SpaceTeam/STS1_EPS/(threads)

Thread 7 (2023-05-27):

Try to use other connector to the side PCBs

McBrez, 2023-05-27:
The main goal is to place the connectors on the side of the side PCB it has to connect to. The connector most likely will have to be changed, as currently there is not enough space to place them where they should be. Harwin Gecko connectors or flat flex cables could be used.

Closed 2024-09-05.

Thread 13 (2023-06-18):

Check if there is a better solution for the inter-EPS connectors

McBrez, 2023-06-18:
Currently, SAMTEC connectors are used for the connection between the two EPS boards. They have to be stacked, as there is no standard connector with the appropriate height. This is not feasible for the flight model. An alternative has to be found, that is still compatible to the CSBI specification.

Thread 15 (2024-09-04):

D12,14,15,16,17 missing value

XDjackieXD, 2024-09-04:
These diodes have no value set.

McBrez, 2024-09-05:
Fixed in commit ff7a148.

Closed 2024-10-12.

Thread 16 (2024-09-04):

Label naming confusing

XDjackieXD, 2024-09-04:
For example the Label "Bat+" and "Bat+_UCI" in the Solar Cell Connectors sheet are very confusing as Bat+ is the input from the UCI. Not Bat+_UCI.

Please define a naming schema and then stick to it.

asmolyanyuk, 2024-09-07:
On the board 1 there is a mismatch between the panel connector labels and the labels for their pin-outs . For example, Panel Z- has pin-outs marked as Panel_X+.

McBrez, 2024-09-14:
Original issue is fixed in  a812255. Created issue #28 for @asmolyanyuk  's comment.

Thread 17 (2024-09-04):

TPS259472ARPW for UART?

XDjackieXD, 2024-09-04:
Has someone tested that it works with an UART connection? The stray capacitance and turn on delay is extremely high so I suspect that it wont work (this UART has to work up to 115200 baud).

The usual solution for UART protection is a Zener/TVS Diode and a 100Ohm series resistor.

McBrez, 2024-09-14:
Removed TSP259472ARPW. Added TVS diodes to the UART lines. Didn't place 100Ohm resistor, as there is already on the COBC.
3b45b82

Thread 18 (2024-09-04):

Define tolerance for current limiting resistors on TPS259472ARPW

XDjackieXD, 2024-09-04:
As these resistors are also used as a shunt for the current measurement, please defined a required tolerance

McBrez, 2024-09-14:
Fixed in 0330bb5.

Closed 2024-10-12.

Thread 19 (2024-09-04):

Define tolerances for all critical resistors

XDjackieXD, 2024-09-04:
- Shunts
- Feedback-Networks (for example battery voltage measurement)
- Setpoint resistors for current sources

McBrez, 2024-09-14:
Fixed in e92d536.

Closed 2024-10-12.

Thread 20 (2024-09-04):

LTC4451AV ~{SHDN} on U28

XDjackieXD, 2024-09-04:
The way it is currently wired, the cubesat will be dead if the battery charger is dead, even if MPPT_BUS would still deliver enough power for some operation, because U28 is held in shutdown if VOUT is below 0.4V.

Closed 2024-10-12.

Thread 21 (2024-09-04):

Board2 D2 missing value

XDjackieXD, 2024-09-04:

McBrez, 2024-09-14:
Fixed in eb479fc2ec7f47cb72f877a4045a140e3c46f35d

Closed 2024-10-12.

Thread 22 (2024-09-04):

Mark all "bypass" resistors DNP

XDjackieXD, 2024-09-04:
KiCAD allows marking components as "Do not Populate". Use this feature to signify how it should be assembled on the flight model!

McBrez, 2024-09-14:
Fixed in 4a6f72a.

Closed 2024-10-12.

Thread 23 (2024-09-04):

Board2 Capacitor Bank Values missing

XDjackieXD, 2024-09-04:

McBrez, 2024-09-16:
Added capacitor values in d15ebe5.

Closed 2024-10-12.

Thread 24 (2024-09-04):

Board2 logic supply same issue as #20

XDjackieXD, 2024-09-04:
https://github.com/SpaceTeam/STS1_EPS/issues/20

McBrez, 2024-09-17:
Fixed in e0c62bc.

Closed 2024-10-12.

Thread 26 (2024-09-04):

Board2 Fuse F1 missing value

XDjackieXD, 2024-09-04:

McBrez, 2024-09-16:
Added part number in 04b165d.

Closed 2024-10-12.

Thread 27 (2024-09-04):

Board2 TPS2420RSAT max IO port input voltage

XDjackieXD, 2024-09-04:
Max input voltage of any logic input of the TPS2420RSAT is 5V.
The gate that inputs into it is supplied by V_LOGIC which - as far as I can tell - can be significantly above 5V.

McBrez, 2024-09-17:
Fixed in e0c62bc.

McBrez, 2024-09-18:
Added a linear regulator in b77aafa.

Closed 2024-10-12.

Thread 28 (2024-09-14):

Labels of panel connector are incorrect

McBrez, 2024-09-14:
The names of the labels on the panel connectors in STS_EPS_SC_Connectors.kicad_sch do not fit to the connector name. E.g.:  Connector J5 (Panel Z-) has labels called Panel_X+_*.

McBrez, 2024-10-12:
Fixed in [2f7f0c2](https://github.com/SpaceTeam/STS1_EPS/pull/29/commits/2f7f0c2d60b10a83120f11ea3d8951cb98012708).

Closed 2024-10-12.
