SpaceTeam/STS1_EPS/sim/battery_charge_controller.asc

C1: cap; 2µ2
C2: cap; 1µ
C3: cap; 1µ
C4: cap; 1µ
C5: cap; 100n
C6: cap; 680µ
C7: cap; 680p
C8: cap; 680p
C9: cap; 100p
C11: cap; 220n
C12: cap; 330n
C13: cap; 10
D1: schottky; RB218NS-30
D2: schottky; RBQ20NS100A
L1: ind; 680n
M1: nmos
M2: nmos
M3: nmos
M4: nmos
M5: pmos4
R1: res; 28k
R2: res; 100k
R3: res; 25k
R4: res; 25k
R5: res; 17k8
R6: res; 30k9
R7: res; 100k
R8: res; 100k
R9: res; 499k
R10: res; 200k
R11: res; 200k
R12: res; 400k
R13: res; 200k
R14: res; 50k
R15: res; 50k
R16: res; 10m
R17: res; 10m
R18: res; 10m
R19: res; 100
R20: res; 100
U1: LTC4020
V1: voltage; 5; Rser=20m
Named nets: 0, IntVcc, SW1, SW2, BST1, BST2, BAT, VFB, VFBG, PVIN, RNGSS, ILIMIT, CSP, VFBMIN, VFBMAX, VINREG, VIN, SHDN, ITH, VC, TG1, BG1, TG2, BG2, SENSBOT, SENSVIN, SENSTOP, SENSGND, CSN, BGATE
.tran 100 uic
