SpaceTeam/STS1_EPS/pcbs/STS1_EPS_1.kicad_pcb

## KiCad design pcbs/STS1_EPS_1.kicad_pcb (2025-09-17)

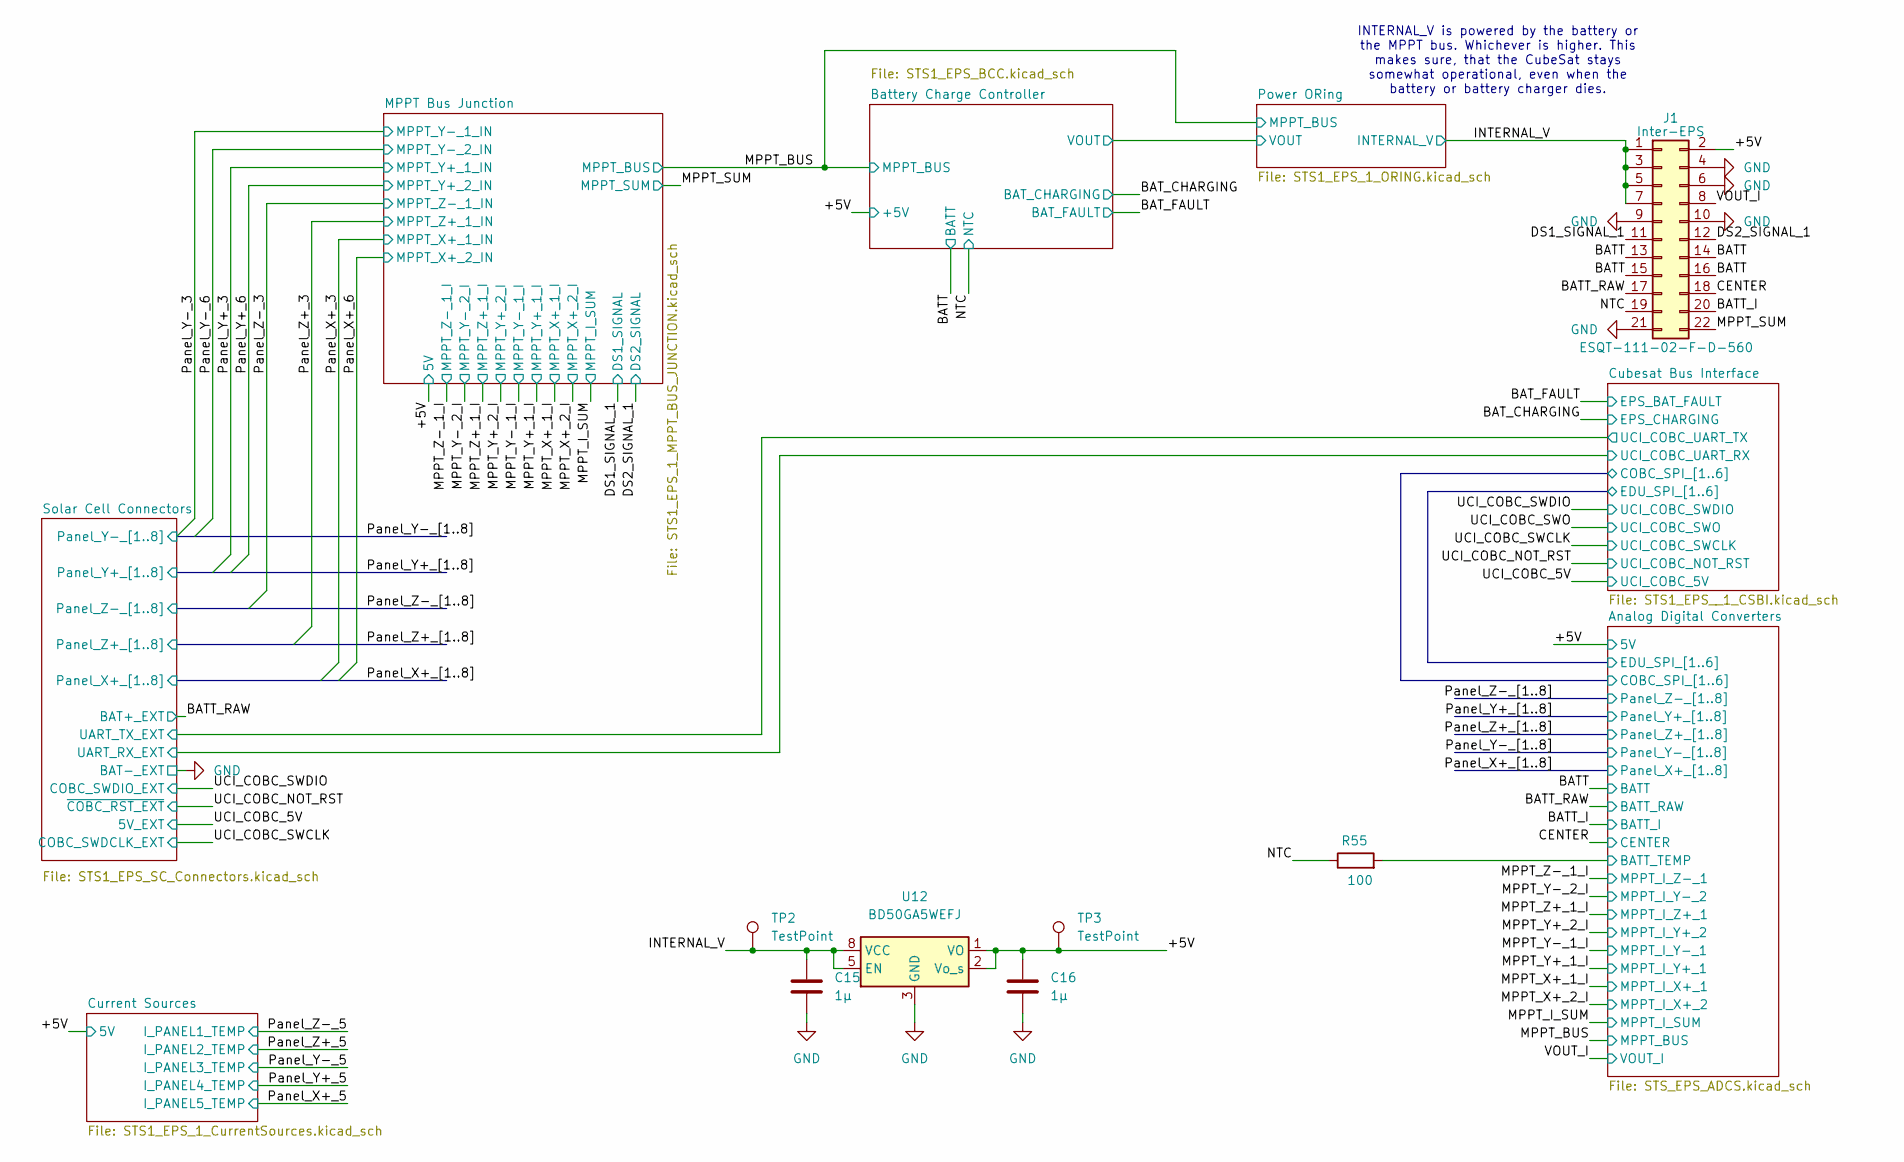
[picture p1: schematic STS1_EPS_1.kicad_sch]

Parts:
C15, C16: 1µ; C_0805_2012Metric; Part Nr. C0805T105K4RALTU
J1: Inter-EPS; PinHeader_2x11_P2.00mm_Vertical; Part# ESQT-111-02-F-D-560
R55: 100; R_0805_2012Metric; Part Nr. TNPW0805100KFEEA
TP2, TP3: TestPoint; TestPoint_THTPad_D1.0mm_Drill0.5mm
U12: BD50GA5WEFJ; HTSOP-8-1EP_3.9x4.9mm_P1.27mm_EP2.4x3.2mm

Connections:
/+5V: C16.1, J1.2, TP3.1, U12.1 (VO), U12.2 (Vo_s); also elsewhere on the board
/Analog Digital Converters/BATT_TEMP: R55.2; also elsewhere on the board
/BATT: J1.13, J1.14, J1.15, J1.16; also elsewhere on the board
/BATT_I: J1.20; also elsewhere on the board
/BATT_RAW: J1.17; also elsewhere on the board
/CENTER: J1.18; also elsewhere on the board
/DS1_SIGNAL_1: J1.11; also elsewhere on the board
/DS2_SIGNAL_1: J1.12; also elsewhere on the board
/INTERNAL_V: C15.1, J1.1, J1.3, J1.5, J1.7, TP2.1, U12.5 (EN), U12.8 (VCC); also elsewhere on the board
/MPPT_SUM: J1.22; also elsewhere on the board
/NTC: J1.19, R55.1; also elsewhere on the board
/VOUT_I: J1.8; also elsewhere on the board
GND: C15.2, C16.2, J1.4, J1.6, J1.9, J1.10, J1.21, U12.3 (GND), U12.4 (GND), U12.6 (GND), U12.7 (GND), U12.9 (GND); also elsewhere on the board

Notes on the sheet:
INTERNAL_V is powered by the battery or the MPPT bus. Whichever is higher. This makes sure, that the CubeSat stays somewhat operational, even when the battery or battery charger dies.

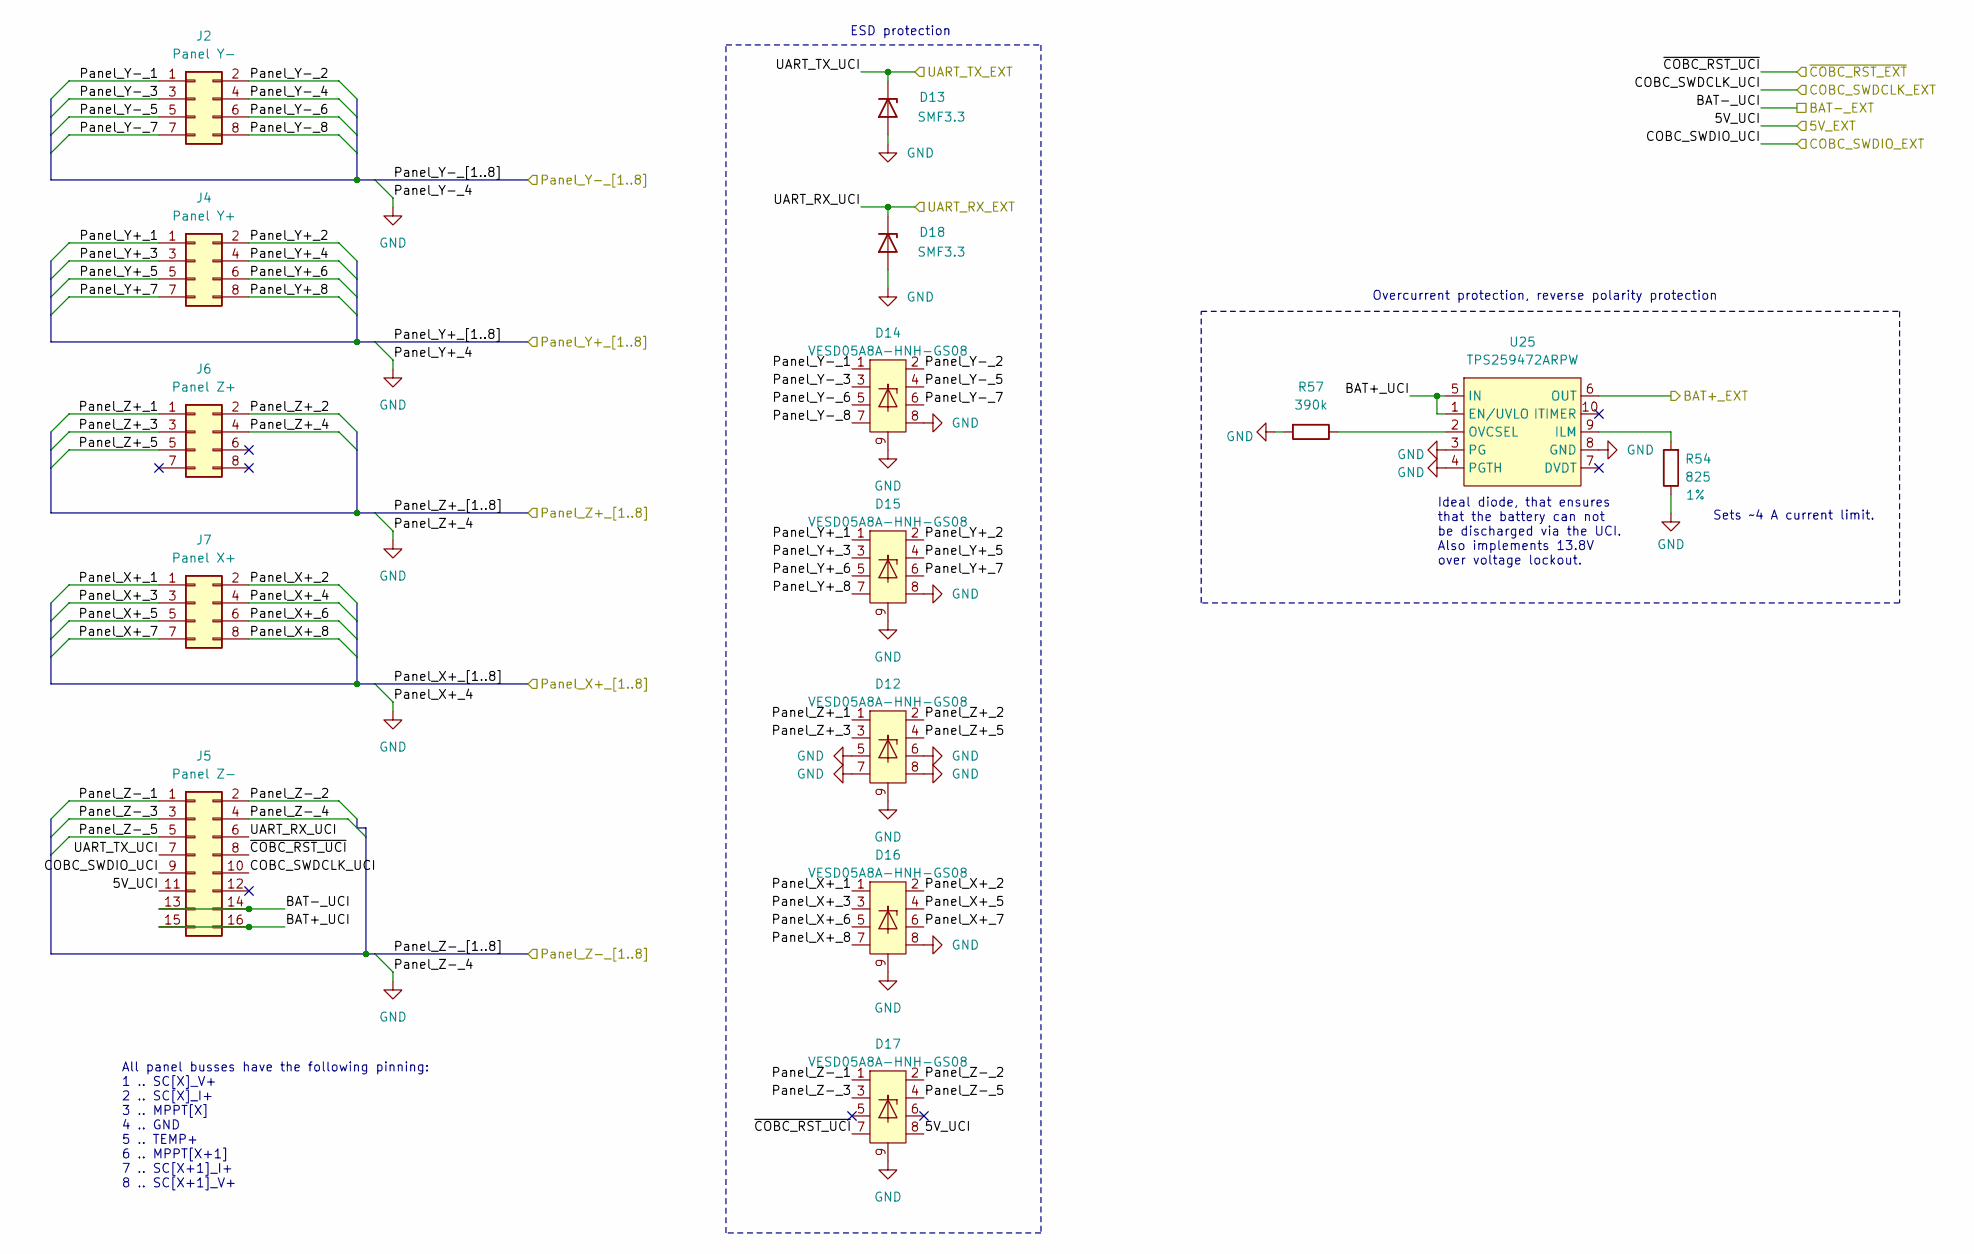
[picture p2: schematic STS1_EPS_SC_Connectors.kicad_sch]

Parts:
D12, D14, D15, D16, D17: VESD05A8A-HNH-GS08; LLP1713-9L
D13, D18: SMF3.3; D_SOD-123; Part Nr. SMF3.3
J2: Panel Y-; SAMTEC_ZF5S-08-03-T-WT; Part Nr. SAMTEC_ZF5S-08-03-T-WT
J4: Panel Y+; SAMTEC_ZF5S-08-03-T-WT; Part Nr. SAMTEC_ZF5S-08-03-T-WT
J5: Panel Z-; SAMTEC_ZF5S-16-03-T-WT; Part Nr. SAMTEC_ZF5S-08-03-T-WT
J6: Panel Z+; SAMTEC_ZF5S-08-03-T-WT; Part Nr. SAMTEC_ZF5S-08-03-T-WT
J7: Panel X+; SAMTEC_ZF5S-08-03-T-WT; Part Nr. SAMTEC_ZF5S-08-03-T-WT
R54: 825; R_0805_2012Metric; Tolerance 1%; Part Nr. RT0805FRE07825RL
R57: 390k; R_0805_2012Metric; Part Nr. RN73R2ATTD3903F25
U25: TPS259472ARPW; TPS259472ARPWR

Connections:
/BATT_RAW: U25.6 (OUT); also elsewhere on the board
/Panel_X+_1: D16.1, J7.1; also elsewhere on the board
/Panel_X+_2: D16.2, J7.2; also elsewhere on the board
/Panel_X+_3: D16.3, J7.3; also elsewhere on the board
/Panel_X+_5: D16.4, J7.5; also elsewhere on the board
/Panel_X+_6: D16.5, J7.6; also elsewhere on the board
/Panel_X+_7: D16.6, J7.7; also elsewhere on the board
/Panel_X+_8: D16.7, J7.8; also elsewhere on the board
/Panel_Y+_1: D15.1, J4.1; also elsewhere on the board
/Panel_Y+_2: D15.2, J4.2; also elsewhere on the board
/Panel_Y+_3: D15.3, J4.3; also elsewhere on the board
/Panel_Y+_5: D15.4, J4.5; also elsewhere on the board
/Panel_Y+_6: D15.5, J4.6; also elsewhere on the board
/Panel_Y+_7: D15.6, J4.7; also elsewhere on the board
/Panel_Y+_8: D15.7, J4.8; also elsewhere on the board
/Panel_Y-_1: D14.1, J2.1; also elsewhere on the board
/Panel_Y-_2: D14.2, J2.2; also elsewhere on the board
/Panel_Y-_3: D14.3, J2.3; also elsewhere on the board
/Panel_Y-_5: D14.4, J2.5; also elsewhere on the board
/Panel_Y-_6: D14.5, J2.6; also elsewhere on the board
/Panel_Y-_7: D14.6, J2.7; also elsewhere on the board
/Panel_Y-_8: D14.7, J2.8; also elsewhere on the board
/Panel_Z+_1: D12.1, J6.1; also elsewhere on the board
/Panel_Z+_2: D12.2, J6.2; also elsewhere on the board
/Panel_Z+_3: D12.3, J6.3; also elsewhere on the board
/Panel_Z+_5: D12.4, J6.5; also elsewhere on the board
/Panel_Z-_1: D17.1, J5.1; also elsewhere on the board
/Panel_Z-_2: D17.2, J5.2; also elsewhere on the board
/Panel_Z-_3: D17.3, J5.3; also elsewhere on the board
/Panel_Z-_5: D17.4, J5.5; also elsewhere on the board
/Solar Cell Connectors/BAT+_UCI: J5.15, J5.16, U25.1 (EN/UVLO), U25.5 (IN)
/Solar Cell Connectors/UART_RX_UCI: D18.1 (K), J5.6; also elsewhere on the board
/Solar Cell Connectors/UART_TX_UCI: D13.1 (K), J5.7; also elsewhere on the board
/UCI_COBC_5V: D17.8, J5.11; also elsewhere on the board
/UCI_COBC_NOT_RST: D17.7, J5.8; also elsewhere on the board
/UCI_COBC_SWCLK: J5.10; also elsewhere on the board
/UCI_COBC_SWDIO: J5.9; also elsewhere on the board
GND: D12.5, D12.6, D12.7, D12.8, D12.9, D13.2 (A), D14.8, D14.9, D15.8, D15.9, D16.8, D16.9, D17.9, D18.2 (A), J2.4, J4.4, J5.4, J5.13, J5.14, J6.4, J7.4, R54.1, R57.2, U25.3 (PG), U25.4 (PGTH), U25.8 (GND); also elsewhere on the board
unnamed: R54.2, U25.9 (ILM)
unnamed: R57.1, U25.2 (OVCSEL)

Notes on the sheet:
ESD protection
Overcurrent protection, reverse polarity protection
Sets ~4 A current limit.
Ideal diode, that ensures that the battery can not be discharged via the UCI. Also implements 13.8V over voltage lockout.
All panel busses have the following pinning: 1 .. SC[X]_V+ 2 .. SC[X]_I+ 3 .. MPPT[X] 4 .. GND 5 .. TEMP+ 6 .. MPPT[X+1] 7 .. SC[X+1]_I+ 8 .. SC[X+1]_V+

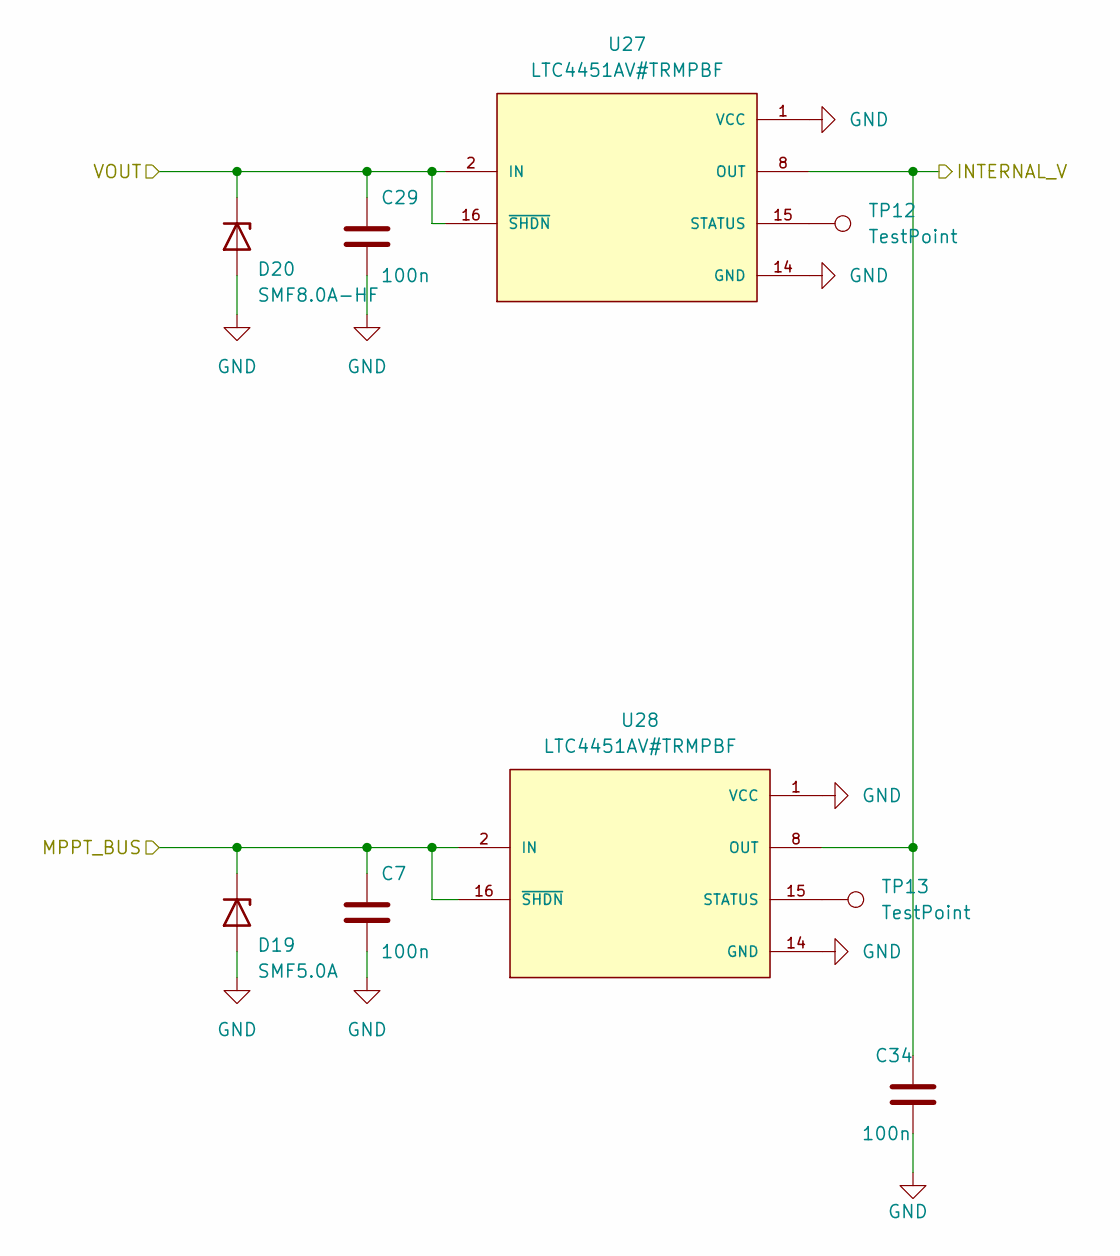
[picture p3: schematic STS1_EPS_1_ORING.kicad_sch]

Parts:
C7, C29, C34: 100n; C_0805_2012Metric; Part Nr. C0805T104K1RCLTU
D19: SMF5.0A; D_SMF; Part Nr. SMF5.0A
D20: SMF8.0A-HF; D_SOD-123F; Part Nr. SMF8.0A-HF
TP12, TP13: TestPoint; TestPoint_THTPad_D1.0mm_Drill0.5mm
U27, U28: LTC4451AV#TRMPBF; AD_LQFN-16; PARTREV 0

Connections:
/Battery Charge Controller/VOUT: C29.1, D20.1 (K), U27.2 (IN), U27.16 (~SHDN); also elsewhere on the board
/INTERNAL_V: C34.1, U27.8 (OUT), U28.8 (OUT); also elsewhere on the board
/MPPT_BUS: C7.1, D19.1 (K), U28.2 (IN), U28.16 (~SHDN); also elsewhere on the board
GND: C7.2, C29.2, C34.2, D19.2 (A), D20.2 (A), U27.1 (VCC), U27.14 (GND), U28.1 (VCC), U28.14 (GND); also elsewhere on the board
unnamed: TP12.1, U27.15 (STATUS)
unnamed: TP13.1, U28.15 (STATUS)

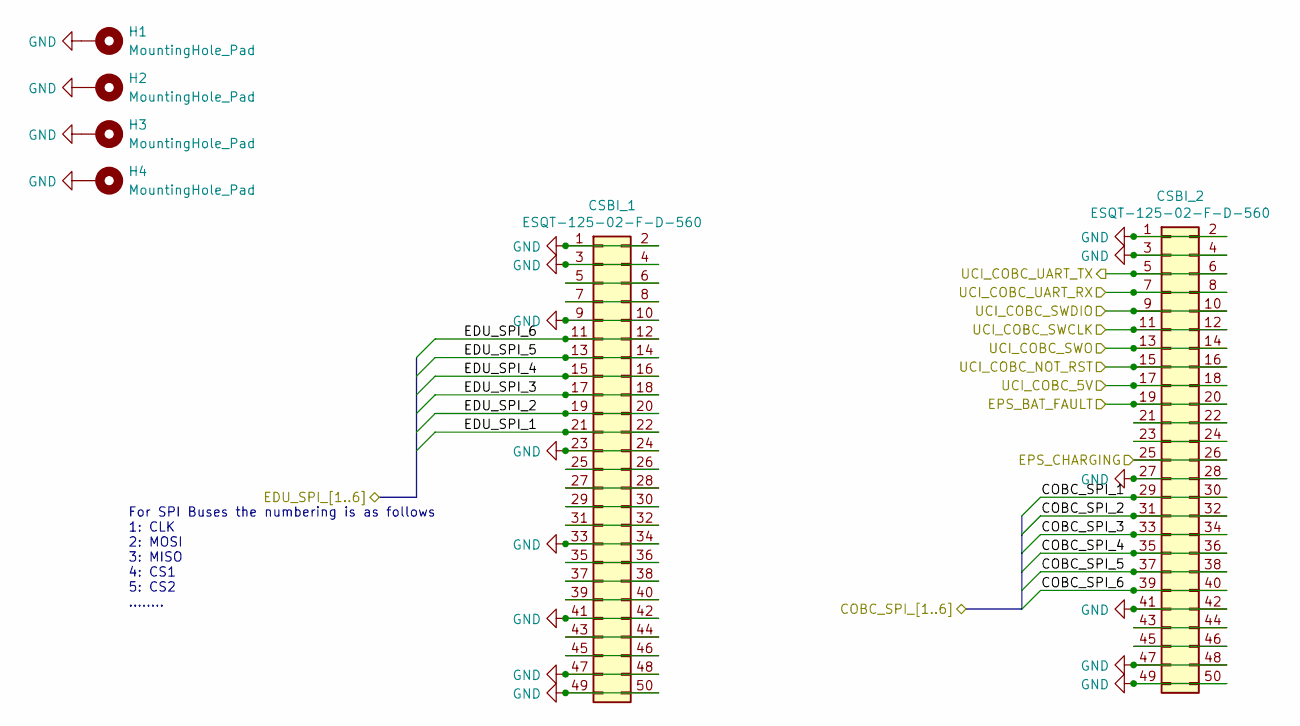
[picture p4: schematic STS1_EPS__1_CSBI.kicad_sch, STS1_connectors]

Parts:
CSBI_1, CSBI_2: ESQT-125-02-F-D-560; PinHeader_2x25_P2.00mm_Vertical; Part# ESQT-125-02-F-D-800
H1, H2, H3, H4: MountingHole_Pad; MountingHole_4.3mm_M4_Pad_Via

Connections:
/Analog Digital Converters/COBC_SPI_1: CSBI_2.29, CSBI_2.30; also elsewhere on the board
/Analog Digital Converters/COBC_SPI_2: CSBI_2.31, CSBI_2.32; also elsewhere on the board
/Analog Digital Converters/COBC_SPI_3: CSBI_2.33, CSBI_2.34; also elsewhere on the board
/Analog Digital Converters/COBC_SPI_4: CSBI_2.35, CSBI_2.36; also elsewhere on the board
/Analog Digital Converters/COBC_SPI_5: CSBI_2.37, CSBI_2.38; also elsewhere on the board
/Analog Digital Converters/COBC_SPI_6: CSBI_2.39, CSBI_2.40; also elsewhere on the board
/Analog Digital Converters/EDU_SPI_1: CSBI_1.21, CSBI_1.22; also elsewhere on the board
/Analog Digital Converters/EDU_SPI_2: CSBI_1.19, CSBI_1.20; also elsewhere on the board
/Analog Digital Converters/EDU_SPI_3: CSBI_1.17, CSBI_1.18; also elsewhere on the board
/Analog Digital Converters/EDU_SPI_4: CSBI_1.15, CSBI_1.16; also elsewhere on the board
/Analog Digital Converters/EDU_SPI_5: CSBI_1.13, CSBI_1.14; also elsewhere on the board
/Analog Digital Converters/EDU_SPI_6: CSBI_1.11, CSBI_1.12; also elsewhere on the board
/BAT_CHARGING: CSBI_2.25, CSBI_2.26; also elsewhere on the board
/BAT_FAULT: CSBI_2.19, CSBI_2.20; also elsewhere on the board
/Solar Cell Connectors/UART_RX_UCI: CSBI_2.7, CSBI_2.8; also elsewhere on the board
/Solar Cell Connectors/UART_TX_UCI: CSBI_2.5, CSBI_2.6; also elsewhere on the board
/UCI_COBC_5V: CSBI_2.17, CSBI_2.18; also elsewhere on the board
/UCI_COBC_NOT_RST: CSBI_2.15, CSBI_2.16; also elsewhere on the board
/UCI_COBC_SWCLK: CSBI_2.11, CSBI_2.12; also elsewhere on the board
/UCI_COBC_SWDIO: CSBI_2.9, CSBI_2.10; also elsewhere on the board
/UCI_COBC_SWO: CSBI_2.13, CSBI_2.14
GND: CSBI_1.1, CSBI_1.2, CSBI_1.3, CSBI_1.4, CSBI_1.9, CSBI_1.10, CSBI_1.23, CSBI_1.24, CSBI_1.33, CSBI_1.34, CSBI_1.41, CSBI_1.42, CSBI_1.47, CSBI_1.48, CSBI_1.49, CSBI_1.50, CSBI_2.1, CSBI_2.2, CSBI_2.3, CSBI_2.4, CSBI_2.27, CSBI_2.28, CSBI_2.41, CSBI_2.42, CSBI_2.47, CSBI_2.48, CSBI_2.49, CSBI_2.50, H1.1, H2.1, H3.1, H4.1; also elsewhere on the board
unnamed: CSBI_1.5, CSBI_1.6
unnamed: CSBI_1.7, CSBI_1.8
unnamed: CSBI_1.25, CSBI_1.26
unnamed: CSBI_1.27, CSBI_1.28
unnamed: CSBI_1.29, CSBI_1.30
unnamed: CSBI_1.31, CSBI_1.32
unnamed: CSBI_1.35, CSBI_1.36
unnamed: CSBI_1.37, CSBI_1.38
unnamed: CSBI_1.39, CSBI_1.40
unnamed: CSBI_1.43, CSBI_1.44
unnamed: CSBI_1.45, CSBI_1.46
unnamed: CSBI_2.21, CSBI_2.22
unnamed: CSBI_2.23, CSBI_2.24
unnamed: CSBI_2.43, CSBI_2.44
unnamed: CSBI_2.45, CSBI_2.46

Notes on the sheet:
For SPI Buses the numbering is as follows 1: CLK 2: MOSI 3: MISO 4: CS1 5: CS2 ........

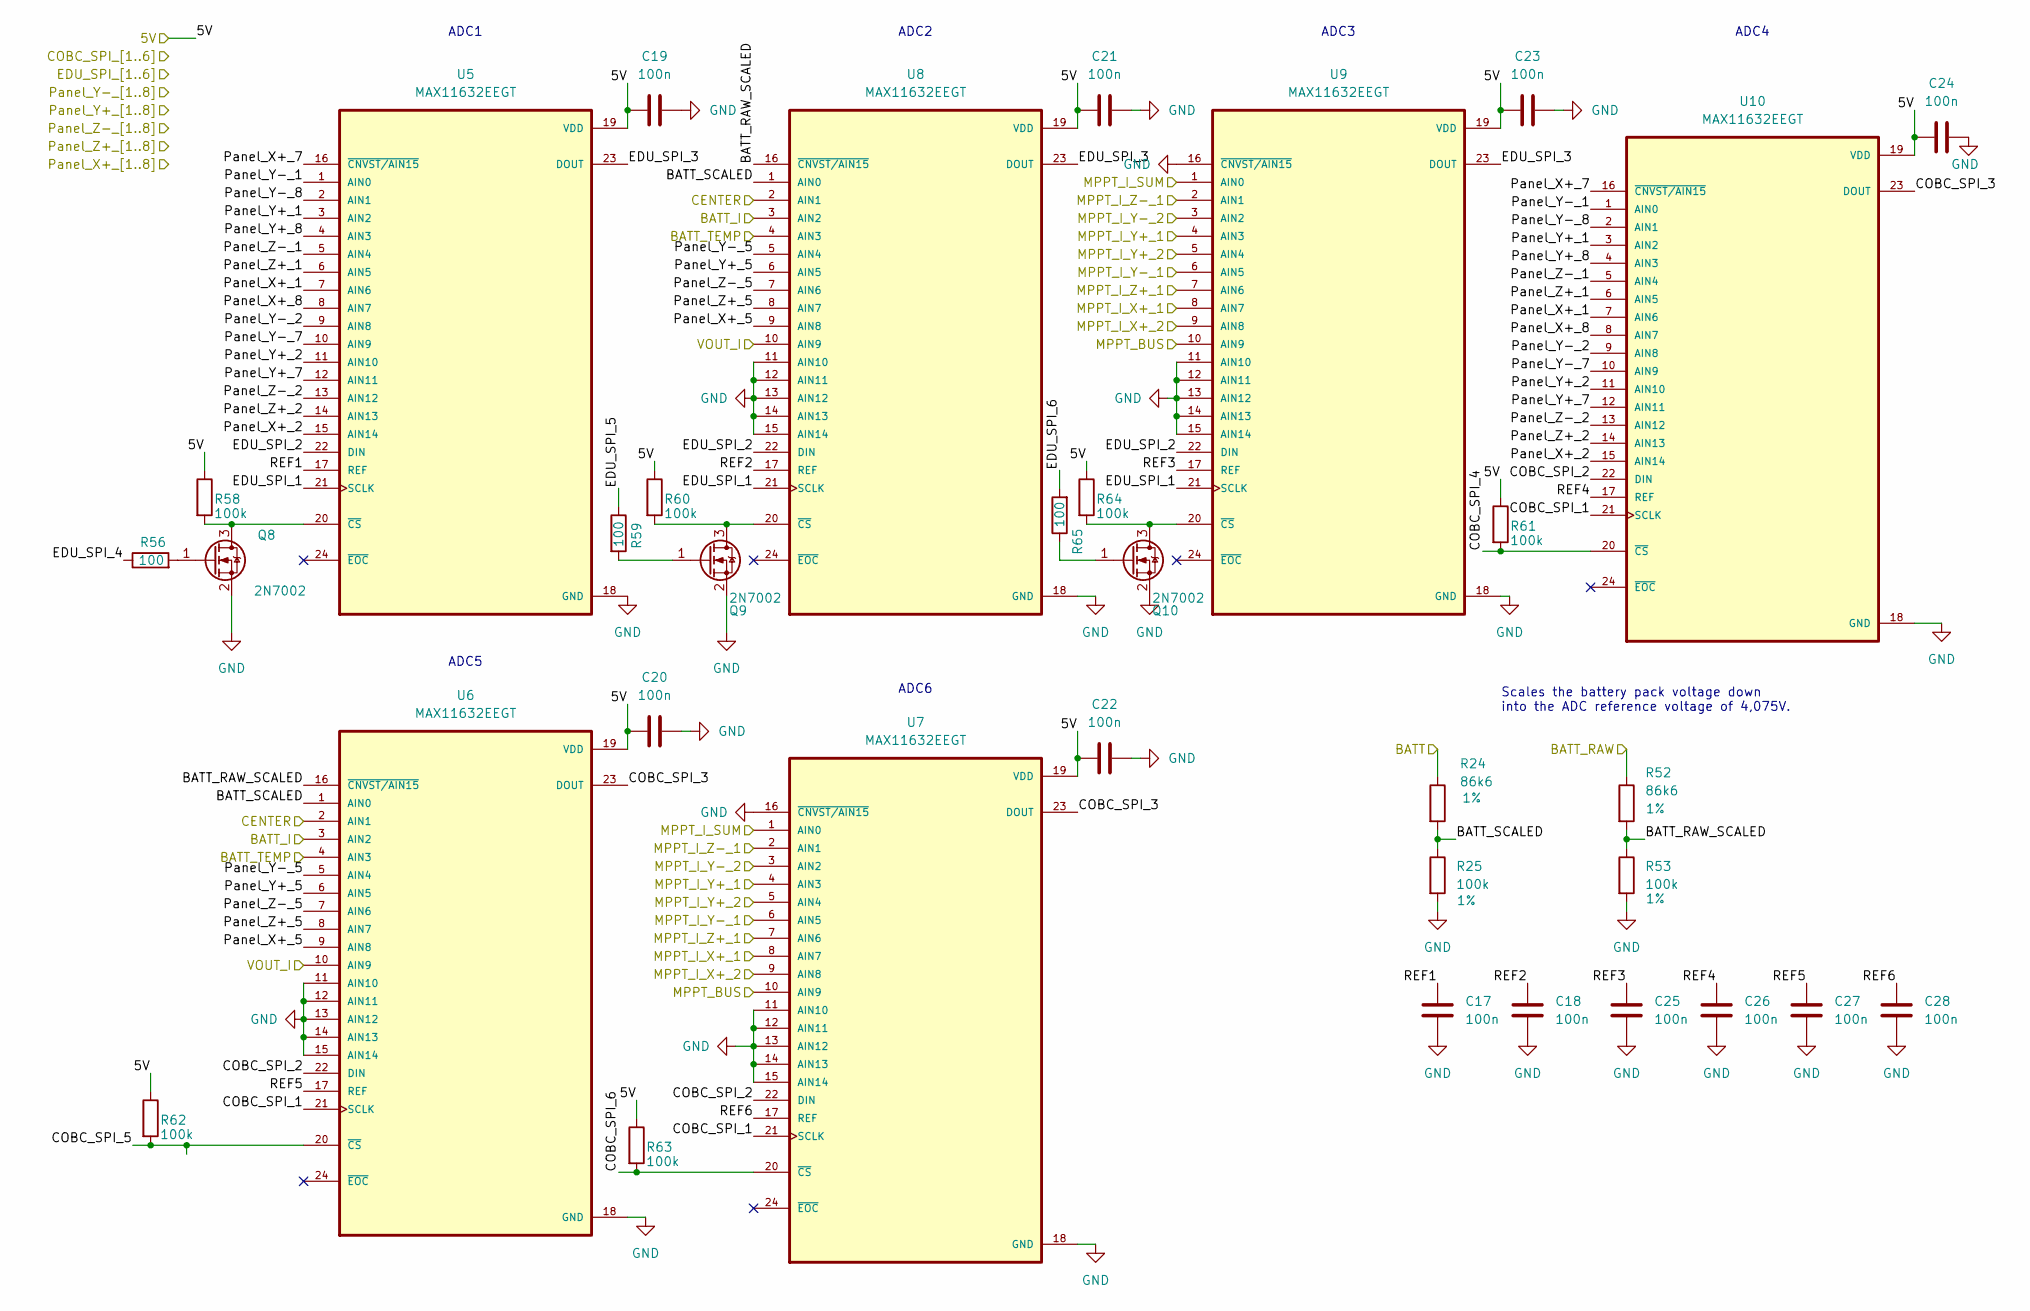
[picture p5: schematic STS_EPS_ADCS.kicad_sch]

Parts:
C17, C18, C19, C20, C21, C22, C23, C24, C25, C26, C27, C28: 100n; C_0805_2012Metric; Part Nr. C0805T104K1RCLTU
Q8, Q9, Q10: 2N7002; SOT-23; Part Nr. 2N7002
R24, R52: 86k6; R_0805_2012Metric; Tolerance 1%; Part Nr. RCA080586K6FKEA
R25, R53: 100k; R_0805_2012Metric; Tolerance 1%; Part Nr. TNPW0805100KFEEA
R56, R59, R65: 100; R_0805_2012Metric; Part Nr. TNPW0805100KFEEA
R58, R60, R61, R62, R63, R64: 100k; R_0805_2012Metric; Part Nr. TNPW0805100KFEEA
U5, U6, U7, U8, U9, U10: MAX11632EEGT; MAX_QSOP24

Connections:
/+5V: C19.1, C20.1, C21.1, C22.1, C23.1, C24.1, R58.1, R60.1, R61.1, R62.1, R63.1, R64.1, U5.19 (VDD), U6.19 (VDD), U7.19 (VDD), U8.19 (VDD), U9.19 (VDD), U10.19 (VDD); also elsewhere on the board
/Analog Digital Converters/BATT_RAW_SCALED: R52.2, R53.1, U6.16 (~CNVST/AIN15), U8.16 (~CNVST/AIN15)
/Analog Digital Converters/BATT_SCALED: R24.2, R25.1, U6.1 (AIN0), U8.1 (AIN0)
/Analog Digital Converters/BATT_TEMP: U6.4 (AIN3), U8.4 (AIN3); also elsewhere on the board
/Analog Digital Converters/COBC_SPI_1: U6.21 (SCLK), U7.21 (SCLK), U10.21 (SCLK); also elsewhere on the board
/Analog Digital Converters/COBC_SPI_2: U6.22 (DIN), U7.22 (DIN), U10.22 (DIN); also elsewhere on the board
/Analog Digital Converters/COBC_SPI_3: U6.23 (DOUT), U7.23 (DOUT), U10.23 (DOUT); also elsewhere on the board
/Analog Digital Converters/COBC_SPI_4: R61.2, U10.20 (~CS); also elsewhere on the board
/Analog Digital Converters/COBC_SPI_5: R62.2, U6.20 (~CS); also elsewhere on the board
/Analog Digital Converters/COBC_SPI_6: R63.2, U7.20 (~CS); also elsewhere on the board
/Analog Digital Converters/EDU_SPI_1: U5.21 (SCLK), U8.21 (SCLK), U9.21 (SCLK); also elsewhere on the board
/Analog Digital Converters/EDU_SPI_2: U5.22 (DIN), U8.22 (DIN), U9.22 (DIN); also elsewhere on the board
/Analog Digital Converters/EDU_SPI_3: U5.23 (DOUT), U8.23 (DOUT), U9.23 (DOUT); also elsewhere on the board
/Analog Digital Converters/EDU_SPI_4: R56.1; also elsewhere on the board
/Analog Digital Converters/EDU_SPI_5: R59.1; also elsewhere on the board
/Analog Digital Converters/EDU_SPI_6: R65.2; also elsewhere on the board
/Analog Digital Converters/REF1: C17.2, U5.17 (REF)
/Analog Digital Converters/REF2: C18.2, U8.17 (REF)
/Analog Digital Converters/REF3: C25.2, U9.17 (REF)
/Analog Digital Converters/REF4: C26.2, U10.17 (REF)
/Analog Digital Converters/REF5: C27.2, U6.17 (REF)
/Analog Digital Converters/REF6: C28.2, U7.17 (REF)
/BATT: R24.1; also elsewhere on the board
/BATT_I: U6.3 (AIN2), U8.3 (AIN2); also elsewhere on the board
/BATT_RAW: R52.1; also elsewhere on the board
/CENTER: U6.2 (AIN1), U8.2 (AIN1); also elsewhere on the board
/MPPT_BUS: U7.10 (AIN9), U9.10 (AIN9); also elsewhere on the board
/MPPT_I_SUM: U7.1 (AIN0), U9.1 (AIN0); also elsewhere on the board
/MPPT_X+_1_I: U7.8 (AIN7), U9.8 (AIN7); also elsewhere on the board
/MPPT_X+_2_I: U7.9 (AIN8), U9.9 (AIN8); also elsewhere on the board
/MPPT_Y+_1_I: U7.4 (AIN3), U9.4 (AIN3); also elsewhere on the board
/MPPT_Y+_2_I: U7.5 (AIN4), U9.5 (AIN4); also elsewhere on the board
/MPPT_Y-_1_I: U7.6 (AIN5), U9.6 (AIN5); also elsewhere on the board
/MPPT_Y-_2_I: U7.3 (AIN2), U9.3 (AIN2); also elsewhere on the board
/MPPT_Z+_1_I: U7.7 (AIN6), U9.7 (AIN6); also elsewhere on the board
/MPPT_Z-_1_I: U7.2 (AIN1), U9.2 (AIN1); also elsewhere on the board
/Panel_X+_1: U5.7 (AIN6), U10.7 (AIN6); also elsewhere on the board
/Panel_X+_2: U5.15 (AIN14), U10.15 (AIN14); also elsewhere on the board
/Panel_X+_5: U6.9 (AIN8), U8.9 (AIN8); also elsewhere on the board
/Panel_X+_7: U5.16 (~CNVST/AIN15), U10.16 (~CNVST/AIN15); also elsewhere on the board
/Panel_X+_8: U5.8 (AIN7), U10.8 (AIN7); also elsewhere on the board
/Panel_Y+_1: U5.3 (AIN2), U10.3 (AIN2); also elsewhere on the board
/Panel_Y+_2: U5.11 (AIN10), U10.11 (AIN10); also elsewhere on the board
/Panel_Y+_5: U6.6 (AIN5), U8.6 (AIN5); also elsewhere on the board
/Panel_Y+_7: U5.12 (AIN11), U10.12 (AIN11); also elsewhere on the board
/Panel_Y+_8: U5.4 (AIN3), U10.4 (AIN3); also elsewhere on the board
/Panel_Y-_1: U5.1 (AIN0), U10.1 (AIN0); also elsewhere on the board
/Panel_Y-_2: U5.9 (AIN8), U10.9 (AIN8); also elsewhere on the board
/Panel_Y-_5: U6.5 (AIN4), U8.5 (AIN4); also elsewhere on the board
/Panel_Y-_7: U5.10 (AIN9), U10.10 (AIN9); also elsewhere on the board
/Panel_Y-_8: U5.2 (AIN1), U10.2 (AIN1); also elsewhere on the board
/Panel_Z+_1: U5.6 (AIN5), U10.6 (AIN5); also elsewhere on the board
/Panel_Z+_2: U5.14 (AIN13), U10.14 (AIN13); also elsewhere on the board
/Panel_Z+_5: U6.8 (AIN7), U8.8 (AIN7); also elsewhere on the board
/Panel_Z-_1: U5.5 (AIN4), U10.5 (AIN4); also elsewhere on the board
/Panel_Z-_2: U5.13 (AIN12), U10.13 (AIN12); also elsewhere on the board
/Panel_Z-_5: U6.7 (AIN6), U8.7 (AIN6); also elsewhere on the board
/VOUT_I: U6.10 (AIN9), U8.10 (AIN9); also elsewhere on the board
GND: C17.1, C18.1, C19.2, C20.2, C21.2, C22.2, C23.2, C24.2, C25.1, C26.1, C27.1, C28.1, Q8.2 (S), Q9.2 (S), Q10.2 (S), R25.2, R53.2, U5.18 (GND), U6.11 (AIN10), U6.12 (AIN11), U6.13 (AIN12), U6.14 (AIN13), U6.15 (AIN14), U6.18 (GND), U7.11 (AIN10), U7.12 (AIN11), U7.13 (AIN12), U7.14 (AIN13), U7.15 (AIN14), U7.16 (~CNVST/AIN15), U7.18 (GND), U8.11 (AIN10), U8.12 (AIN11), U8.13 (AIN12), U8.14 (AIN13), U8.15 (AIN14), U8.18 (GND), U9.11 (AIN10), U9.12 (AIN11), U9.13 (AIN12), U9.14 (AIN13), U9.15 (AIN14), U9.16 (~CNVST/AIN15), U9.18 (GND), U10.18 (GND); also elsewhere on the board
unnamed: Q8.3 (D), R58.2, U5.20 (~CS)
unnamed: Q8.1 (G), R56.2
unnamed: Q9.3 (D), R60.2, U8.20 (~CS)
unnamed: Q9.1 (G), R59.2
unnamed: Q10.3 (D), R64.2, U9.20 (~CS)
unnamed: Q10.1 (G), R65.1

Notes on the sheet:
ADC5
ADC4
ADC6
ADC2
Scales the battery pack voltage down into the ADC reference voltage of 4,075V.
ADC3
ADC1

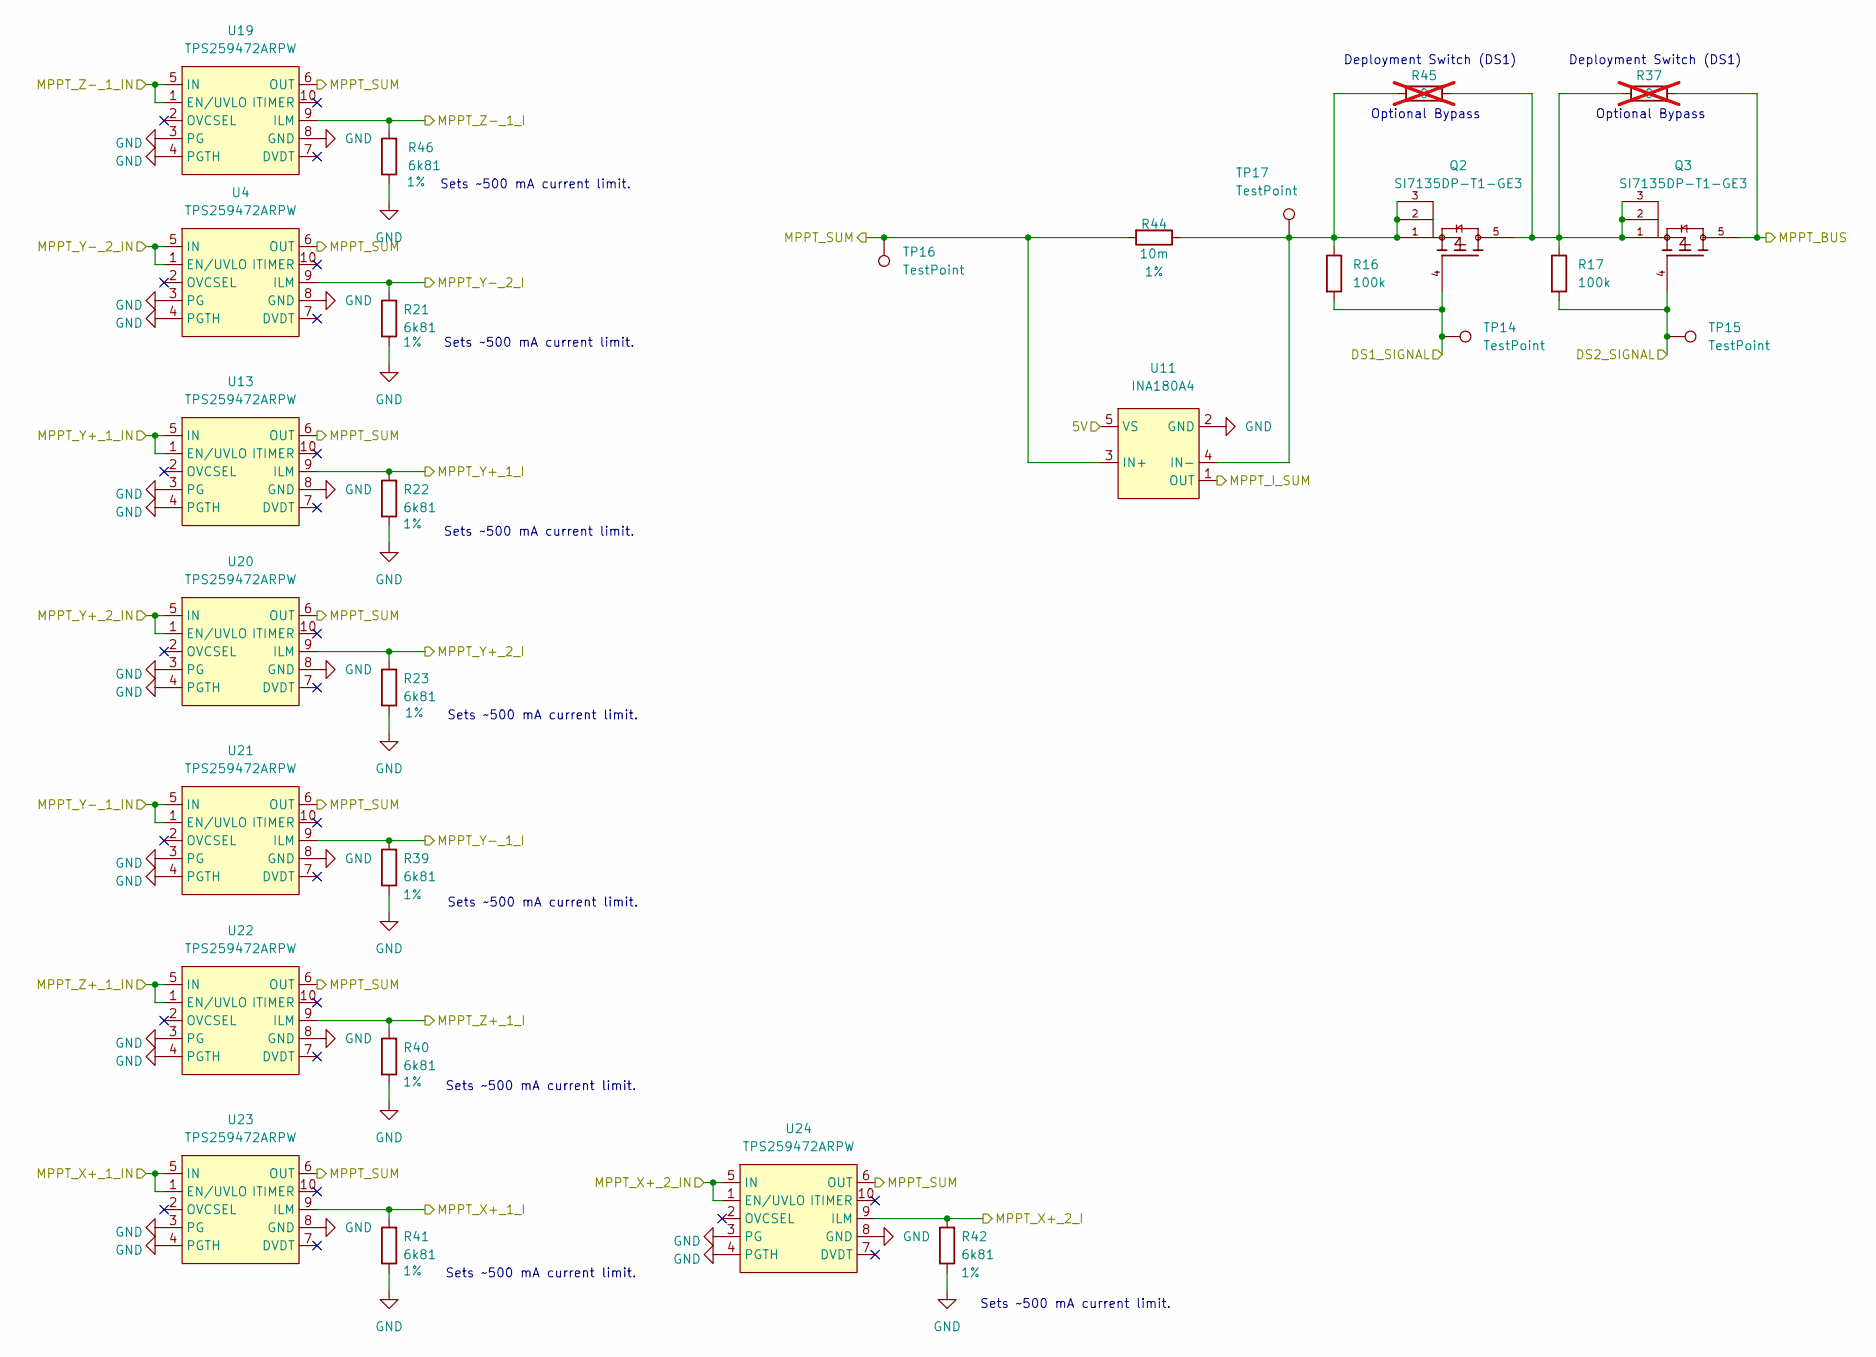
[picture p6: schematic STS1_EPS_1_MPPT_BUS_JUNCTION.kicad_sch]

Parts:
Q2, Q3: SI7135DP-T1-GE3; POWERPAK_SO8_single; PARTREV A
R16, R17: 100k; R_0805_2012Metric; Part Nr. TNPW0805100KFEEA
R21, R22, R23, R39, R40, R41, R42, R46: 6k81; R_0805_2012Metric; Tolerance 1%; Part Nr. MCU08050C6811FP500
R37, R45: 0; R_0805_2012Metric; not fitted
R44: 10m; R_0805_2012Metric; Tolerance 1%; Part Nr. WFC0805R0100FE66
TP14, TP15, TP16, TP17: TestPoint; TestPoint_THTPad_D1.0mm_Drill0.5mm
U4, U13, U19, U20, U21, U22, U23, U24: TPS259472ARPW; TPS259472ARPWR
U11: INA180A4; SOT-23-5

Connections:
/+5V: U11.5 (VS); also elsewhere on the board
/DS1_SIGNAL_1: Q2.4, R16.2, TP14.1; also elsewhere on the board
/DS2_SIGNAL_1: Q3.4, R17.2, TP15.1; also elsewhere on the board
/MPPT_BUS: Q3.5, R37.2; also elsewhere on the board
/MPPT_I_SUM: U11.1 (OUT); also elsewhere on the board
/MPPT_SUM: R44.2, TP16.1, U4.6 (OUT), U11.3 (IN+), U13.6 (OUT), U19.6 (OUT), U20.6 (OUT), U21.6 (OUT), U22.6 (OUT), U23.6 (OUT), U24.6 (OUT); also elsewhere on the board
/MPPT_X+_1_I: R41.2, U23.9 (ILM); also elsewhere on the board
/MPPT_X+_2_I: R42.2, U24.9 (ILM); also elsewhere on the board
/MPPT_Y+_1_I: R22.2, U13.9 (ILM); also elsewhere on the board
/MPPT_Y+_2_I: R23.2, U20.9 (ILM); also elsewhere on the board
/MPPT_Y-_1_I: R39.2, U21.9 (ILM); also elsewhere on the board
/MPPT_Y-_2_I: R21.2, U4.9 (ILM); also elsewhere on the board
/MPPT_Z+_1_I: R40.2, U22.9 (ILM); also elsewhere on the board
/MPPT_Z-_1_I: R46.2, U19.9 (ILM); also elsewhere on the board
/Panel_X+_3: U23.1 (EN/UVLO), U23.5 (IN); also elsewhere on the board
/Panel_X+_6: U24.1 (EN/UVLO), U24.5 (IN); also elsewhere on the board
/Panel_Y+_3: U13.1 (EN/UVLO), U13.5 (IN); also elsewhere on the board
/Panel_Y+_6: U20.1 (EN/UVLO), U20.5 (IN); also elsewhere on the board
/Panel_Y-_3: U21.1 (EN/UVLO), U21.5 (IN); also elsewhere on the board
/Panel_Y-_6: U4.1 (EN/UVLO), U4.5 (IN); also elsewhere on the board
/Panel_Z+_3: U22.1 (EN/UVLO), U22.5 (IN); also elsewhere on the board
/Panel_Z-_3: U19.1 (EN/UVLO), U19.5 (IN); also elsewhere on the board
GND: R21.1, R22.1, R23.1, R39.1, R40.1, R41.1, R42.1, R46.1, U4.3 (PG), U4.4 (PGTH), U4.8 (GND), U11.2 (GND), U13.3 (PG), U13.4 (PGTH), U13.8 (GND), U19.3 (PG), U19.4 (PGTH), U19.8 (GND), U20.3 (PG), U20.4 (PGTH), U20.8 (GND), U21.3 (PG), U21.4 (PGTH), U21.8 (GND), U22.3 (PG), U22.4 (PGTH), U22.8 (GND), U23.3 (PG), U23.4 (PGTH), U23.8 (GND), U24.3 (PG), U24.4 (PGTH), U24.8 (GND); also elsewhere on the board
unnamed: Q2.5, Q3.1, Q3.2, Q3.3, R17.1, R37.1, R45.2
unnamed: Q2.1, Q2.2, Q2.3, R16.1, R44.1, R45.1, TP17.1, U11.4 (IN-)

Notes on the sheet:
Sets ~500 mA current limit.
Deployment Switch (DS1)
Optional Bypass
