SpaceTeam/STS1_EPS/pcbs/STS1_EPS_1.kicad_pcb

## KiCad design pcbs/STS1_EPS_1.kicad_pcb (continued)

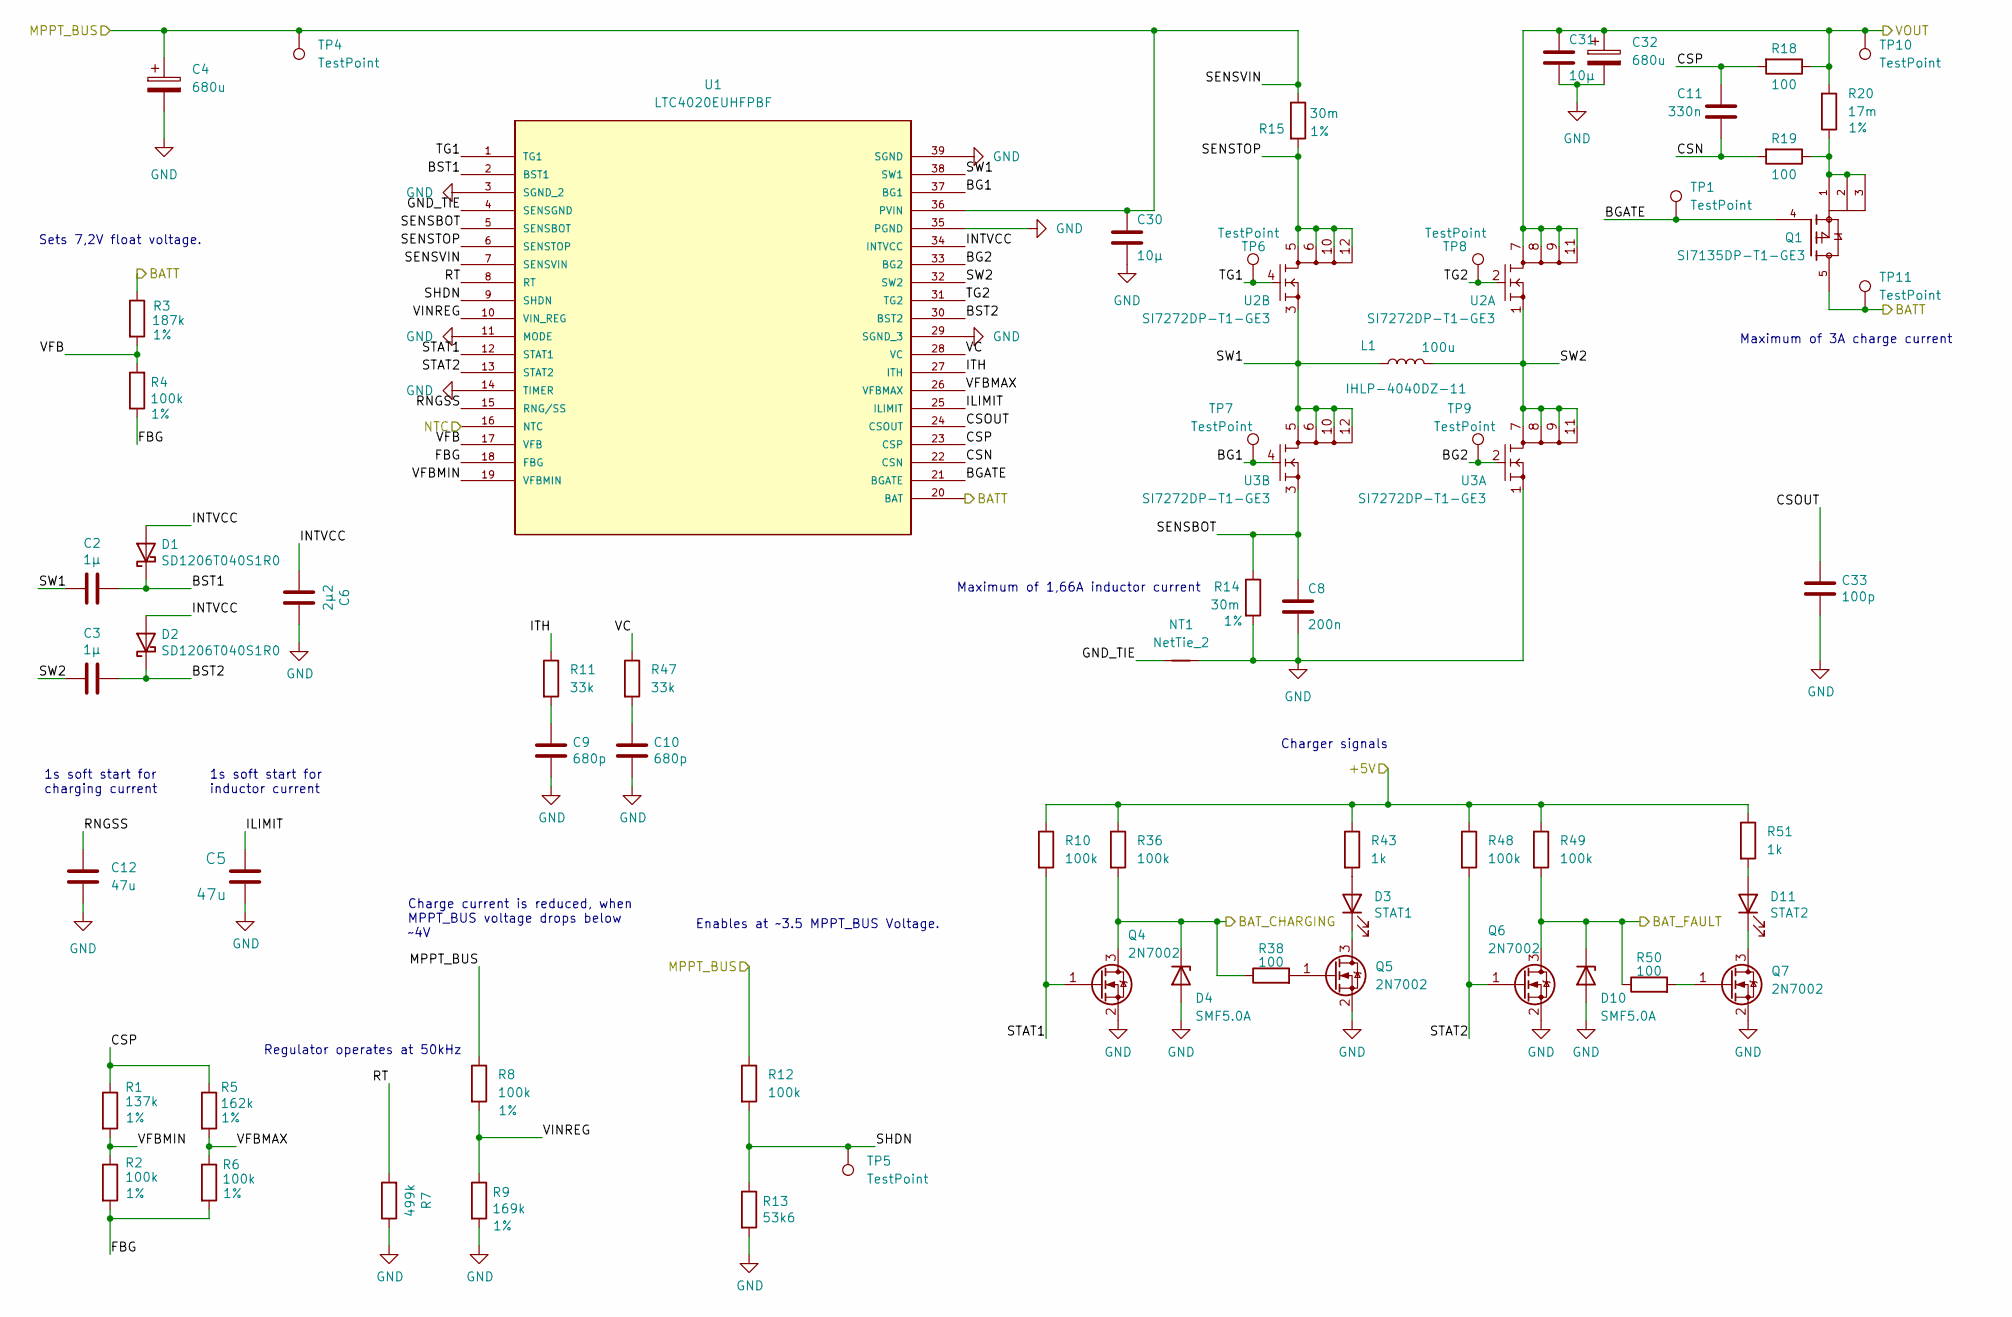
[picture p7: schematic STS1_EPS_BCC.kicad_sch]

Parts:
C2, C3: 1µ; C_0805_2012Metric; Part Nr. C0805T105K4RALTU
C4, C32: 680u; CP_EIA-7343-43_Kemet-X; Part Nr. TPSE687M010R0150V
C5, C12: 47u; CP_EIA-3528-12_Kemet-T; Part Nr. TP3B476K010C1800AS
C6: 2µ2; C_0805_2012Metric; Part Nr. C0805T225K4RACTU
C8: 200n; C_0805_2012Metric; Part Nr. GCM219R71C204JA37J
C9, C10: 680p; C_0805_2012Metric; Part Nr. 08051C681JAT2A
C11: 330n; C_0805_2012Metric; Part Nr. C0805T334K3RCLTM
C30, C31: 10µ; C_0805_2012Metric; Part Nr. CM21X7R106K06AT
C33: 100p; C_0805_2012Metric; Part Nr. C0805T104J5RALTU
D1, D2: SD1206T040S1R0; D_1206_3216Metric; Part Nr. SD1206T040S1R0
D3: STAT1; LED_0805_2012Metric
D4, D10: SMF5.0A; D_SMF; Part Nr. SMF5.0A
D11: STAT2; LED_0805_2012Metric
L1: 100u; L_Vishay_IHLP-4040; Part IHLP-4040DZ-11
NT1: NetTie_2; NetTie-2_SMD_Pad0.5mm
Q1: SI7135DP-T1-GE3; POWERPAK_SO8_single; PARTREV A
Q4, Q5, Q6, Q7: 2N7002; SOT-23; Part Nr. 2N7002
R1: 137k; R_0805_2012Metric; Tolerance 1%; Part Nr. CR0805-FX-1373ELF
R2, R4, R6, R8: 100k; R_0805_2012Metric; Tolerance 1%; Part Nr. TNPW0805100KFEEA
R3: 187k; R_0805_2012Metric; Tolerance 1%; Part Nr. AA0805FR-07187KL
R5: 162k; R_0805_2012Metric; Tolerance 1%; Part Nr. CR0805-FX-1623ELF
R7: 499k; R_0805_2012Metric; Part Nr. CR0805-FX-4993ELF
R9: 169k; R_0805_2012Metric; Tolerance 1%; Part Nr. RE0805FRE07169KL
R10, R12, R36, R48, R49: 100k; R_0805_2012Metric; Part Nr. TNPW0805100KFEEA
R11, R47: 33k; R_0805_2012Metric; Part Nr. KTR10EZPF3302
R13: 53k6; R_0805_2012Metric; Part Nr. CR0805-FX-5362ELF
R14, R15: 30m; R_0805_2012Metric; Tolerance 1%; Part Nr. WSL0805R0300FEA
R18, R19, R38, R50: 100; R_0805_2012Metric; Part Nr. TNPW0805100RFETA
R20: 17m; R_1206_3216Metric; Tolerance 1%; Part Nr. PE1206FRF7W0R017L
R43, R51: 1k; R_0805_2012Metric; Part Nr. CRT0805AFY-1001ELF
TP1, TP4, TP5, TP6, TP7, TP8, TP9, TP10, TP11: TestPoint; TestPoint_THTPad_D1.0mm_Drill0.5mm
U1: LTC4020EUHFPBF; AD_QFN-38_UHF; MANUFACTURER_PART_NUMBER ltc4020euhf#pbf
U2, U3: SI7272DP-T1-GE3; POWERPAK_SO8

Connections:
/+5V: R10.1, R36.1, R43.1, R48.1, R49.1, R51.1; also elsewhere on the board
/BATT: Q1.5, R3.1, TP11.1, U1.20 (BAT); also elsewhere on the board
/BAT_CHARGING: D4.1 (K), Q4.3 (D), R36.2, R38.1; also elsewhere on the board
/BAT_FAULT: D10.1 (K), Q6.3 (D), R49.2, R50.1; also elsewhere on the board
/Battery Charge Controller/BG1: TP7.1, U1.37 (BG1), U3.4 (G2)
/Battery Charge Controller/BG2: TP9.1, U1.33 (BG2), U3.2 (G1)
/Battery Charge Controller/BGATE: Q1.4, TP1.1, U1.21 (BGATE)
/Battery Charge Controller/BST1: C2.1, D1.1 (K), U1.2 (BST1)
/Battery Charge Controller/BST2: C3.1, D2.1 (K), U1.30 (BST2)
/Battery Charge Controller/CSN: C11.2, R19.2, U1.22 (CSN)
/Battery Charge Controller/CSOUT: C33.1, U1.24 (CSOUT)
/Battery Charge Controller/CSP: C11.1, R1.1, R5.1, R18.2, U1.23 (CSP)
/Battery Charge Controller/FBG: R2.2, R4.1, R6.2, U1.18 (FBG)
/Battery Charge Controller/GND_TIE: NT1.1, U1.4 (SENSGND)
/Battery Charge Controller/ILIMIT: C5.2, U1.25 (ILIMIT)
/Battery Charge Controller/INTVCC: C6.2, D1.2 (A), D2.2 (A), U1.34 (INTVCC)
/Battery Charge Controller/ITH: R11.1, U1.27 (ITH)
/Battery Charge Controller/RNGSS: C12.1, U1.15 (RNG/SS)
/Battery Charge Controller/RT: R7.2, U1.8 (RT)
/Battery Charge Controller/SENSBOT: C8.2, R14.1, U1.5 (SENSBOT), U3.3 (S2)
/Battery Charge Controller/SENSTOP: R15.2, U1.6 (SENSTOP), U2.5 (D2_1), U2.6 (D2_2), U2.10 (D2_3), U2.12 (D2_4)
/Battery Charge Controller/SHDN: R12.2, R13.1, TP5.1, U1.9 (SHDN)
/Battery Charge Controller/STAT1: Q4.1 (G), R10.2, U1.12 (STAT1)
/Battery Charge Controller/STAT2: Q6.1 (G), R48.2, U1.13 (STAT2)
/Battery Charge Controller/SW1: C2.2, L1.1, U1.38 (SW1), U2.3 (S2), U3.5 (D2_1), U3.6 (D2_2), U3.10 (D2_3), U3.12 (D2_4)
/Battery Charge Controller/SW2: C3.2, L1.2, U1.32 (SW2), U2.1 (S1), U3.7 (D1_1), U3.8 (D1_2), U3.9 (D1_3), U3.11 (D1_4)
/Battery Charge Controller/TG1: TP6.1, U1.1 (TG1), U2.4 (G2)
/Battery Charge Controller/TG2: TP8.1, U1.31 (TG2), U2.2 (G1)
/Battery Charge Controller/VC: R47.1, U1.28 (VC)
/Battery Charge Controller/VFB: R3.2, R4.2, U1.17 (VFB)
/Battery Charge Controller/VFBMAX: R5.2, R6.1, U1.26 (VFBMAX)
/Battery Charge Controller/VFBMIN: R1.2, R2.1, U1.19 (VFBMIN)
/Battery Charge Controller/VINREG: R8.2, R9.1, U1.10 (VIN_REG)
/Battery Charge Controller/VOUT: C31.2, C32.1, R18.1, R20.2, TP10.1, U2.7 (D1_1), U2.8 (D1_2), U2.9 (D1_3), U2.11 (D1_4); also elsewhere on the board
/MPPT_BUS: C4.1, C30.2, R8.1, R12.1, R15.1, TP4.1, U1.7 (SENSVIN), U1.36 (PVIN); also elsewhere on the board
/NTC: U1.16 (NTC); also elsewhere on the board
GND: C4.2, C5.1, C6.1, C8.1, C9.2, C10.2, C12.2, C30.1, C31.1, C32.2, C33.2, D4.2 (A), D10.2 (A), NT1.2, Q4.2 (S), Q5.2 (S), Q6.2 (S), Q7.2 (S), R7.1, R9.2, R13.2, R14.2, U1.3 (SGND_2), U1.11 (MODE), U1.14 (TIMER), U1.29 (SGND_3), U1.35 (PGND), U1.39 (SGND), U3.1 (S1); also elsewhere on the board
unnamed: C9.1, R11.2
unnamed: C10.1, R47.2
unnamed: D3.2 (A), R43.2
unnamed: D3.1 (K), Q5.3 (D)
unnamed: D11.2 (A), R51.2
unnamed: D11.1 (K), Q7.3 (D)
unnamed: Q1.1, Q1.2, Q1.3, R19.1, R20.1
unnamed: Q5.1 (G), R38.2
unnamed: Q7.1 (G), R50.2

Notes on the sheet:
Charger signals
Regulator operates at 50kHz
Sets 7,2V float voltage.
Charge current is reduced, when MPPT_BUS voltage drops below ~4V
Maximum of 1,66A inductor current
Enables at ~3.5 MPPT_BUS Voltage.
1s soft start for inductor current
1s soft start for charging current
Maximum of 3A charge current

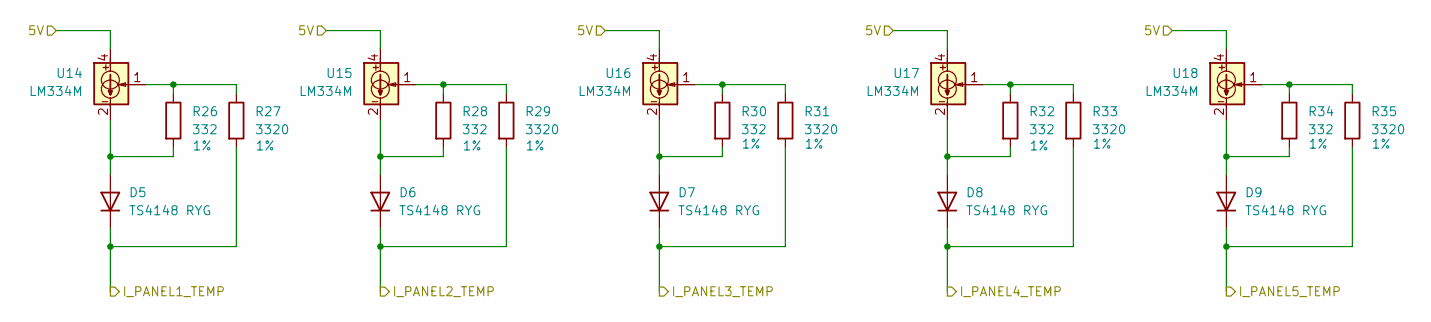
[picture p8: schematic STS1_EPS_1_CurrentSources.kicad_sch]

Parts:
D5, D6, D7, D8, D9: TS4148 RYG; D_0805_2012Metric; Part Nr. TS4148 RYG
R26, R28, R30, R32, R34: 332; R_0805_2012Metric; Tolerance 1%; Part Nr. RT0805FRE07332RL
R27, R29, R31, R33, R35: 3320; R_0805_2012Metric; Tolerance 1%; Part Nr. RT0805FRE073K32L
U14, U15, U16, U17, U18: LM334M; SOIC-8_3.9x4.9mm_P1.27mm

Connections:
/+5V: U14.4, U15.4, U16.4, U17.4, U18.4; also elsewhere on the board
/Panel_X+_5: D9.1 (K), R35.2; also elsewhere on the board
/Panel_Y+_5: D8.1 (K), R33.2; also elsewhere on the board
/Panel_Y-_5: D7.1 (K), R31.2; also elsewhere on the board
/Panel_Z+_5: D6.1 (K), R29.2; also elsewhere on the board
/Panel_Z-_5: D5.1 (K), R27.2; also elsewhere on the board
unnamed: D5.2 (A), R26.2, U14.2, U14.3, U14.6, U14.7
unnamed: D6.2 (A), R28.2, U15.2, U15.3, U15.6, U15.7
unnamed: D7.2 (A), R30.2, U16.2, U16.3, U16.6, U16.7
unnamed: D8.2 (A), R32.2, U17.2, U17.3, U17.6, U17.7
unnamed: D9.2 (A), R34.2, U18.2, U18.3, U18.6, U18.7
unnamed: R26.1, R27.1, U14.1
unnamed: R28.1, R29.1, U15.1
unnamed: R30.1, R31.1, U16.1
unnamed: R32.1, R33.1, U17.1
unnamed: R34.1, R35.1, U18.1

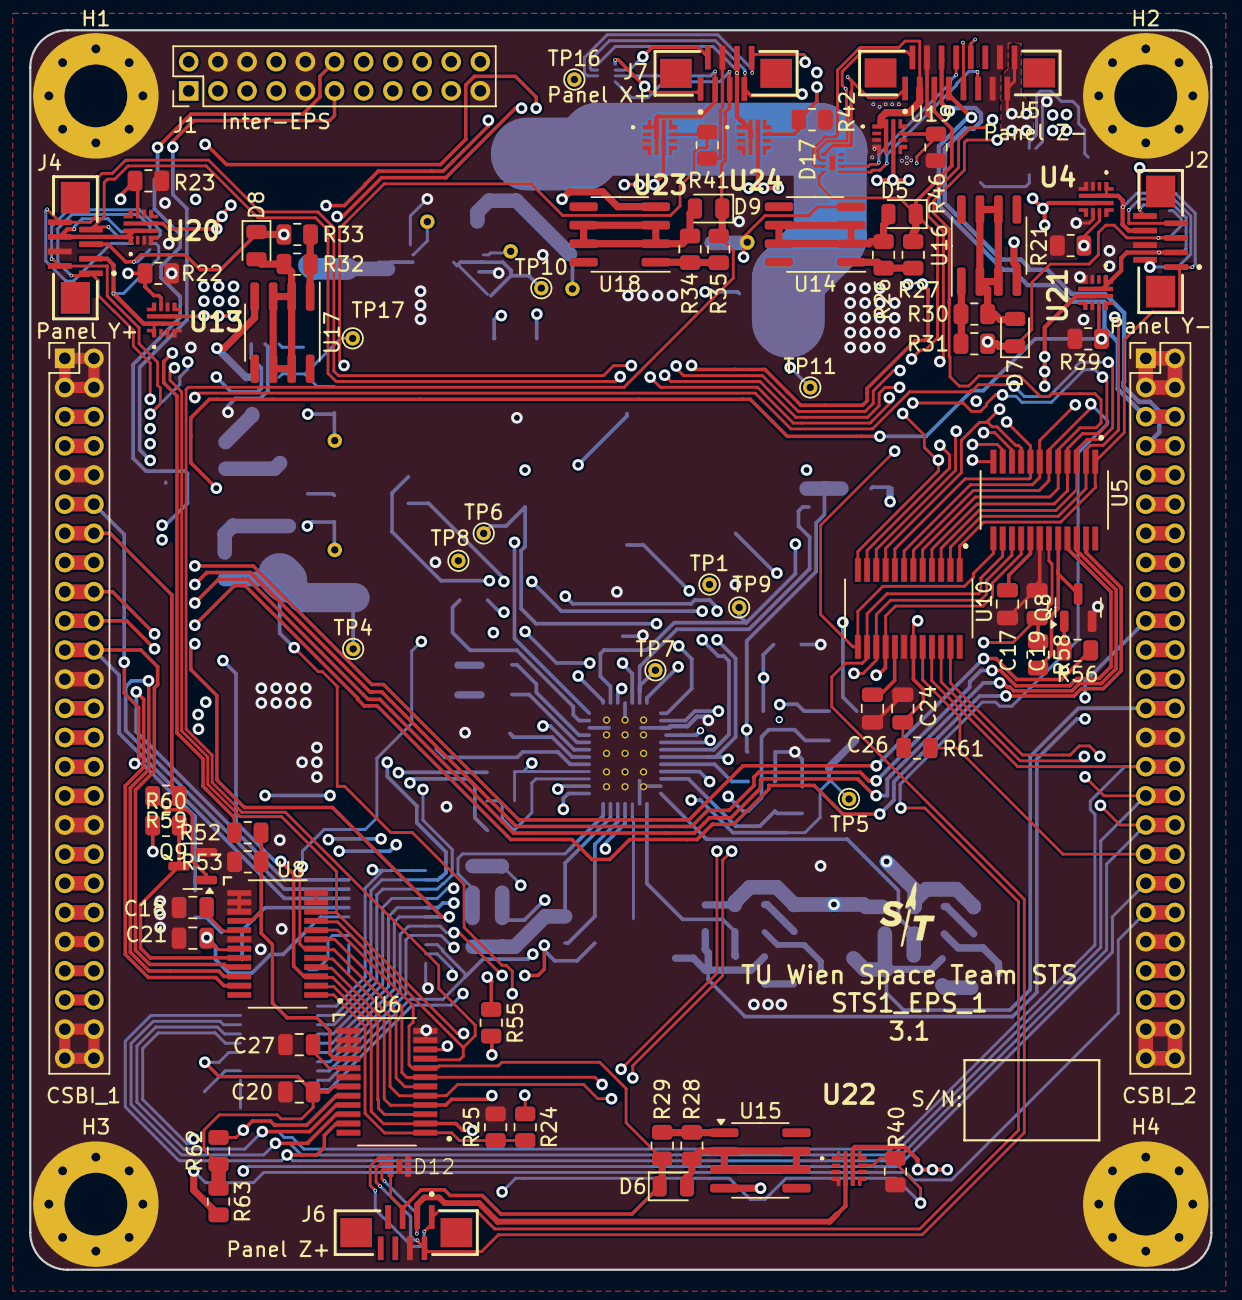
[picture p9: board STS1_EPS_1.kicad_pcb from above]

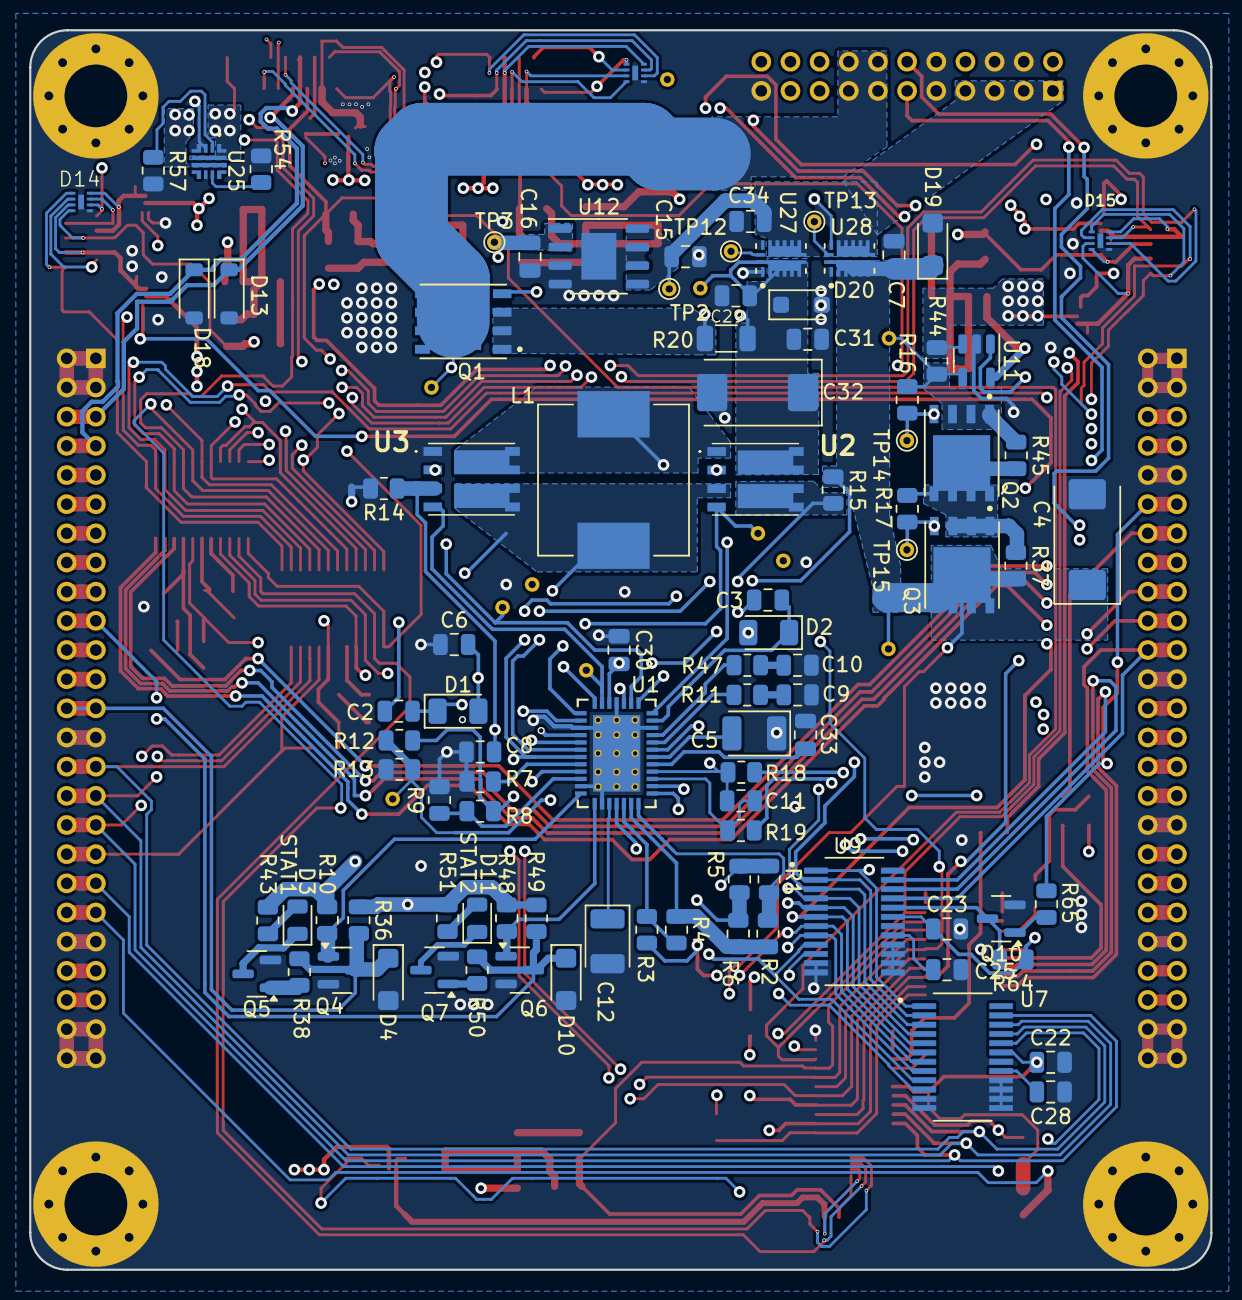
[picture p10: board STS1_EPS_1.kicad_pcb from below]

Board: 6 copper layers, 81.0 x 85.0 mm, 184 parts (97 on the bottom side), 158 nets.
