SpaceTeam/STS1_EPS/pcbs/STS1_EPS_2.kicad_pcb

## KiCad design pcbs/STS1_EPS_2.kicad_pcb (2025-09-17)

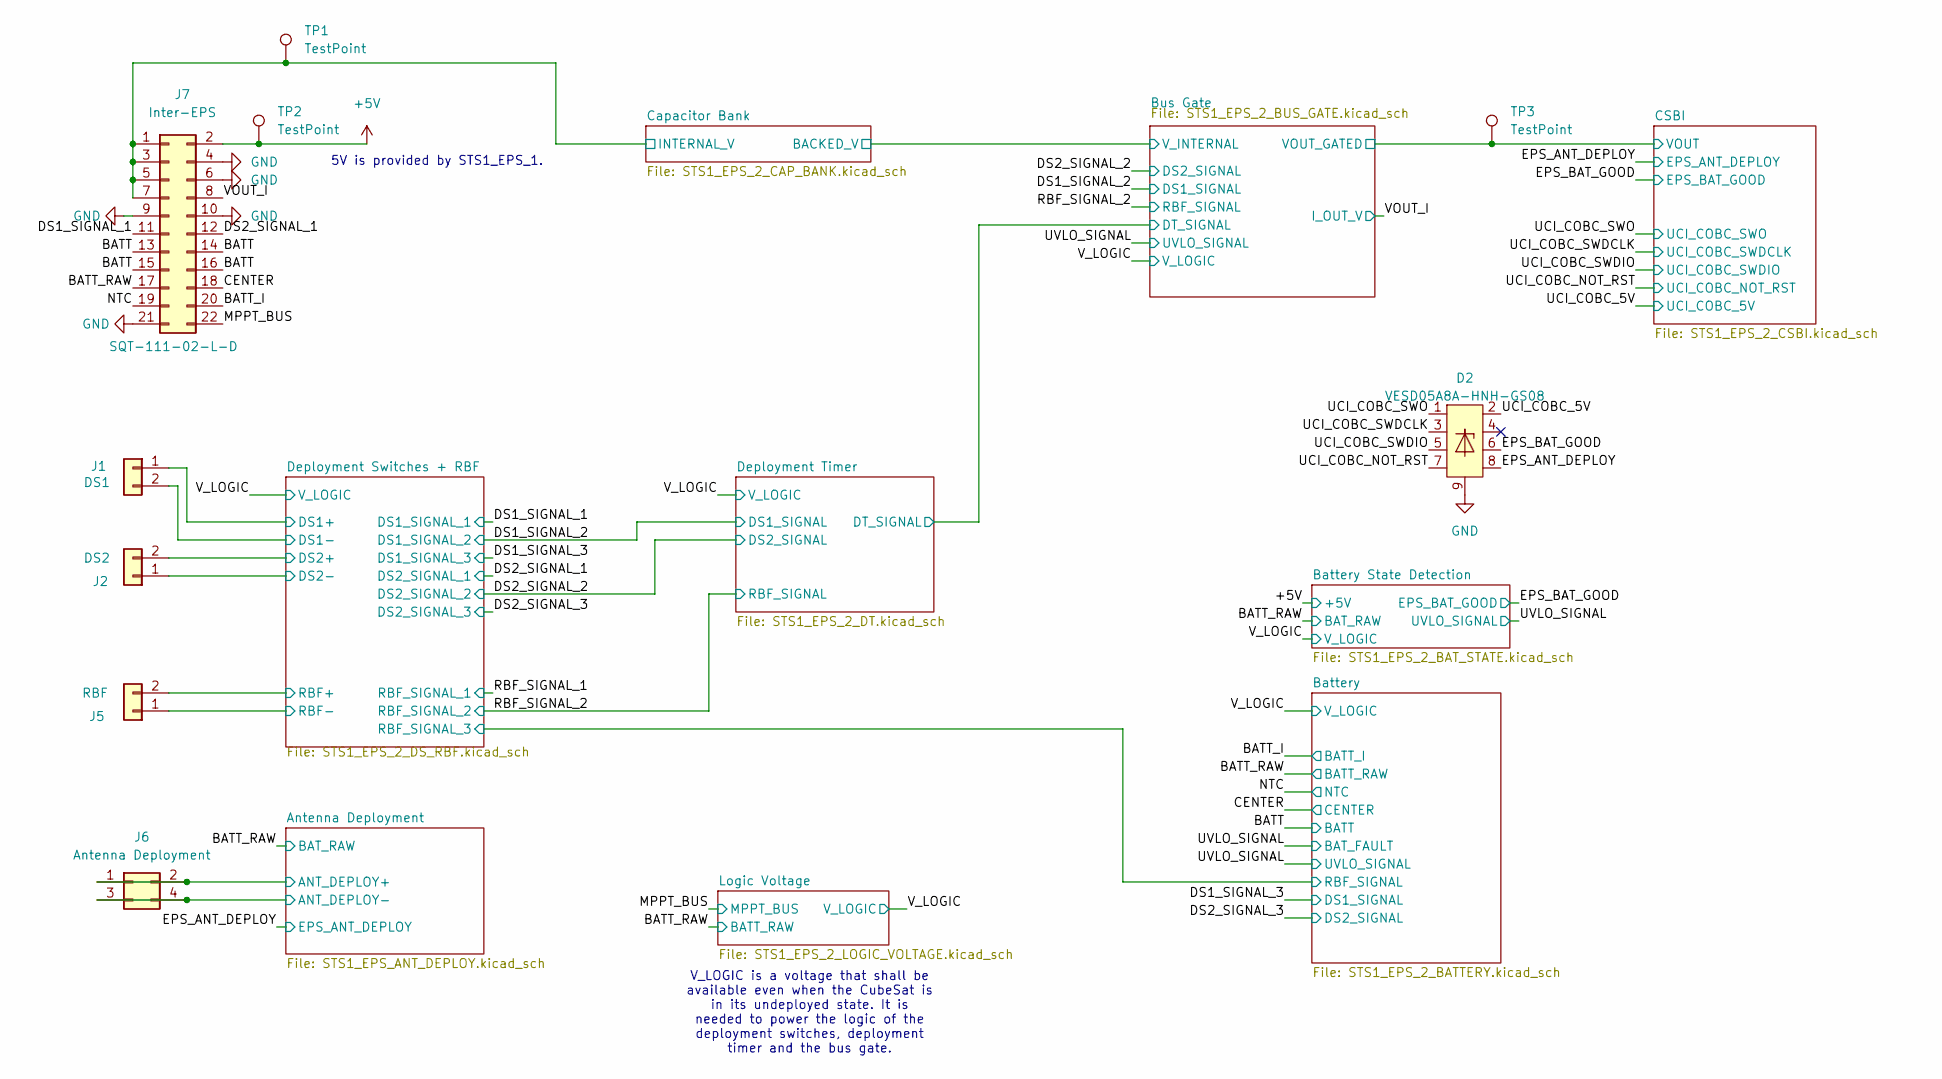
[picture p11: schematic STS1_EPS_2.kicad_sch]

Parts:
D2: VESD05A8A-HNH-GS08; LLP1713-9L
J1: DS1; M808420245; Part Nr. M80-8420245
J2: DS2; M808420245; Part Nr. M80-8420245
J5: RBF; M808420245; Part Nr. M808420245
J6: Antenna Deployment; M80-85104YY; Part Nr. M80-8510442
J7: Inter-EPS; PinHeader_2x11_P2.00mm_Vertical; Part# SQT-111-02-L-D
TP1, TP2, TP3: TestPoint; TestPoint_THTPad_D1.0mm_Drill0.5mm

Connections:
+5V: J7.2, TP2.1; also elsewhere on the board
/Antenna Deployment/ANT_DEPLOY-: J6.3, J6.4; also elsewhere on the board
/BATT: J7.13, J7.14, J7.15, J7.16; also elsewhere on the board
/BATT_I: J7.20; also elsewhere on the board
/BATT_RAW: J6.1, J6.2, J7.17; also elsewhere on the board
/Bus Gate/VOUT_GATED: TP3.1; also elsewhere on the board
/Bus Gate/V_INTERNAL: J7.1, J7.3, J7.5, J7.7, TP1.1; also elsewhere on the board
/CENTER: J7.18; also elsewhere on the board
/DS1_SIGNAL_1: J7.11; also elsewhere on the board
/DS2_SIGNAL_1: J7.12; also elsewhere on the board
/Deployment Switches + RBF/DS1+: J1.1; also elsewhere on the board
/Deployment Switches + RBF/DS2+: J2.2; also elsewhere on the board
/Deployment Switches + RBF/RBF-: J5.1; also elsewhere on the board
/EPS_ANT_DEPLOY: D2.8; also elsewhere on the board
/EPS_BAT_GOOD: D2.6; also elsewhere on the board
/MPPT_BUS: J7.22; also elsewhere on the board
/NTC: J7.19; also elsewhere on the board
/UCI_COBC_5V: D2.2; also elsewhere on the board
/UCI_COBC_NOT_RST: D2.7; also elsewhere on the board
/UCI_COBC_SWDCLK: D2.3; also elsewhere on the board
/UCI_COBC_SWDIO: D2.5; also elsewhere on the board
/UCI_COBC_SWO: D2.1; also elsewhere on the board
/VOUT_I: J7.8; also elsewhere on the board
/V_LOGIC: J5.2; also elsewhere on the board
GND: D2.9, J1.2, J2.1, J7.4, J7.6, J7.9, J7.10, J7.21; also elsewhere on the board

Notes on the sheet:
5V is provided by STS1_EPS_1.
V_LOGIC is a voltage that shall be available even when the CubeSat is in its undeployed state. It is needed to power the logic of the deployment switches, deployment timer and the bus gate.

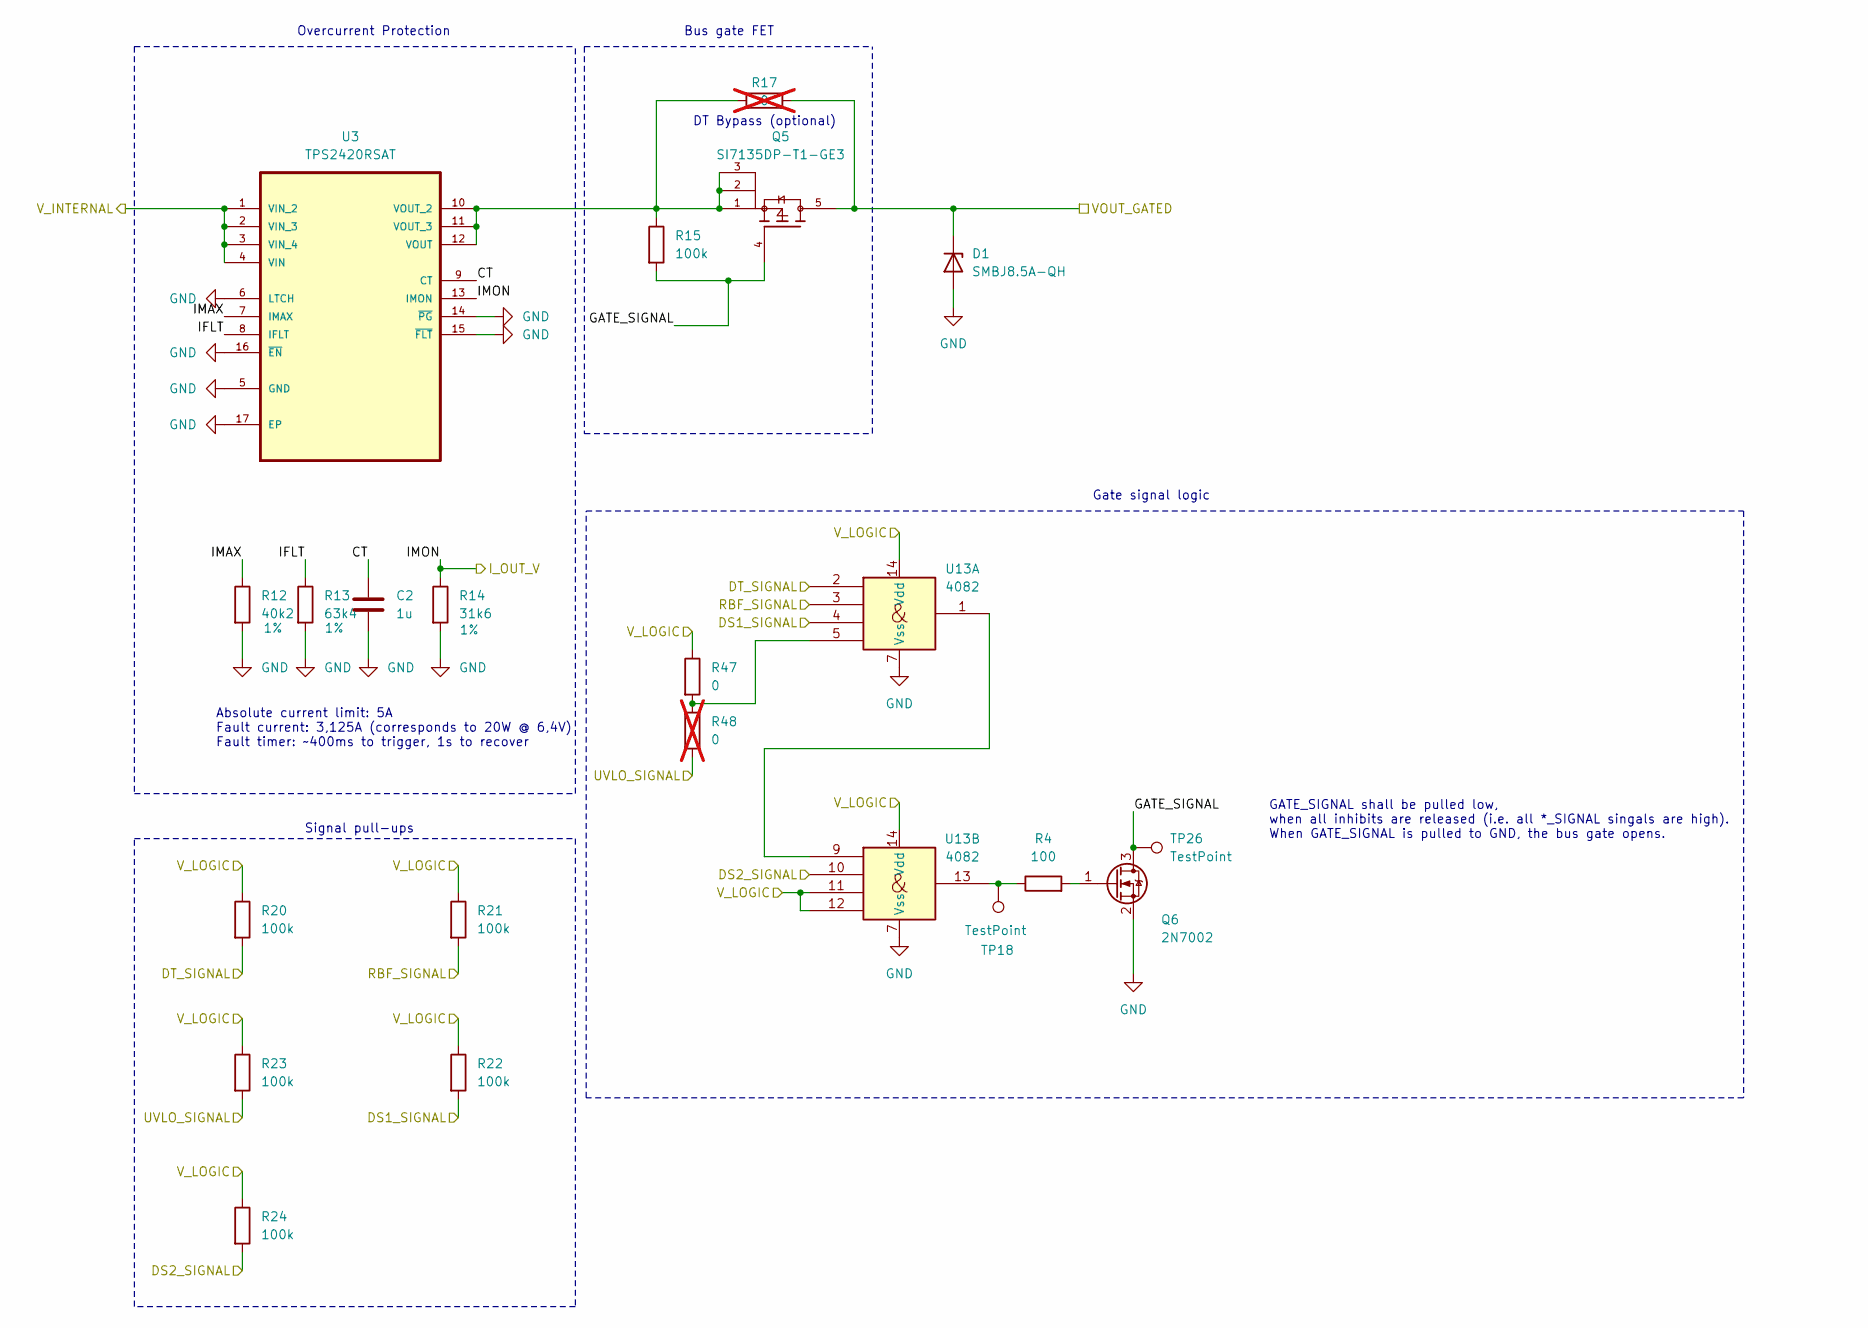
[picture p12: schematic STS1_EPS_2_BUS_GATE.kicad_sch]

Parts:
C2: 1u; C_0805_2012Metric; Part Nr. C0805T105K4RALTU
D1: SMBJ8.5A-QH; D_SMB
Q5: SI7135DP-T1-GE3; POWERPAK_SO8_single; PARTREV A
Q6: 2N7002; SOT-23
R4: 100; R_0805_2012Metric; Part Nr. TNPW0805100RFETA
R12: 40k2; R_0805_2012Metric; Tolerance 1%; Part Nr. CPF0805B40K2E1
R13: 63k4; R_0805_2012Metric; Tolerance 1%; Part Nr. RN73R2ATTD6342B25
R14: 31k6; R_0805_2012Metric; Tolerance 1%; Part Nr. ERA-6ARB3162V
R15, R20, R21, R22, R23, R24: 100k; R_0805_2012Metric; Part Nr. TNPW0805100KFEEA
R17, R48: 0; R_0805_2012Metric; not fitted
R47: 0; R_0805_2012Metric
TP18, TP26: TestPoint; TestPoint_THTPad_D1.0mm_Drill0.5mm
U3: TPS2420RSAT; QFN65P400X400X100-17N; MPN TPS2420RSAT
U13: 4082; SOIC-14_3.9x8.7mm_P1.27mm; Part Nr. HEF4082BT-Q100J

Connections:
/Bus Gate/CT: C2.1, U3.9 (CT)
/Bus Gate/DT_SIGNAL: R20.2, U13.2; also elsewhere on the board
/Bus Gate/GATE_SIGNAL: Q5.4, Q6.3 (D), R15.2, TP26.1
/Bus Gate/IFLT: R13.1, U3.8 (IFLT)
/Bus Gate/IMAX: R12.1, U3.7 (IMAX)
/Bus Gate/VOUT_GATED: D1.1 (K), Q5.5, R17.2; also elsewhere on the board
/Bus Gate/V_INTERNAL: U3.1 (VIN_2), U3.2 (VIN_3), U3.3 (VIN_4), U3.4 (VIN); also elsewhere on the board
/DS1_SIGNAL_2: R22.2, U13.4; also elsewhere on the board
/DS2_SIGNAL_2: R24.2, U13.10; also elsewhere on the board
/RBF_SIGNAL_2: R21.2, U13.3; also elsewhere on the board
/UVLO_SIGNAL: R23.2, R48.2; also elsewhere on the board
/VOUT_I: R14.1, U3.13 (IMON); also elsewhere on the board
/V_LOGIC: R20.1, R21.1, R22.1, R23.1, R24.1, R47.1, U13.11, U13.12, U13.14 (Vdd); also elsewhere on the board
GND: C2.2, D1.2 (A), Q6.2 (S), R12.2, R13.2, R14.2, U3.5 (GND), U3.6 (LTCH), U3.14 (~PG), U3.15 (~FLT), U3.16 (~EN), U3.17 (EP), U13.7 (Vss); also elsewhere on the board
unnamed: Q6.1 (G), R4.2
unnamed: R4.1, TP18.1, U13.13
unnamed: R47.2, R48.1, U13.5
unnamed: Q5.1, Q5.2, Q5.3, R15.1, R17.1, U3.10 (VOUT_2), U3.11 (VOUT_3), U3.12 (VOUT)
unnamed: U13.1, U13.9

Notes on the sheet:
Signal pull-ups
Gate signal logic
Overcurrent Protection
Bus gate FET
Absolute current limit: 5A Fault current: 3,125A (corresponds to 20W @ 6,4V) Fault timer: ~400ms to trigger, 1s to recover
DT Bypass (optional)
GATE_SIGNAL shall be pulled low, when all inhibits are released (i.e. all *_SIGNAL singals are high). When GATE_SIGNAL is pulled to GND, the bus gate opens.

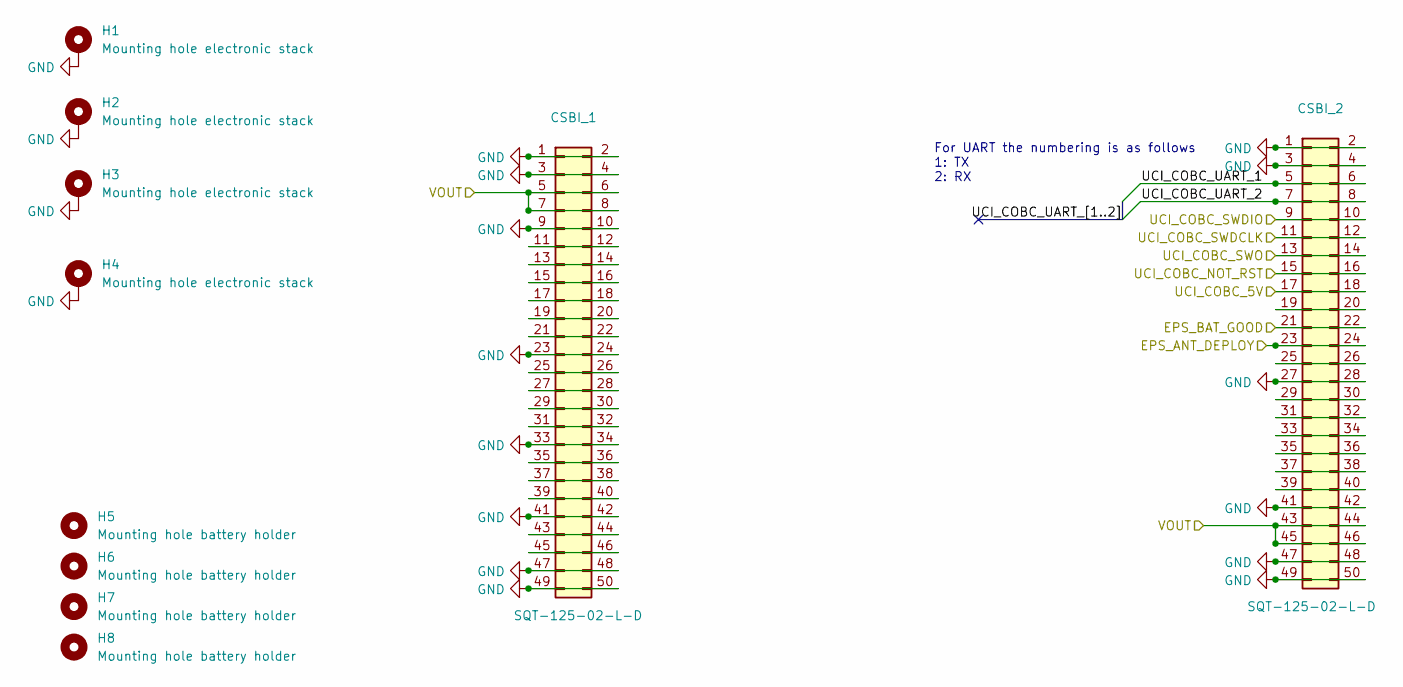
[picture p13: schematic STS1_EPS_2_CSBI.kicad_sch, STS1_connectors]

Parts:
CSBI_1, CSBI_2: PinHeader_2x25_P2.00mm_Vertical; Part # SQT-125-02-L-D
H1, H2, H3, H4: Mounting hole electronic stack; MountingHole_4.3mm_M4_Pad_Via
H5, H6, H7, H8: Mounting hole battery holder; MountingHole_2.2mm_M2

Connections:
/Bus Gate/VOUT_GATED: CSBI_1.5, CSBI_1.6, CSBI_1.7, CSBI_1.8, CSBI_2.43, CSBI_2.44, CSBI_2.45, CSBI_2.46; also elsewhere on the board
/CSBI/UCI_COBC_UART_1: CSBI_2.5, CSBI_2.6
/CSBI/UCI_COBC_UART_2: CSBI_2.7, CSBI_2.8
/EPS_ANT_DEPLOY: CSBI_2.23, CSBI_2.24; also elsewhere on the board
/EPS_BAT_GOOD: CSBI_2.21, CSBI_2.22; also elsewhere on the board
/UCI_COBC_5V: CSBI_2.17, CSBI_2.18; also elsewhere on the board
/UCI_COBC_NOT_RST: CSBI_2.15, CSBI_2.16; also elsewhere on the board
/UCI_COBC_SWDCLK: CSBI_2.11, CSBI_2.12; also elsewhere on the board
/UCI_COBC_SWDIO: CSBI_2.9, CSBI_2.10; also elsewhere on the board
/UCI_COBC_SWO: CSBI_2.13, CSBI_2.14; also elsewhere on the board
GND: CSBI_1.1, CSBI_1.2, CSBI_1.3, CSBI_1.4, CSBI_1.9, CSBI_1.10, CSBI_1.23, CSBI_1.24, CSBI_1.33, CSBI_1.34, CSBI_1.41, CSBI_1.42, CSBI_1.47, CSBI_1.48, CSBI_1.49, CSBI_1.50, CSBI_2.1, CSBI_2.2, CSBI_2.3, CSBI_2.4, CSBI_2.27, CSBI_2.28, CSBI_2.41, CSBI_2.42, CSBI_2.47, CSBI_2.48, CSBI_2.49, CSBI_2.50, H1.1, H2.1, H3.1, H4.1; also elsewhere on the board
unnamed: CSBI_1.11, CSBI_1.12
unnamed: CSBI_1.13, CSBI_1.14
unnamed: CSBI_1.15, CSBI_1.16
unnamed: CSBI_1.17, CSBI_1.18
unnamed: CSBI_1.19, CSBI_1.20
unnamed: CSBI_1.21, CSBI_1.22
unnamed: CSBI_1.25, CSBI_1.26
unnamed: CSBI_1.27, CSBI_1.28
unnamed: CSBI_1.29, CSBI_1.30
unnamed: CSBI_1.31, CSBI_1.32
unnamed: CSBI_1.35, CSBI_1.36
unnamed: CSBI_1.37, CSBI_1.38
unnamed: CSBI_1.39, CSBI_1.40
unnamed: CSBI_1.43, CSBI_1.44
unnamed: CSBI_1.45, CSBI_1.46
unnamed: CSBI_2.19, CSBI_2.20
unnamed: CSBI_2.25, CSBI_2.26
unnamed: CSBI_2.29, CSBI_2.30
unnamed: CSBI_2.31, CSBI_2.32
unnamed: CSBI_2.33, CSBI_2.34
unnamed: CSBI_2.35, CSBI_2.36
unnamed: CSBI_2.37, CSBI_2.38
unnamed: CSBI_2.39, CSBI_2.40

Notes on the sheet:
For UART the numbering is as follows 1: TX 2: RX
