SpaceTeam/STS1_EPS/pcbs/STS1_EPS_2.kicad_pcb

## KiCad design pcbs/STS1_EPS_2.kicad_pcb (continued)

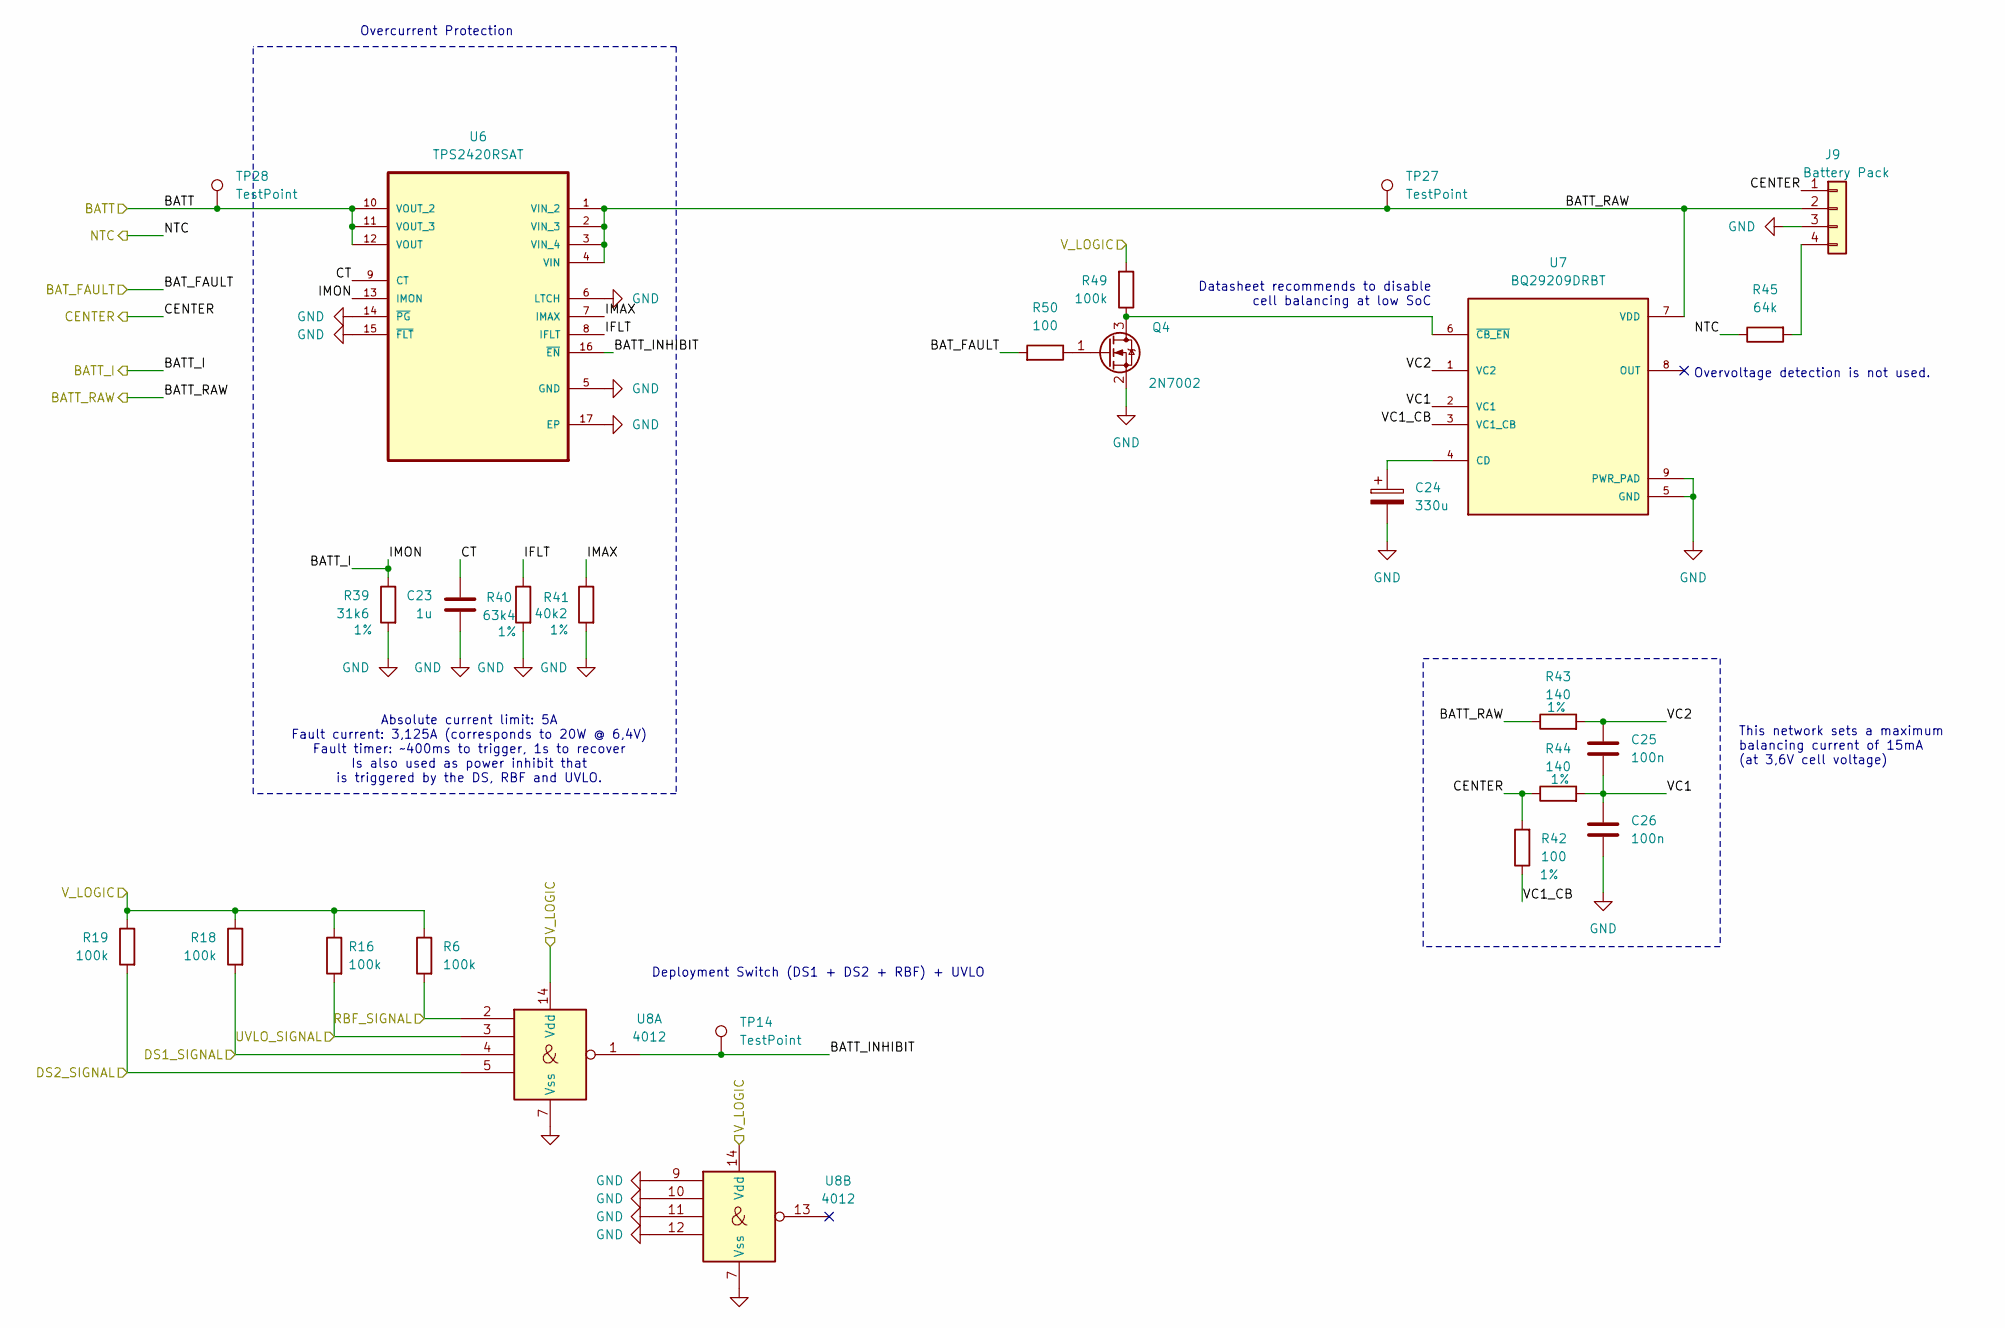
[picture p14: schematic STS1_EPS_2_BATTERY.kicad_sch]

Parts:
C23: 1u; C_0805_2012Metric; Part Nr. C0805T105K4RALTU
C24: 330u; CP_EIA-7343-43_Kemet-X; Part Nr. TPSE687M010R0150V
C25, C26: 100n; C_0805_2012Metric; Part Nr. C0805T104K1RCLTU
J9: Battery Pack; MOLEX_2078430004; Part MOLEX KK Plus 250 Header
Q4: 2N7002; SOT-23; Part Nr. 2N7002
R6, R16, R18, R19: 100k; R_0805_2012Metric; Part Nr. TNPW0805100KFEEA
R39: 31k6; R_0805_2012Metric; Tolerance 1%; Part Nr. ERA-6ARB3162V
R40: 63k4; R_0805_2012Metric; Tolernace 1%; Part Nr. RN73R2ATTD6342B25
R41: 40k2; R_0805_2012Metric; Tolerance 1%; Part Nr. CPF0805B40K2E1
R42: 100; R_0805_2012Metric; Tolerance 1%; Part Nr. TNPW0805100RFETA
R43, R44: 140; R_0805_2012Metric; Tolerance 1%; Part Nr. TNPW0805140RBEEN
R45: 64k; R_0805_2012Metric; Part Nr. PTN0805E6422BST1
R49: 100k; R_0805_2012Metric; Part Nr. PTN0805E6422BST1
R50: 100; R_0805_2012Metric; Part Nr. PTN0805E6422BST1
TP14, TP27, TP28: TestPoint; TestPoint_THTPad_D1.0mm_Drill0.5mm
U6: TPS2420RSAT; QFN65P400X400X100-17N; MPN TPS2420RSAT
U7: BQ29209DRBT; TI_VSON8; PARTREV C
U8: 4012; SOIC-14_3.9x8.7mm_P1.27mm; Part Nr. CD4012B

Connections:
/BATT: TP28.1, U6.10 (VOUT_2), U6.11 (VOUT_3), U6.12 (VOUT); also elsewhere on the board
/BATT_I: R39.1, U6.13 (IMON); also elsewhere on the board
/BATT_RAW: J9.2, R43.1, TP27.1, U6.1 (VIN_2), U6.2 (VIN_3), U6.3 (VIN_4), U6.4 (VIN), U7.7 (VDD); also elsewhere on the board
/Battery/BATT_INHIBIT: TP14.1, U6.16 (~EN), U8.1
/Battery/CT: C23.1, U6.9 (CT)
/Battery/IFLT: R40.1, U6.8 (IFLT)
/Battery/IMAX: R41.1, U6.7 (IMAX)
/Battery/RBF_SIGNAL: R6.2, U8.2; also elsewhere on the board
/Battery/VC1: C25.2, C26.1, R44.2, U7.2 (VC1)
/Battery/VC1_CB: R42.1, U7.3 (VC1_CB)
/Battery/VC2: C25.1, R43.2, U7.1 (VC2)
/CENTER: J9.1, R42.2, R44.1; also elsewhere on the board
/DS1_SIGNAL_3: R18.2, U8.4; also elsewhere on the board
/DS2_SIGNAL_3: R19.2, U8.5; also elsewhere on the board
/NTC: R45.1; also elsewhere on the board
/UVLO_SIGNAL: R16.2, R50.2, U8.3; also elsewhere on the board
/V_LOGIC: R6.1, R16.1, R18.1, R19.1, R49.2, U8.14 (Vdd); also elsewhere on the board
GND: C23.2, C24.2, C26.2, J9.3, Q4.2 (S), R39.2, R40.2, R41.2, U6.5 (GND), U6.6 (LTCH), U6.14 (~PG), U6.15 (~FLT), U6.17 (EP), U7.5 (GND), U7.9 (PWR_PAD), U8.7 (Vss), U8.9, U8.10, U8.11, U8.12; also elsewhere on the board
unnamed: J9.4, R45.2
unnamed: Q4.3 (D), R49.1, U7.6 (~CB_EN)
unnamed: Q4.1 (G), R50.1
unnamed: C24.1, U7.4 (CD)

Notes on the sheet:
Datasheet recommends to disable cell balancing at low SoC
Absolute current limit: 5A Fault current: 3,125A (corresponds to 20W @ 6,4V) Fault timer: ~400ms to trigger, 1s to recover Is also used as power inhibit that is triggered by the DS, RBF and UVLO.
This network sets a maximum balancing current of 15mA (at 3,6V cell voltage)
Overcurrent Protection
Deployment Switch (DS1 + DS2 + RBF) + UVLO
Overvoltage detection is not used.

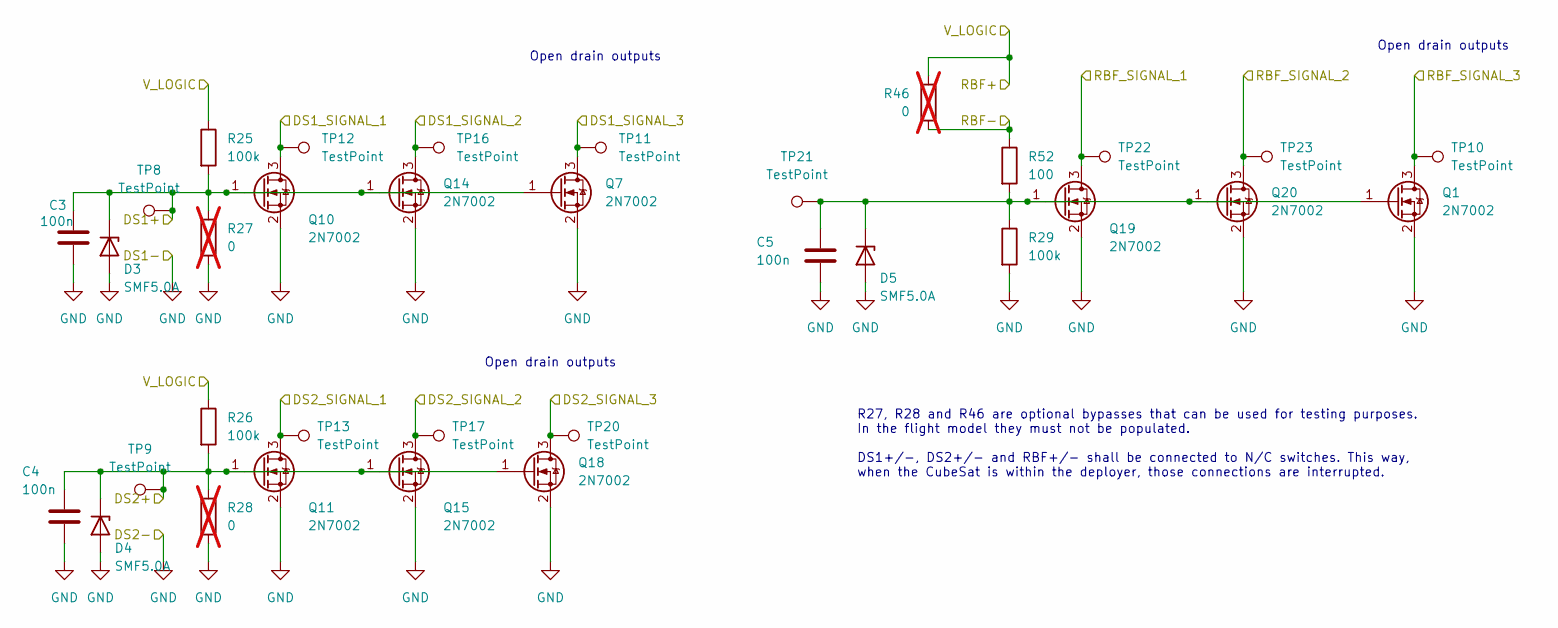
[picture p15: schematic STS1_EPS_2_DS_RBF.kicad_sch]

Parts:
C3, C4, C5: 100n; C_0805_2012Metric; Part Nr. C0805T104K1RCLTU
D3, D4, D5: SMF5.0A; D_SMF
Q1, Q7, Q10, Q11, Q14, Q15, Q18, Q19, Q20: 2N7002; SOT-23
R25, R26, R29: 100k; R_0805_2012Metric; Part Nr. TNPW0805100KFEEA
R27, R28, R46: 0; R_0805_2012Metric; not fitted
R52: 100; R_0805_2012Metric; Part Nr. TNPW0805100KFEEA
TP8, TP9, TP10, TP11, TP12, TP13, TP16, TP17, TP20, TP21, TP22, TP23: TestPoint; TestPoint_THTPad_D1.0mm_Drill0.5mm

Connections:
/Battery/RBF_SIGNAL: Q1.3 (D), TP10.1; also elsewhere on the board
/DS1_SIGNAL_1: Q10.3 (D), TP12.1; also elsewhere on the board
/DS1_SIGNAL_2: Q14.3 (D), TP16.1; also elsewhere on the board
/DS1_SIGNAL_3: Q7.3 (D), TP11.1; also elsewhere on the board
/DS2_SIGNAL_1: Q11.3 (D), TP13.1; also elsewhere on the board
/DS2_SIGNAL_2: Q15.3 (D), TP17.1; also elsewhere on the board
/DS2_SIGNAL_3: Q18.3 (D), TP20.1; also elsewhere on the board
/Deployment Switches + RBF/DS1+: C3.1, D3.1 (K), Q7.1 (G), Q10.1 (G), Q14.1 (G), R25.2, R27.1, TP8.1; also elsewhere on the board
/Deployment Switches + RBF/DS2+: C4.1, D4.1 (K), Q11.1 (G), Q15.1 (G), Q18.1 (G), R26.2, R28.1, TP9.1; also elsewhere on the board
/Deployment Switches + RBF/RBF-: R46.1, R52.1; also elsewhere on the board
/RBF_SIGNAL_1: Q19.3 (D), TP22.1
/RBF_SIGNAL_2: Q20.3 (D), TP23.1; also elsewhere on the board
/V_LOGIC: R25.1, R26.1, R46.2; also elsewhere on the board
GND: C3.2, C4.2, C5.2, D3.2 (A), D4.2 (A), D5.2 (A), Q1.2 (S), Q7.2 (S), Q10.2 (S), Q11.2 (S), Q14.2 (S), Q15.2 (S), Q18.2 (S), Q19.2 (S), Q20.2 (S), R27.2, R28.2, R29.2; also elsewhere on the board
unnamed: C5.1, D5.1 (K), Q1.1 (G), Q19.1 (G), Q20.1 (G), R29.1, R52.2, TP21.1

Notes on the sheet:
Open drain outputs
R27, R28 and R46 are optional bypasses that can be used for testing purposes. In the flight model they must not be populated. DS1+/-, DS2+/- and RBF+/- shall be connected to N/C switches. This way, when the CubeSat is within the deployer, those connections are interrupted.

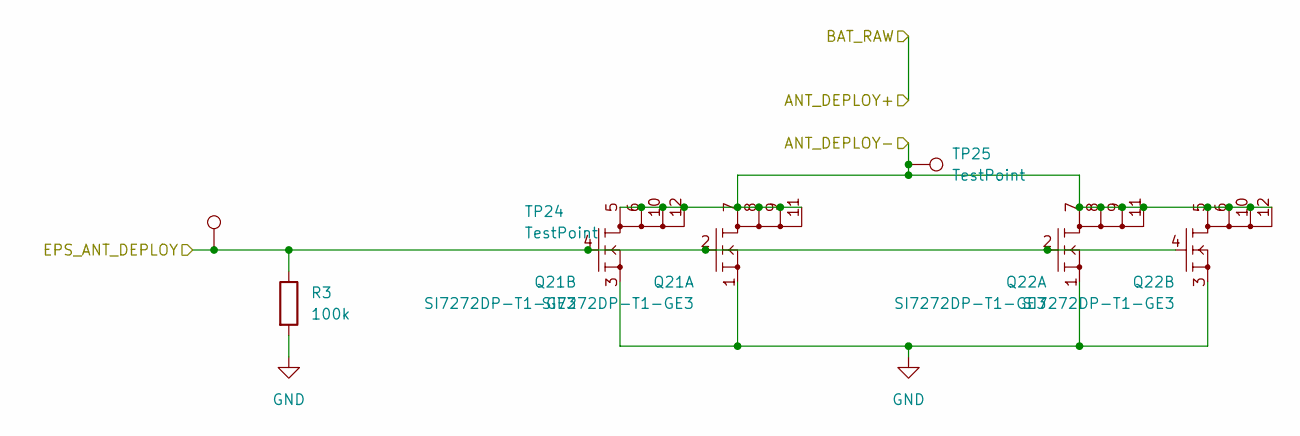
[picture p16: schematic STS1_EPS_ANT_DEPLOY.kicad_sch]

Parts:
Q21, Q22: SI7272DP-T1-GE3; POWERPAK_SO8
R3: 100k; R_0805_2012Metric; Part Nr. TNPW0805100KFEEA
TP24, TP25: TestPoint; TestPoint_THTPad_D1.0mm_Drill0.5mm

Connections:
/Antenna Deployment/ANT_DEPLOY-: Q21.5 (D2_1), Q21.6 (D2_2), Q21.7 (D1_1), Q21.8 (D1_2), Q21.9 (D1_3), Q21.10 (D2_3), Q21.11 (D1_4), Q21.12 (D2_4), Q22.5 (D2_1), Q22.6 (D2_2), Q22.7 (D1_1), Q22.8 (D1_2), Q22.9 (D1_3), Q22.10 (D2_3), Q22.11 (D1_4), Q22.12 (D2_4), TP25.1; also elsewhere on the board
/EPS_ANT_DEPLOY: Q21.2 (G1), Q21.4 (G2), Q22.2 (G1), Q22.4 (G2), R3.1, TP24.1; also elsewhere on the board
GND: Q21.1 (S1), Q21.3 (S2), Q22.1 (S1), Q22.3 (S2), R3.2; also elsewhere on the board

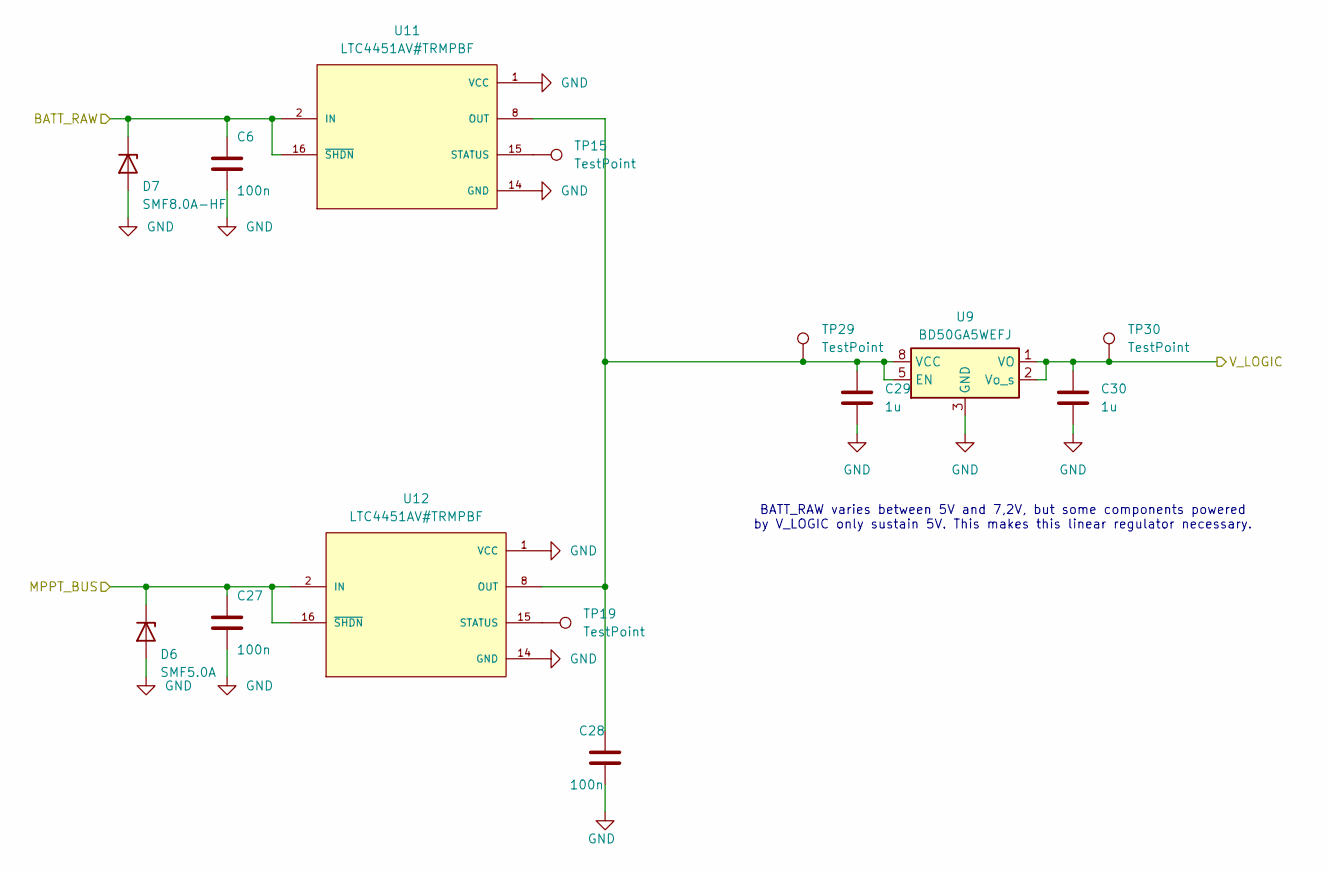
[picture p17: schematic STS1_EPS_2_LOGIC_VOLTAGE.kicad_sch]

Parts:
C6, C27, C28: 100n; C_0805_2012Metric; Part Nr. C0805T104K1RCLTU
C29, C30: 1u; C_0805_2012Metric; Part Nr. C0805T105K4RALTU
D6: SMF5.0A; D_SMF
D7: SMF8.0A-HF; D_SOD-123F
TP15, TP19, TP29, TP30: TestPoint; TestPoint_THTPad_D1.0mm_Drill0.5mm
U9: BD50GA5WEFJ; HTSOP-8-1EP_3.9x4.9mm_P1.27mm_EP2.4x3.2mm
U11, U12: LTC4451AV#TRMPBF; AD_LQFN-16; PARTREV 0

Connections:
/BATT_RAW: C6.1, D7.1 (K), U11.2 (IN), U11.16 (~SHDN); also elsewhere on the board
/MPPT_BUS: C27.1, D6.1 (K), U12.2 (IN), U12.16 (~SHDN); also elsewhere on the board
/V_LOGIC: C30.1, TP30.1, U9.1 (VO), U9.2 (Vo_s); also elsewhere on the board
GND: C6.2, C27.2, C28.2, C29.2, C30.2, D6.2 (A), D7.2 (A), U9.3 (GND), U9.4 (GND), U9.6 (GND), U9.7 (GND), U9.9 (GND), U11.1 (VCC), U11.14 (GND), U12.1 (VCC), U12.14 (GND); also elsewhere on the board
unnamed: C28.1, C29.1, TP29.1, U9.5 (EN), U9.8 (VCC), U11.8 (OUT), U12.8 (OUT)
unnamed: TP15.1, U11.15 (STATUS)
unnamed: TP19.1, U12.15 (STATUS)

Notes on the sheet:
BATT_RAW varies between 5V and 7,2V, but some components powered by V_LOGIC only sustain 5V. This makes this linear regulator necessary.

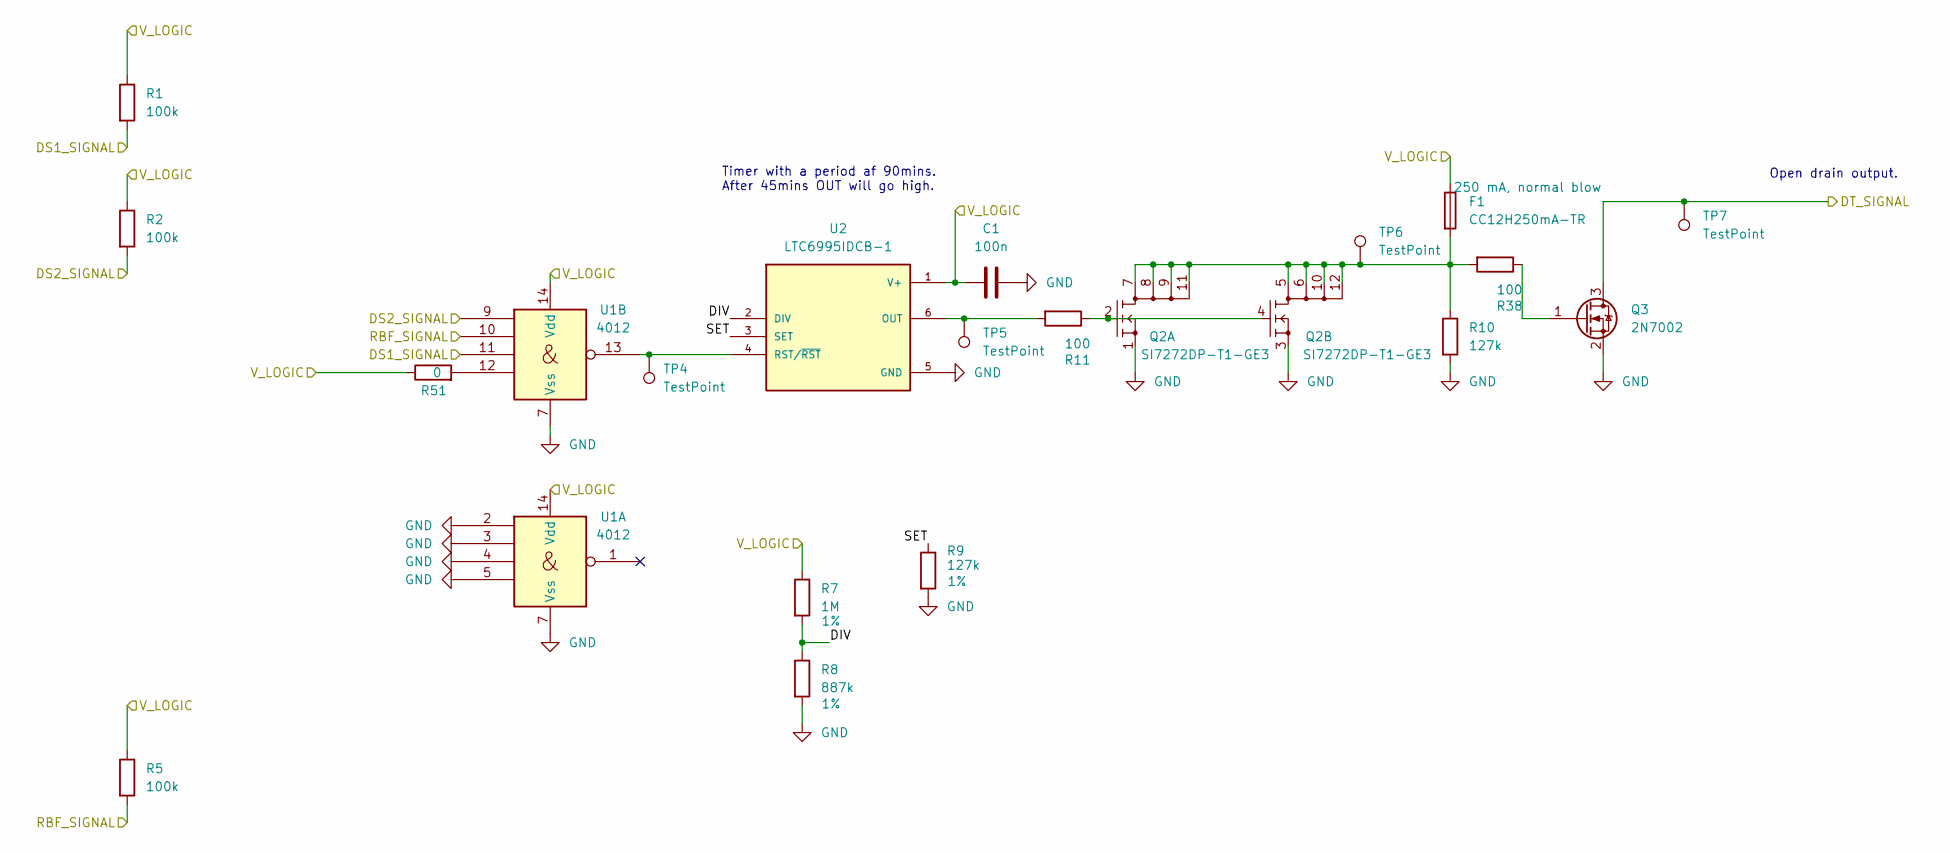
[picture p18: schematic STS1_EPS_2_DT.kicad_sch]

Parts:
C1: 100n; C_0805_2012Metric; Part Nr. C0805T104K1RCLTU
F1: CC12H250mA-TR; R_1206_3216Metric
Q2: SI7272DP-T1-GE3; POWERPAK_SO8
Q3: 2N7002; SOT-23
R1, R2, R5: 100k; R_0805_2012Metric; Part Nr. TNPW0805100KFEEA
R7: 1M; R_0805_2012Metric; Tolerance 1%; Part Nr. CRT0805-BY-1004ELF
R8: 887k; R_0805_2012Metric; Tolerance 1%; Part Nr. ERA-6AEB8873V
R9: 127k; R_0805_2012Metric; Tolerance 1%; Part Nr. RN73H2ATTD1273B25
R10: 127k; R_0805_2012Metric; Part Nr. RN73H2ATTD1273B25
R11, R38: 100; R_0805_2012Metric; Part Nr. TNPW0805100RFETA
R51: 0; R_0805_2012Metric; Tolerance 1%; Part Nr. CRT0805-BY-1004ELF
TP4, TP5, TP6, TP7: TestPoint; TestPoint_THTPad_D1.0mm_Drill0.5mm
U1: 4012; SOIC-14_3.9x8.7mm_P1.27mm; Part Nr. CD4012B
U2: LTC6995IDCB-1; DFN-6-1EP_3x2mm_P0.5mm_EP1.65x1.35mm; PARTREV Rev. B

Connections:
/Bus Gate/DT_SIGNAL: Q3.3 (D), TP7.1; also elsewhere on the board
/DS1_SIGNAL_2: R1.2, U1.11; also elsewhere on the board
/DS2_SIGNAL_2: R2.2, U1.9; also elsewhere on the board
/Deployment Timer/DIV: R7.2, R8.1, U2.2 (DIV)
/Deployment Timer/SET: R9.1, U2.3 (SET)
/RBF_SIGNAL_2: R5.2, U1.10; also elsewhere on the board
/V_LOGIC: C1.1, F1.1, R1.1, R2.1, R5.1, R7.1, R51.1, U1.14 (Vdd), U2.1 (V+); also elsewhere on the board
GND: C1.2, Q2.1 (S1), Q2.3 (S2), Q3.2 (S), R8.2, R9.2, R10.2, U1.2, U1.3, U1.4, U1.5, U1.7 (Vss), U2.5 (GND), U2.7 (GND); also elsewhere on the board
unnamed: F1.2, Q2.5 (D2_1), Q2.6 (D2_2), Q2.7 (D1_1), Q2.8 (D1_2), Q2.9 (D1_3), Q2.10 (D2_3), Q2.11 (D1_4), Q2.12 (D2_4), R10.1, R38.2, TP6.1
unnamed: Q2.2 (G1), Q2.4 (G2), R11.1
unnamed: Q3.1 (G), R38.1
unnamed: R51.2, U1.12
unnamed: R11.2, TP5.1, U2.6 (OUT)
unnamed: TP4.1, U1.13, U2.4 (RST/~RST)

Notes on the sheet:
Timer with a period af 90mins. After 45mins OUT will go high.
Open drain output.

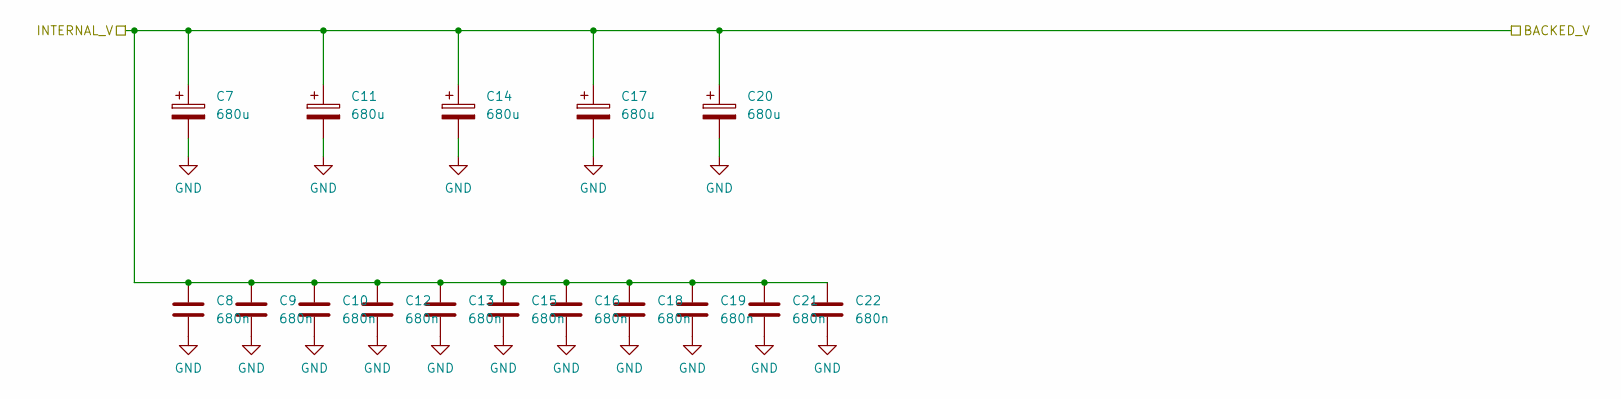
[picture p19: schematic STS1_EPS_2_CAP_BANK.kicad_sch]

Parts:
C7, C11, C14, C17, C20: 680u; CP_EIA-7343-43_Kemet-X; Part Nr. TPSE687M010R0150V
C8, C9, C10, C12, C13, C15, C16, C18, C19, C21, C22: 680n; C_0805_2012Metric; Part Nr. C0805T684K5RCLTM

Connections:
/Bus Gate/V_INTERNAL: C7.1, C8.1, C9.1, C10.1, C11.1, C12.1, C13.1, C14.1, C15.1, C16.1, C17.1, C18.1, C19.1, C20.1, C21.1, C22.1; also elsewhere on the board
GND: C7.2, C8.2, C9.2, C10.2, C11.2, C12.2, C13.2, C14.2, C15.2, C16.2, C17.2, C18.2, C19.2, C20.2, C21.2, C22.2; also elsewhere on the board

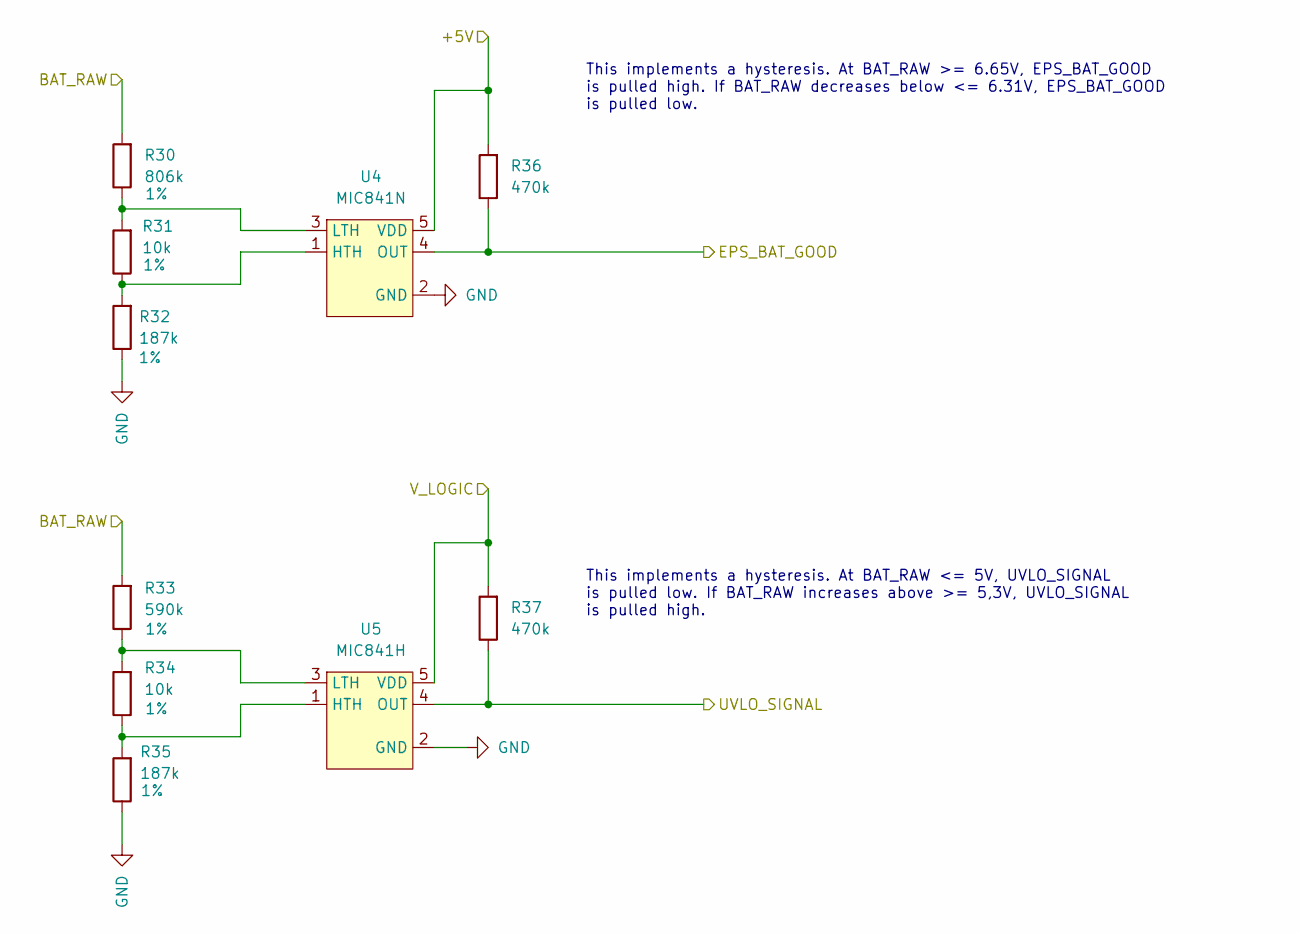
[picture p20: schematic STS1_EPS_2_BAT_STATE.kicad_sch]

Parts:
R30: 806k; R_0805_2012Metric; Tolerance 1%; Part Nr. ERA-6AEB8063V
R31, R34: 10k; R_0805_2012Metric; Tolerance 1%; Part Nr. TNPW080510K0FEEA
R32, R35: 187k; R_0805_2012Metric; Tolerance 1%; Part Nr. RN73C2A187KBTDF
R33: 590k; R_0805_2012Metric; Tolerance 1%; Part Nr. TNPW0805590KBEEA
R36, R37: 470k; R_0805_2012Metric; Part Nr. ERA-6AED474V
U4: MIC841N; SOT-353_SC-70-5
U5: MIC841H; SOT-353_SC-70-5

Connections:
+5V: R36.2, U4.5 (VDD); also elsewhere on the board
/BATT_RAW: R30.2, R33.2; also elsewhere on the board
/EPS_BAT_GOOD: R36.1, U4.4 (OUT); also elsewhere on the board
/UVLO_SIGNAL: R37.1, U5.4 (OUT); also elsewhere on the board
/V_LOGIC: R37.2, U5.5 (VDD); also elsewhere on the board
GND: R32.1, R35.1, U4.2 (GND), U5.2 (GND); also elsewhere on the board
unnamed: R31.1, R32.2, U4.1 (HTH)
unnamed: R30.1, R31.2, U4.3 (LTH)
unnamed: R34.1, R35.2, U5.1 (HTH)
unnamed: R33.1, R34.2, U5.3 (LTH)

Notes on the sheet:
This implements a hysteresis. At BAT_RAW >= 6.65V, EPS_BAT_GOOD is pulled high. If BAT_RAW decreases below <= 6.31V, EPS_BAT_GOOD is pulled low.
This implements a hysteresis. At BAT_RAW <= 5V, UVLO_SIGNAL is pulled low. If BAT_RAW increases above >= 5,3V, UVLO_SIGNAL is pulled high.

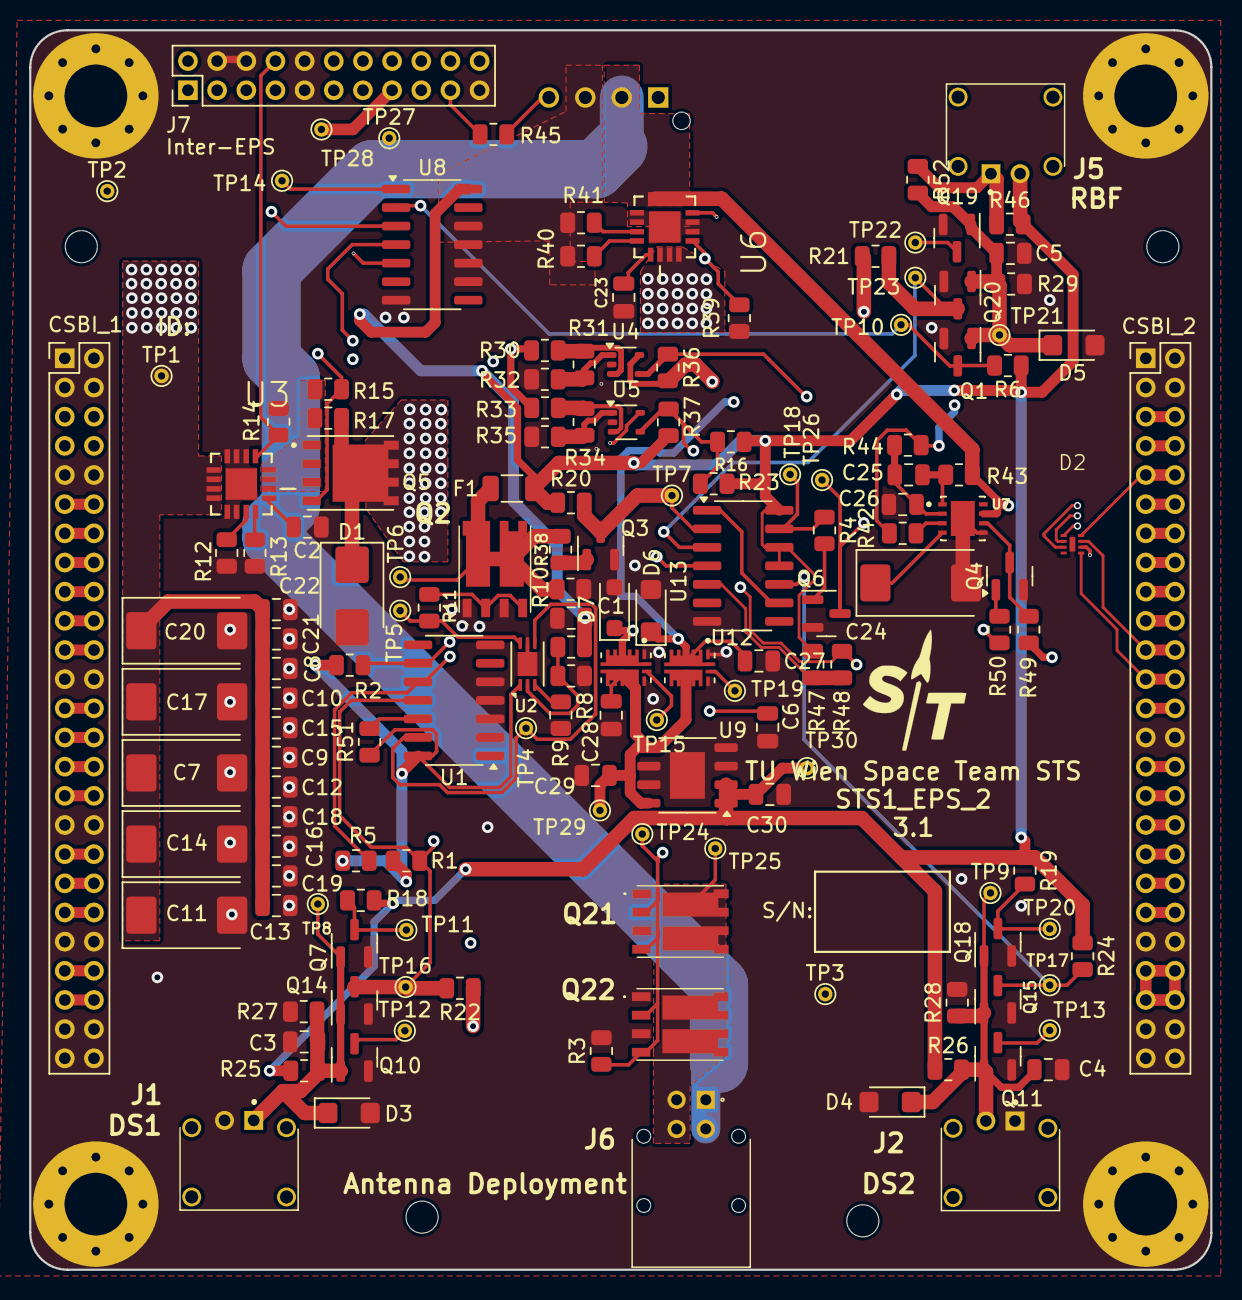
[picture p21: board STS1_EPS_2.kicad_pcb from above]

Board: 6 copper layers, 81.0 x 85.0 mm, 164 parts (1 on the bottom side), 95 nets.
