SpaceTeam/STS1_EPS/pcbs/STS1_EPS_3.kicad_pcb

## KiCad design pcbs/STS1_EPS_3.kicad_pcb (2023-06-13)

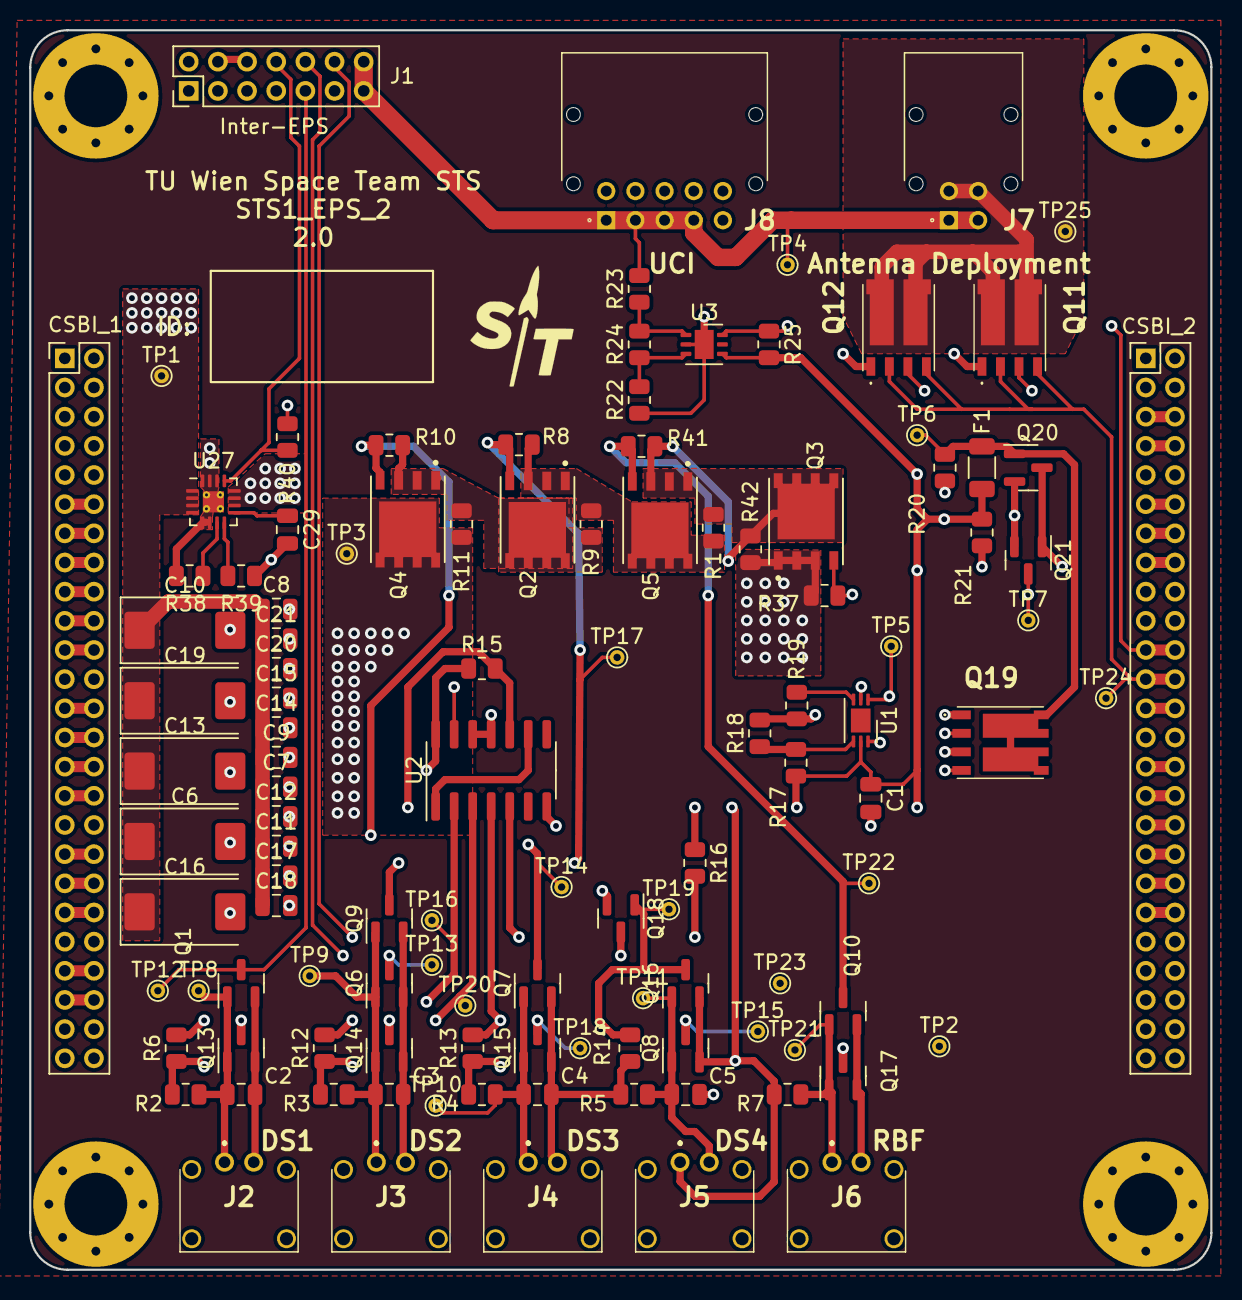
[picture p22: board STS1_EPS_3.kicad_pcb from above]

Board: 4 copper layers, 81.0 x 85.0 mm, 118 parts (0 on the bottom side), 60 nets.

Parts:
C1, C2, C3, C4, C5: 100n; C_0805_2012Metric
C6, C10, C13, C16, C19: C_Polarized; CP_EIA-7343-43_Kemet-X
C7, C8, C9, C11, C12, C14, C15, C17, C18, C20, C21: C; C_0805_2012Metric
C29: 1u; C_0805_2012Metric
CSBI_1, CSBI_2: PinHeader_2x25_P2.00mm_Vertical
F1: Fuse; R_1206_3216Metric
H1, H2, H3, H4: MountingHole_Pad; MountingHole_4.3mm_M4_Pad_Via
J1: Inter-EPS; PinHeader_2x07_P2.00mm_Vertical
J2: DS1; M808420245
J3: DS2; M808420245
J4: DS3; M808420245
J5: DS4; M808420245
J6: RBF; M808420245
J7: Antenna Deployment; M80-85104YY
J8: UCI; M80-85110YY
Q1, Q6, Q7, Q9, Q10, Q13, Q14, Q15, Q17, Q18, Q20, Q21: 2N7002; SOT-23
Q2, Q3, Q4, Q5: SI7135DP-T1-GE3; POWERPAK_SO8_single
Q8, Q16: BSS83P; SOT-23
Q11, Q12, Q19: SI7272DP-T1-GE3; POWERPAK_SO8
R1, R9, R11, R42: 0; R_0805_2012Metric
R2, R3, R4, R5, R6, R7, R8, R10, R12, R13, R14, R15, R16, R37, R41: 100k; R_0805_2012Metric
R17: 1M; R_0805_2012Metric
R18: 887k; R_0805_2012Metric
R19, R20, R21: 127k; R_0805_2012Metric
R22: 187k; R_0805_2012Metric
R23: 787k; R_0805_2012Metric
R24: 10k; R_0805_2012Metric
R25: 470k; R_0805_2012Metric
R38: 40k2; R_0805_2012Metric
R39: 64k; R_0805_2012Metric
R40: 31k5; R_0805_2012Metric
TP1, TP2, TP3, TP4, TP5, TP6, TP7, TP8, TP9, TP10, TP11, TP12, TP13, TP14, TP15, TP16, TP17, TP18, TP19, TP20, TP21, TP22, TP23, TP24, TP25: TestPoint; TestPoint_THTPad_D1.0mm_Drill0.5mm
U1: LTC6995IDCB-1; DFN-6-1EP_3x2mm_P0.5mm_EP1.65x1.35mm
U2: 4072; SOIC-14_3.9x8.7mm_P1.27mm
U3: MIC841; TDFN-6-1EP_2.5x2.5mm_P0.65mm_EP1.3x2mm
U27: TPS2420RSAT; VQFN-16-1EP_3x3mm_P0.5mm_EP1.45x1.45mm_ThermalVias

Connections:
/+5V: C1.1, F1.1, J1.2, J5.1, Q8.2 (S), Q16.2 (S), R2.1, R3.1, R4.1, R6.1, R7.1, R12.1, R13.1, R15.1, R16.1, R17.1, R21.1, R25.2, TP2.1, U1.5 (V+), U2.14 (VDD), U3.4 (VDD)
/Antenna Deployment/ANT_DEPLOY-: J7.3, J7.4, Q11.5 (D2_1), Q11.6 (D2_2), Q11.7 (D1_1), Q11.8 (D1_2), Q11.9 (D1_3), Q11.10 (D2_3), Q11.11 (D1_4), Q11.12 (D2_4), Q12.5 (D2_1), Q12.6 (D2_2), Q12.7 (D1_1), Q12.8 (D1_2), Q12.9 (D1_3), Q12.10 (D2_3), Q12.11 (D1_4), Q12.12 (D2_4), TP25.1
/BATT_RAW: J1.13, J1.14, J7.1, J7.2, J8.1, J8.2, J8.3, J8.4, R23.2, TP4.1
/Bus Gate/CT: C29.1, U27.9 (CT)
/Bus Gate/DT_SIGNAL: Q3.4, Q21.3 (D), R37.2, TP7.1
/Bus Gate/IFLT: R39.1, U27.8 (IFLT)
/Bus Gate/IMAX: R38.1, U27.7 (IMAX)
/Bus Gate/VOUT_GATED: CSBI_1.5, CSBI_1.6, CSBI_1.7, CSBI_1.8, CSBI_2.43, CSBI_2.44, CSBI_2.45, CSBI_2.46, Q4.5, R11.2, TP3.1
/CSBI/COBC_SPI_1: CSBI_2.29, CSBI_2.30
/CSBI/COBC_SPI_2: CSBI_2.31, CSBI_2.32
/CSBI/COBC_SPI_3: CSBI_2.33, CSBI_2.34
/CSBI/COBC_SPI_4: CSBI_2.35, CSBI_2.36
/CSBI/COBC_SPI_5: CSBI_2.37, CSBI_2.38
/CSBI/COBC_SPI_6: CSBI_2.39, CSBI_2.40
/CSBI/EDU_SPI_1: CSBI_1.21, CSBI_1.22
/CSBI/EDU_SPI_2: CSBI_1.19, CSBI_1.20
/CSBI/EDU_SPI_3: CSBI_1.17, CSBI_1.18
/CSBI/EDU_SPI_4: CSBI_1.15, CSBI_1.16
/CSBI/EDU_SPI_5: CSBI_1.13, CSBI_1.14
/CSBI/EDU_SPI_6: CSBI_1.11, CSBI_1.12
/CSBI/UART_COBC_EDU_1: CSBI_1.45, CSBI_1.46
/CSBI/UART_COBC_EDU_2: CSBI_1.43, CSBI_1.44
/CSBI/UCI_COBC_UART_1: CSBI_2.5, CSBI_2.6
/CSBI/UCI_COBC_UART_2: CSBI_2.7, CSBI_2.8
/DS1_SIGNAL_1: J1.9, Q1.3 (D), TP12.1
/DS1_SIGNAL_2: Q13.3 (D), R6.2, TP16.1, U2.2
/DS2_SIGNAL_1: J1.10, Q6.3 (D), TP13.1
/DS2_SIGNAL_2: Q2.4, Q9.3 (D), R8.2, TP17.1
/DS2_SIGNAL_3: Q14.3 (D), R12.2, TP20.1, U2.3
/DS3_SIGNAL_1: Q4.4, Q7.3 (D), R10.2, TP14.1
/DS3_SIGNAL_2: Q15.3 (D), R13.2, TP18.1, U2.4
/DS4_SIGNAL_1: J1.12, Q8.3 (D), TP15.1
/DS4_SIGNAL_2: Q16.3 (D), Q18.1 (G), R14.1, TP19.1
/Deployment Switches + RBF/DS1+: C2.1, J2.1, Q1.1 (G), Q13.1 (G), R2.2, TP8.1
/Deployment Switches + RBF/DS2+: C3.1, J3.1, Q6.1 (G), Q9.1 (G), Q14.1 (G), R3.2, TP9.1
/Deployment Switches + RBF/DS3+: C4.1, J4.1, Q7.1 (G), Q15.1 (G), R4.2, TP10.1
/Deployment Switches + RBF/DS4-: C5.1, J5.2, Q8.1 (G), Q16.1 (G), R5.1, TP11.1
/Deployment Switches + RBF/RBF+: J6.1, Q10.1 (G), Q17.1 (G), R7.2, TP21.1
/Deployment Timer/DIV: R17.2, R18.1, U1.4 (DIV)
/Deployment Timer/SET: R19.1, U1.3 (SET)
/Deployment Timer/~DS4_SIGNAL: Q18.3 (D), R16.2, U2.5
/EPS_ANT_DEPLOY: CSBI_2.23, CSBI_2.24, Q11.2 (G1), Q11.4 (G2), Q12.2 (G1), Q12.4 (G2), TP24.1
/EPS_BAT_FAULT: CSBI_2.13, CSBI_2.14
/EPS_BAT_GOOD: CSBI_2.21, CSBI_2.22, R25.1, U3.6 (OUT)
/INTERNAL_V: C6.1, C7.1, C8.1, C9.1, C10.1, C11.1, C12.1, C13.1, C14.1, C15.1, C16.1, C17.1, C18.1, C19.1, C20.1, C21.1, J1.1, J1.3, J1.5, J1.7, TP1.1, U27.1 (VIN_2), U27.2 (VIN_3), U27.3 (VIN_4), U27.4 (VIN)
/RBF_SIGNAL_1: Q5.4, Q10.3 (D), R41.2, TP22.1
/RBF_SIGNAL_2: Q17.3 (D), R15.2, TP23.1, U2.10
/VOUT_I: J1.8, R40.1, U27.13 (IMON)
GND: C1.2, C2.2, C3.2, C4.2, C5.2, C6.2, C7.2, C8.2, C9.2, C10.2, C11.2, C12.2, C13.2, C14.2, C15.2, C16.2, C17.2, C18.2, C19.2, C20.2, C21.2, C29.2, CSBI_1.1, CSBI_1.2, CSBI_1.3, CSBI_1.4, CSBI_1.9, CSBI_1.10, CSBI_1.23, CSBI_1.24, CSBI_1.33, CSBI_1.34, CSBI_1.41, CSBI_1.42, CSBI_1.47, CSBI_1.48, CSBI_1.49, CSBI_1.50, CSBI_2.1, CSBI_2.2, CSBI_2.3, CSBI_2.4, CSBI_2.9, CSBI_2.10, CSBI_2.17, CSBI_2.18, CSBI_2.27, CSBI_2.28, CSBI_2.41, CSBI_2.42, CSBI_2.47, CSBI_2.48, CSBI_2.49, CSBI_2.50, H1.1, H2.1, H3.1, H4.1, J1.4, J1.6, J1.11, J2.2, J3.2, J4.2, J6.2, J8.5, J8.6, J8.9, Q1.2 (S), Q6.2 (S), Q7.2 (S), Q9.2 (S), Q10.2 (S), Q11.1 (S1), Q11.3 (S2), Q12.1 (S1), Q12.3 (S2), Q13.2 (S), Q14.2 (S), Q15.2 (S), Q17.2 (S), Q18.2 (S), Q19.1 (S1), Q19.3 (S2), Q20.2 (S), Q21.2 (S), R5.2, R14.2, R18.2, R19.2, R20.2, R22.1, R38.2, R39.2, R40.2, U1.2 (GND), U2.7 (VSS), U2.11, U2.12, U3.2 (GND), U3.7 (EP), U27.5 (GND), U27.6 (LTCH), U27.14 (~PG), U27.15 (~FLT), U27.16 (~EN), U27.17 (EP)
unnamed: F1.2, Q19.5 (D2_1), Q19.6 (D2_2), Q19.7 (D1_1), Q19.8 (D1_2), Q19.9 (D1_3), Q19.10 (D2_3), Q19.11 (D1_4), Q19.12 (D2_4), Q20.1 (G), R20.1, TP6.1
unnamed: Q2.1, Q2.2, Q2.3, Q5.5, R1.2, R8.1, R9.1
unnamed: Q2.5, Q4.1, Q4.2, Q4.3, R9.2, R10.1, R11.1
unnamed: Q3.1, Q3.2, Q3.3, R37.1, R42.1, U27.10 (VOUT_2), U27.11 (VOUT_3), U27.12 (VOUT)
unnamed: Q3.5, Q5.1, Q5.2, Q5.3, R1.1, R41.1, R42.2
unnamed: Q19.2 (G1), Q19.4 (G2), U1.6 (OUT)
unnamed: Q20.3 (D), Q21.1 (G), R21.2
unnamed: R22.2, R24.1, U3.3 (HTH)
unnamed: R23.1, R24.2, U3.1 (LTH)
unnamed: TP5.1, U1.1 (RST/~RST), U2.13
unnamed: U2.1, U2.9
