SpaceTeam/STS1_EPS/(commit log)

2022-05-12 Added KiCad projects.
    [STS1_EPS_1.kicad_pcb, STS1_EPS_1.sch, STS1_EPS_2.kicad_pcb, STS1_EPS_2.sch, STS1_EPS_3.kicad_pcb, STS1_EPS_3.sch, STS1_EPS_4.kicad_pcb, STS1_EPS_4.sch]
2022-05-15 Added libraries.
    [STS1_EPS_1.kicad_pcb, STS1_EPS_1.kicad_sch]
2022-06-06 Worked on STS1_EPS.
    [STS1_EPS_1.kicad_pcb, STS1_EPS_1.kicad_sch, STS1_EPS_BATTERY.kicad_sch, STS1_EPS_BCC.kicad_sch, STS1_EPS_CSBI.kicad_sch, STS1_EPS_CSBI.sch, STS1_EPS_DEPLOYMENT_TIMER.kicad_sch, STS1_EPS_DS.kicad_sch]
2022-06-08 Worked on STS1_EPS_1.
    [STS1_EPS_1.kicad_pcb, STS1_EPS_1.kicad_sch, STS1_EPS_BATTERY.kicad_sch, STS1_EPS_BCC.kicad_sch, STS1_EPS_CSBI.kicad_sch, STS1_EPS_SC_Connectors.kicad_sch, STS_EPS_ADCS.kicad_sch]
2022-06-08 Worked on STS_EPS_1.
    [STS1_EPS_1.kicad_pcb, STS1_EPS_1.kicad_sch, STS1_EPS_BATTERY.kicad_sch, STS_EPS_ADCS.kicad_sch]
2022-06-28 Worked on STS1_EPS_1 and began work on STS1_EPS_2.
    [STS1_EPS_1.kicad_pcb, STS1_EPS_1.kicad_sch, STS1_EPS_1_BUS_GATE.kicad_sch, STS1_EPS_1_MPPT_BUS_JUNCTION.kicad_sch, STS1_EPS_2.kicad_pcb, STS1_EPS_2.kicad_sch, STS1_EPS_2_CSBI.kicad_sch, STS1_EPS_2_DT.kicad_sch]
2022-06-29 Finished first revision of schematic.
    [STS1_EPS_1.kicad_pcb, STS1_EPS_1.kicad_sch, STS1_EPS_1_BUS_GATE.kicad_sch, STS1_EPS_1_MPPT_BUS_JUNCTION.kicad_sch, STS1_EPS_1_ORING.kicad_sch, STS1_EPS_2.kicad_pcb, STS1_EPS_2.kicad_sch, STS1_EPS_2_BAT_STATE.kicad_sch]
2022-07-04 Worked on STS1_EPS_2 layout.
    [STS1_EPS_1.kicad_pcb, STS1_EPS_1.kicad_sch, STS1_EPS_1_MPPT_BUS_JUNCTION.kicad_sch, STS1_EPS_2.kicad_pcb, STS1_EPS_2.kicad_sch, STS1_EPS_2_CSBI.kicad_sch, STS1_EPS_2_DS_RBF.kicad_sch, STS1_EPS_2_DT.kicad_sch]
2022-07-06 Worked on STS1_EPS_1 layout.
    [STS1_EPS_1.kicad_pcb, STS1_EPS_1.kicad_sch, STS1_EPS_1_MPPT_BUS_JUNCTION.kicad_sch, STS1_EPS_1_ORING.kicad_sch, STS1_EPS_BATTERY.kicad_sch, STS1_EPS_BCC.kicad_sch, STS1_EPS_SC_Connectors.kicad_sch, STS1_EPS__1_CSBI.kicad_sch]
2022-07-13 Made STS1_EPS_2 inter EPS connector consistent to STS1_EPS_1.
    [STS1_EPS_2.kicad_sch, STS1_EPS_2_DT.kicad_sch, STS1_EPS_ANT_DEPLOY.kicad_sch]
2022-07-14 EPS_2 Layout nearly finished, alot DRC Errors
    [STS1_EPS_2.kicad_pcb]
2022-07-14 EPS_2 removes some DRC errors, added Areas
    sry for bad commit messages
    [STS1_EPS_2.kicad_pcb]
2022-07-16 Finished routing of STS1_EPS_1. DRC of layout is still outstanding.
    [STS1_EPS_1.kicad_pcb, STS1_EPS_1.kicad_sch, STS1_EPS_1_MPPT_BUS_JUNCTION.kicad_sch, STS1_EPS_BATTERY.kicad_sch, STS1_EPS_BCC.kicad_sch]
2022-07-17 Cleared all DRC errors of STS1_EPS_1.
    [STS1_EPS_1.kicad_pcb, STS1_EPS_1_MPPT_BUS_JUNCTION.kicad_sch, STS1_EPS_2.kicad_pcb, STS1_EPS_2.kicad_sch, STS1_EPS_2_BUS_GATE.kicad_sch, STS1_EPS_2_CSBI.kicad_sch, STS1_EPS_2_DT.kicad_sch, STS1_EPS_ANT_DEPLOY.kicad_sch]
2022-07-17 Reworked STS1_EPS_2. - Added Capacitor bank - Thickened some load bearing copper traces.
    [STS1_EPS_1.kicad_pcb, STS1_EPS_2.kicad_pcb, STS1_EPS_2.kicad_sch, STS1_EPS_2_CAP_BANK.kicad_sch, STS1_EPS_2_DT.kicad_sch, STS1_EPS_ANT_DEPLOY.kicad_sch]
2022-07-17 Added test points to STS1_EPS_2.
    [STS1_EPS_2.kicad_pcb, STS1_EPS_2.kicad_sch, STS1_EPS_2_DS_RBF.kicad_sch, STS1_EPS_2_DT.kicad_sch, STS1_EPS_ANT_DEPLOY.kicad_sch]
2022-07-17 Added testpoints to STS1_EPS_1.
    [STS1_EPS_1.kicad_pcb, STS1_EPS_1.kicad_sch, STS1_EPS_1_MPPT_BUS_JUNCTION.kicad_sch, STS1_EPS_1_ORING.kicad_sch, STS1_EPS_BATTERY.kicad_sch, STS1_EPS_BCC.kicad_sch]
2022-07-20 Solder mask was incorrectly set for U27 and U28 of STS1_EPS_1. Fixed that.
    [STS1_EPS_1.kicad_pcb, STS1_EPS_2.kicad_pcb]
2022-07-26 Added part numbers to some of the components. No functional changes.
    [STS1_EPS_1.kicad_sch, STS1_EPS_1_MPPT_BUS_JUNCTION.kicad_sch, STS1_EPS_BATTERY.kicad_sch, STS1_EPS_BCC.kicad_sch, STS1_EPS__1_CSBI.kicad_sch]
2023-06-13 Added some missing 3d files.
    [STS1_EPS_1.kicad_pcb]
2023-08-23 Renamed STS1_EPS_2 to STS1_EPS_3.
    [STS1_EPS_3.kicad_pcb, STS1_EPS_3.kicad_sch, STS1_EPS_3.sch, STS1_EPS_3_BAT_STATE.kicad_sch, STS1_EPS_3_BUS_GATE.kicad_sch, STS1_EPS_3_CAP_BANK.kicad_sch, STS1_EPS_3_CSBI.kicad_sch, STS1_EPS_3_DS.kicad_sch]
2023-08-26 Revert "Renamed STS1_EPS_2 to STS1_EPS_3."
    This reverts commit 47631bb2a940810a2f7b8517a6bea59395bf86b8.
    [STS1_EPS_2.kicad_pcb, STS1_EPS_2.kicad_sch, STS1_EPS_2.sch, STS1_EPS_2_BAT_STATE.kicad_sch, STS1_EPS_2_BUS_GATE.kicad_sch, STS1_EPS_2_CAP_BANK.kicad_sch, STS1_EPS_2_CSBI.kicad_sch, STS1_EPS_2_DS.kicad_sch]
2023-08-29 worked on sts1_eps_1
    [STS1_EPS_1.kicad_pcb, STS1_EPS_1.kicad_sch, STS1_EPS_1_MPPT_BUS_JUNCTION.kicad_sch, STS1_EPS_2.kicad_sch, STS1_EPS_2_BATTERY.kicad_sch, STS1_EPS_2_BAT_STATE.kicad_sch, STS1_EPS_2_BUS_GATE.kicad_sch, STS1_EPS_2_DT.kicad_sch]
2023-09-17 Worked on STS1_EPS_1 and STS1_EPS_2.
    [STS1_EPS_1.kicad_pcb, STS1_EPS_1.kicad_sch, STS1_EPS_2.kicad_sch, STS1_EPS_2_BATTERY.kicad_sch, STS1_EPS_2_DT.kicad_sch, STS1_EPS_ANT_DEPLOY.kicad_sch, STS1_EPS_BCC.kicad_sch, STS_EPS_ADCS.kicad_sch]
2023-09-17 STS1_EPS_1 no errors.
    [STS1_EPS_1.kicad_pcb]
2023-09-17 Worked on STS1_EPS_2.
    [STS1_EPS_1.kicad_pcb, STS1_EPS_1.kicad_sch, STS1_EPS_2.kicad_sch, STS1_EPS_2_BATTERY.kicad_sch, STS1_EPS_2_BAT_STATE.kicad_sch, STS1_EPS_2_BUS_GATE.kicad_sch, STS1_EPS_2_CAP_BANK.kicad_sch, STS1_EPS_2_CSBI.kicad_sch]
2023-09-19 STS1_EPS_2 no errors.
    [STS1_EPS_2.kicad_pcb, STS1_EPS_2.kicad_sch, STS1_EPS_2_BATTERY.kicad_sch, STS1_EPS_2_CAP_BANK.kicad_sch, STS1_EPS_2_CSBI.kicad_sch, STS1_EPS_2_DS_RBF.kicad_sch, STS1_EPS_2_DT.kicad_sch, STS1_EPS_ANT_DEPLOY.kicad_sch]
2023-09-20 Added a logic voltage, so that the deployment circuit breaker FETs also work, when battery is fails.
    [STS1_EPS_1.kicad_pcb, STS1_EPS_1.kicad_sch, STS1_EPS_1_MPPT_BUS_JUNCTION.kicad_sch, STS1_EPS_2.kicad_pcb, STS1_EPS_2.kicad_sch, STS1_EPS_2_BATTERY.kicad_sch, STS1_EPS_2_BAT_STATE.kicad_sch, STS1_EPS_2_CAP_BANK.kicad_sch]
2023-09-27 Moved the battery connector a bit, so that it does not collide with the inter-eps connector. Also resolved all warnings in the layout.
    [STS1_EPS_1.kicad_pcb, STS1_EPS_2.kicad_pcb, STS1_EPS_2.kicad_sch, STS1_EPS_2_BATTERY.kicad_sch, STS1_EPS_2_BAT_STATE.kicad_sch, STS1_EPS_2_BUS_GATE.kicad_sch, STS1_EPS_2_CAP_BANK.kicad_sch, STS1_EPS_2_CSBI.kicad_sch]
2023-10-05 Minor changes.
    [STS1_EPS_1.kicad_pcb, STS1_EPS_2.kicad_pcb, STS1_EPS_2_BATTERY.kicad_sch, STS1_EPS_2_BAT_STATE.kicad_sch, STS1_EPS_2_BUS_GATE.kicad_sch, STS1_EPS_2_CAP_BANK.kicad_sch, STS1_EPS_2_CSBI.kicad_sch, STS1_EPS_2_DS_RBF.kicad_sch]
2023-10-16 Adjusted position of the x- panel connector.
    [STS1_EPS_1.kicad_pcb]
2023-10-26 Added part numbers to CSBI and inter EPS connectors. Also added some missing 3d files.
    [STS1_EPS_1.kicad_pcb, STS1_EPS_1.kicad_sch, STS1_EPS_1_MPPT_BUS_JUNCTION.kicad_sch, STS1_EPS_2.kicad_pcb, STS1_EPS_2.kicad_sch, STS1_EPS_2_BATTERY.kicad_sch, STS1_EPS_2_BAT_STATE.kicad_sch, STS1_EPS_2_BUS_GATE.kicad_sch]
2023-10-29 Changed connectors of STS_EPS_1 ...again.
    [STS1_EPS_1.kicad_pcb, STS1_EPS_1.kicad_sch, STS1_EPS_BCC.kicad_sch, STS1_EPS__1_CSBI.kicad_sch]
2024-04-14 Ported kicad projects to KiCad 8.0.
    [STS1_EPS_1.kicad_pcb, STS1_EPS_1.kicad_sch, STS1_EPS_1_CurrentSources.kicad_sch, STS1_EPS_1_MPPT_BUS_JUNCTION.kicad_sch, STS1_EPS_1_ORING.kicad_sch, STS1_EPS_2.kicad_pcb, STS1_EPS_2.kicad_sch, STS1_EPS_2_BATTERY.kicad_sch]
2024-04-14 Changed some footprints that had the wrong shape in EPS 2.1.
    [STS1_EPS_2.kicad_pcb, STS1_EPS_2_BATTERY.kicad_sch, STS1_EPS_2_BAT_STATE.kicad_sch, STS1_EPS_2_BUS_GATE.kicad_sch, STS1_EPS_2_DT.kicad_sch]
2024-04-16 Rewired a falsely connected deployment switch.
    [STS1_EPS_2.kicad_sch]
2024-06-04 Intermediate commit.
    [STS1_EPS_2.kicad_sch, STS1_EPS_2_CSBI.kicad_sch]
2024-06-04 Added test points around MPPT bus current sense resistor.
    [STS1_EPS_1.kicad_sch, STS1_EPS_1_CurrentSources.kicad_sch, STS1_EPS_1_MPPT_BUS_JUNCTION.kicad_sch, STS1_EPS_1_ORING.kicad_sch, STS1_EPS_BCC.kicad_sch, STS1_EPS_SC_Connectors.kicad_sch, STS1_EPS__1_CSBI.kicad_sch, STS_EPS_ADCS.kicad_sch]
2024-06-04 Added test point directly at battery and after switch.
    [STS1_EPS_2.kicad_sch, STS1_EPS_2_BATTERY.kicad_sch, STS1_EPS_2_BAT_STATE.kicad_sch, STS1_EPS_2_BUS_GATE.kicad_sch, STS1_EPS_2_CAP_BANK.kicad_sch, STS1_EPS_2_CSBI.kicad_sch, STS1_EPS_2_DS_RBF.kicad_sch, STS1_EPS_2_DT.kicad_sch]
2024-06-06 Adjusted CSBI so it conforms to the new version of it.
    [STS1_EPS_1.kicad_pcb, STS1_EPS__1_CSBI.kicad_sch]
2024-06-08 Signals to the bus gate should now be provided with supply voltage the proper way.
    [STS1_EPS_1.kicad_pcb, STS1_EPS_1.kicad_sch, STS1_EPS_1_CurrentSources.kicad_sch, STS1_EPS_1_MPPT_BUS_JUNCTION.kicad_sch, STS1_EPS_1_ORING.kicad_sch, STS1_EPS_2.kicad_sch, STS1_EPS_2_BATTERY.kicad_sch, STS1_EPS_2_BAT_STATE.kicad_sch]
2024-06-08 Added possibilities to short single interrupt sources.
    [STS1_EPS_2_DS_RBF.kicad_sch, STS1_EPS_2_DT.kicad_sch]
2024-06-10 Fixed the logic behing the GATE_SIGNAL signal.
    [STS1_EPS_2.kicad_sch, STS1_EPS_2_BATTERY.kicad_sch, STS1_EPS_2_BAT_STATE.kicad_sch, STS1_EPS_2_BUS_GATE.kicad_sch, STS1_EPS_2_CAP_BANK.kicad_sch, STS1_EPS_2_CSBI.kicad_sch, STS1_EPS_2_DS_RBF.kicad_sch, STS1_EPS_2_DT.kicad_sch]
2024-07-18 Removed UCI connector from STS1_EPS_2 and merged UCI connector with J5 on STS1_EPS_1.
    [STS1_EPS_1.kicad_pcb, STS1_EPS_1.kicad_sch, STS1_EPS_1_CurrentSources.kicad_sch, STS1_EPS_1_MPPT_BUS_JUNCTION.kicad_sch, STS1_EPS_1_ORING.kicad_sch, STS1_EPS_2.kicad_sch, STS1_EPS_2_BATTERY.kicad_sch, STS1_EPS_2_BUS_GATE.kicad_sch]
2024-07-22 Added TVS diodes.
    [STS1_EPS_1.kicad_pcb, STS1_EPS_1.kicad_sch]
2024-07-22 Added even more ESD protection.
    [STS1_EPS_1.kicad_sch, STS1_EPS_SC_Connectors.kicad_sch, STS1_EPS__1_CSBI.kicad_sch]
2024-07-23 Reoriented coordinate system.
    [STS1_EPS_1.kicad_pcb, STS1_EPS_2.kicad_pcb, STS1_EPS_SC_Connectors.kicad_sch]
2024-08-06 Fixed some warnings and errors.
    [STS1_EPS_1.kicad_sch, STS1_EPS_1_MPPT_BUS_JUNCTION.kicad_sch, STS1_EPS_1_ORING.kicad_sch, STS1_EPS_2.kicad_sch, STS1_EPS_2_BATTERY.kicad_sch, STS1_EPS_2_BAT_STATE.kicad_sch, STS1_EPS_2_BUS_GATE.kicad_sch, STS1_EPS_2_CAP_BANK.kicad_sch]
2024-08-07 Fixed warnings and errors.
    [STS1_EPS_1_CurrentSources.kicad_sch, STS1_EPS_1_MPPT_BUS_JUNCTION.kicad_sch, STS1_EPS_2_BATTERY.kicad_sch, STS1_EPS_2_BAT_STATE.kicad_sch, STS1_EPS_2_BUS_GATE.kicad_sch, STS1_EPS_2_CAP_BANK.kicad_sch, STS1_EPS_2_CSBI.kicad_sch, STS1_EPS_ANT_DEPLOY.kicad_sch]
2024-08-27 STS1_EPS_1 now without errors.
    [STS1_EPS_1.kicad_pcb, STS1_EPS_SC_Connectors.kicad_sch, STS1_EPS__1_CSBI.kicad_sch]
2024-09-02 Reduced both EPS PCBs down to 0 DRC errors.
    [STS1_EPS_2.kicad_pcb, STS1_EPS_2_BATTERY.kicad_sch]
2024-09-02 - Fixed some minor warnings - Moved C4 on STS1_EPS_1, so it no longer collides with the COBC. - Bumped library sub repo.
    [STS1_EPS_1.kicad_pcb, STS1_EPS_2.kicad_pcb]
2024-09-05 Added part numbers for some ESD diodes.
    [STS1_EPS_2.kicad_sch, STS1_EPS_SC_Connectors.kicad_sch]
2024-09-12 Added 3D models to some footprints.
    [STS1_EPS_1.kicad_pcb, STS1_EPS_2.kicad_pcb]
2024-09-14 Fixed diode values for good.
    [STS1_EPS_2.kicad_sch, STS1_EPS_SC_Connectors.kicad_sch]
2024-09-14 Made the label names at the UCI connector more consistent.
    [STS1_EPS_1.kicad_sch, STS1_EPS_SC_Connectors.kicad_sch]
2024-09-14 Removed the ideal diodes at the UCI UART RX/TX lines. Added TVS diodes to those lines.
    [STS1_EPS_1.kicad_pcb, STS1_EPS_SC_Connectors.kicad_sch]
2024-09-14 Added tolerances to some resistors that should be precise.
    [STS1_EPS_1_CurrentSources.kicad_sch, STS1_EPS_1_MPPT_BUS_JUNCTION.kicad_sch, STS1_EPS_SC_Connectors.kicad_sch, STS_EPS_ADCS.kicad_sch]
2024-09-14 Modified some resistor values slightly, so that they fall in common resistor series.
    [STS1_EPS_1_MPPT_BUS_JUNCTION.kicad_sch, STS1_EPS_2_BATTERY.kicad_sch, STS1_EPS_2_BAT_STATE.kicad_sch, STS1_EPS_2_BUS_GATE.kicad_sch, STS1_EPS_2_DT.kicad_sch, STS1_EPS_BCC.kicad_sch]
2024-09-14 Marked optional bypasses as "Do not place".
    [STS1_EPS_1_MPPT_BUS_JUNCTION.kicad_sch, STS1_EPS_2_BUS_GATE.kicad_sch, STS1_EPS_2_DS_RBF.kicad_sch, STS1_EPS_2_DT.kicad_sch]
2024-09-16 Added values to the capacitors of the capacitor bank.
    [STS1_EPS_2_CAP_BANK.kicad_sch]
2024-09-16 Added part number to fuse.
    [STS1_EPS_2_DT.kicad_sch]
2024-09-16 Logic gates now use ISO symbols consistently.
    [STS1_EPS_2.kicad_pcb, STS1_EPS_2_BATTERY.kicad_sch, STS1_EPS_2_DT.kicad_sch]
2024-09-17 Separated the SHDN pins of the logic- and power oring. Also added TVS diodes to them, as this is recommended by the datasheet.
    [STS1_EPS_1.kicad_pcb, STS1_EPS_1_ORING.kicad_sch, STS1_EPS_2.kicad_pcb, STS1_EPS_2_DT.kicad_sch, STS1_EPS_2_LOGIC_VOLTAGE.kicad_sch]
2024-09-18 Added a linear regulator to the power oring in STS1_EPS_2, since the components supplied by that power oring could not withstand that voltage.
    [STS1_EPS_2.kicad_pcb, STS1_EPS_2_LOGIC_VOLTAGE.kicad_sch]
2024-10-12 Added python script for replacing labels within KiCad.
    [STS1_EPS_SC_Connectors.kicad_sch, STS_EPS_ADCS.kicad_sch]
2024-10-12 Reverted two files to before the label change.
    [STS1_EPS_SC_Connectors.kicad_sch, STS_EPS_ADCS.kicad_sch]
2024-10-12 Changed net labels of the panel connectors, so they are consistent with the name of the respective connector.
    [STS1_EPS_1.kicad_pcb, STS1_EPS_1.kicad_sch, STS1_EPS_1_MPPT_BUS_JUNCTION.kicad_sch, STS1_EPS_SC_Connectors.kicad_sch, STS_EPS_ADCS.kicad_sch]
2024-10-16 Started adding part numbers to passive components.
    [STS1_EPS_1_CurrentSources.kicad_sch, STS1_EPS_1_MPPT_BUS_JUNCTION.kicad_sch, STS1_EPS_1_ORING.kicad_sch, STS1_EPS_BCC.kicad_sch, STS1_EPS_SC_Connectors.kicad_sch, STS_EPS_ADCS.kicad_sch]
2024-10-20 Added part numbers to components of STS1_EPS_1.
    [STS1_EPS_1.kicad_sch, STS1_EPS_1_CurrentSources.kicad_sch, STS1_EPS_1_MPPT_BUS_JUNCTION.kicad_sch, STS1_EPS_1_ORING.kicad_sch, STS1_EPS_BCC.kicad_sch, STS1_EPS_SC_Connectors.kicad_sch, STS1_EPS__1_CSBI.kicad_sch, STS_EPS_ADCS.kicad_sch]
2024-10-22 Added more part numbers.
    [STS1_EPS_2.kicad_pcb, STS1_EPS_2.kicad_sch, STS1_EPS_2_BATTERY.kicad_sch, STS1_EPS_2_BAT_STATE.kicad_sch, STS1_EPS_2_BUS_GATE.kicad_sch, STS1_EPS_2_CAP_BANK.kicad_sch, STS1_EPS_2_CSBI.kicad_sch, STS1_EPS_2_DS_RBF.kicad_sch]
2024-12-08 Fixed footprint of U3 and U6 on STS1_EPS_2.
    [STS1_EPS_2.kicad_pcb, STS1_EPS_2_BATTERY.kicad_sch, STS1_EPS_2_BUS_GATE.kicad_sch]
2025-01-09 * New symbol for U4 and U5 on STS1_EPS_2. * Made the tracing for U4 and U5 a bit better.
    [STS1_EPS_2.kicad_pcb, STS1_EPS_2_BAT_STATE.kicad_sch]
2025-08-26 Fixed deployment timer symbol having wrong pin numbers.
    [STS1_EPS_2.kicad_pcb, STS1_EPS_2_DT.kicad_sch]
2025-08-27 Fixed inhibit logic.
    [STS1_EPS_2_BATTERY.kicad_sch, STS1_EPS_2_BUS_GATE.kicad_sch, STS1_EPS_2_DS_RBF.kicad_sch, STS1_EPS_2_DT.kicad_sch]
2025-08-28 Fixed layout after changes to inhibit logic.
    [STS1_EPS_2.kicad_pcb, STS1_EPS_2_DT.kicad_sch]
2025-08-28 * Added resistor in front of NTC channel of both ADCs. * Changed signal name from ~BATT_INHIBIT to BATT_INHIBIT.
    [STS1_EPS_1.kicad_pcb, STS1_EPS_1.kicad_sch, STS1_EPS_2_BATTERY.kicad_sch]
2025-09-07 Added FETs to the CS pins of the EDU's housekeeping data interface.
    [STS1_EPS_1.kicad_pcb, STS_EPS_ADCS.kicad_sch]
2025-09-07 * Cell balancer is now deactivated by UVLO signal, rather than bat fault signal * Bat Fault signal is now an open drain output
    [STS1_EPS_2.kicad_pcb, STS1_EPS_2.kicad_sch, STS1_EPS_2_BATTERY.kicad_sch, STS1_EPS_2_BAT_STATE.kicad_sch, STS1_EPS_2_CSBI.kicad_sch]
2025-09-07 Fixed inhibit logic, again...
    [STS1_EPS_2.kicad_pcb, STS1_EPS_2_BATTERY.kicad_sch, STS1_EPS_2_DT.kicad_sch]
2025-09-07 Added resistor for the RBF pin.
    [STS1_EPS_1.kicad_pcb, STS1_EPS_2.kicad_pcb, STS1_EPS_2_DS_RBF.kicad_sch]
2026-04-15 feat(EPS PCB 2): start redesign & cleanup for less idle power consumption
    [STS1_EPS_2.kicad_sch, STS1_EPS_2_BATTERY.kicad_sch, STS1_EPS_2_BAT_STATE.kicad_sch, STS1_EPS_2_BUS_GATE.kicad_sch, STS1_EPS_2_CAP_BANK.kicad_sch, STS1_EPS_2_CSBI.kicad_sch, STS1_EPS_2_DS_RBF.kicad_sch, STS1_EPS_2_DT.kicad_sch]
